t-bowzer/KCPico/docs/KeybChord_Pico_Spec.md

# KeybChord (Pico Edition) — Requirements & Specification

**Project:** KeybChord — Raspberry Pi Pico (RP2040) Edition
**Description:** Turn any USB keyboard into an Omnichord-style MIDI controller using a Raspberry Pi Pico (RP2040), written in C++ on the Arduino-Pico core.
**Document status:** v1 (Pico port) — build-ready. Derived from the Raspberry Pi Zero 2 W spec (`KeybChord_Spec.md` v3). This edition retargets the project to a bare-metal RP2040 microcontroller: the firmware is C++ (not Python), keyboard input is via a **CH559 USB-host coprocessor** (not Linux `evdev`), MIDI output is **DIN/TRS + USB MIDI**, persistence is **JSON on LittleFS** (not SD/JSON files), and there is **no OS/systemd** (the board runs on power-up). Two minor items remain open (LCD line-2 layout and final rhythm list, Section 14) and are flagged inline with **[DRAFT — REVIEW]**; both are deferred to post-hardware testing and do not block implementation.
**Target audience:** Coding agent implementing the firmware.

---

## 1. Overview & Goals

### 1.1 Summary
KeybChord is a standalone MIDI controller. A standard USB keyboard is plugged into a Raspberry Pi Pico (RP2040), which acts as a **USB host** to enumerate the keyboard, interprets key presses as Omnichord-style musical actions (chords, strum plate, rhythm accompaniment), and emits MIDI over a 5-pin DIN connector (UART). An LCD1602 provides status and parameter feedback. The keyboard's Scroll Lock LED is used as a BPM indicator.

### 1.2 Goals
- Faithfully recreate the Omnichord playing paradigm (chord buttons + strum plate + rhythm) on a commodity USB keyboard.
- Emit standards-compliant MIDI via DIN (UART @ 31250 baud).
- Provide expressive, real-time control with low latency (<10 ms key-to-MIDI).
- Persist configuration via 40 recallable presets (5 banks × 8) on the Pico's onboard flash (LittleFS).

### 1.3 Non-Goals (v1)
- No onboard audio synthesis. KeybChord is a **MIDI controller only**; sound is produced by an external synth/DAW.
- No graphical UI beyond the LCD1602.
- No network/Bluetooth MIDI.

### 1.4 Implementation Constraints
- **Language:** C++17.
- **Platform / core:** Arduino-Pico core (earlephilhower) targeting RP2040 (Raspberry Pi Pico / Pico W).
- **Build system:** PlatformIO, with two environments — an on-device `pico` environment and a desktop `native` environment for unit-testing the pure-logic core.
- **USB keyboard input:** a **CH559** (WCH) acts as a USB **host** coprocessor, enumerating the keyboard (boot and/or report protocol, incl. NKRO) and forwarding parsed key events to the RP2040 over a UART bridge. There is no OS input layer; the keyboard is owned exclusively by the firmware.
- **MIDI output:** DIN and TRS via hardware UART (`Serial2` = UART1) at 31250 baud, 8N1, plus a USB MIDI device on the native USB port (see 3.4). DIN is the always-available path.
- **Persistence:** JSON on **LittleFS** in the Pico's onboard flash, parsed/serialized with ArduinoJson. Human-readable and user-editable via the flash filesystem.
- **No FPU:** RP2040 (Cortex-M0+) has **no hardware floating-point**. All timing-sensitive and per-event math (chord/voicing/strum/rhythm/clock) MUST be integer or fixed-point. In particular, **swing is stored and computed as a fixed-point integer** (see Sections 7.3 and 9). Floats are permitted only in cold paths (e.g. one-time config parsing), never in the real-time loops.
- **Portable core / hardware adapters:** All pure logic (chord/voicing/strum/rhythm computation, config/preset handling, keymap resolution, state) MUST have zero hardware/Arduino includes and be unit-testable on a desktop (`native` env) via GoogleTest. All hardware I/O (USB-host input, LCD, DIN/UART, keyboard LED, LittleFS) sits behind adapter interfaces with safe null/no-op fallbacks so the logic compiles and runs on the dev host without Pico hardware present.
- **No OS / autostart:** There is no operating system or systemd. The firmware runs from flash on power-up; "boot-to-ready" is simply the setup path (Section 10, NFR-4).
- **Project layout & VCS:** Self-contained PlatformIO project under a dedicated `keybchord/` directory, version-controlled with git. Default JSON templates ship in the repo (`data/`, flashed to LittleFS); generated/runtime files live on LittleFS on the device and are not committed.

### 1.5 Recommended Libraries (pinned defaults)
These are the recommended, commonly-used libraries for this hardware/stack. The agent may substitute with justification, but should keep the stack internally consistent.
| Purpose | Library | Notes |
|---|---|---|
| RP2040 Arduino core | `arduino-pico` (earlephilhower) | Provides Arduino API, dual-core (`setup1/loop1`), TinyUSB, LittleFS, hardware UARTs (`Serial1`/`Serial2`) |
| USB host stack | CH559 (WCH) USB-host coprocessor (8051 C firmware) over a UART bridge | HID keyboard host incl. hubs + report/NKRO; key events forwarded to the RP2040 over UART |
| DIN MIDI (UART) | Arduino `Serial2` (UART1, raw bytes) | 31250 baud 8N1; optional `Arduino MIDI Library` for framing |
| LCD1602 over PCF8574 I2C | `hd44780` (by Bill Perry) or `LiquidCrystal_I2C` | PCF8574 I/O-expander mode over `Wire` |
| JSON parse/serialize | `ArduinoJson` (bblanchon) | Config/preset/pattern read/write on LittleFS |
| Filesystem | `LittleFS` (bundled with core) | Onboard-flash persistence |
| Unit testing (desktop) | `GoogleTest` | `native` PlatformIO env; pure-core tests (Section 11) |

### 1.6 Deliverables & Build Sequence
The agent will produce the entire firmware project. Work in the following ordered steps; after each step, stop and present the result for the user to test and give feedback before proceeding.

1. **Repo structure & scaffolding.** Create the PlatformIO project layout, `platformio.ini` with `pico` + `native` environments and pinned library deps (per 1.5), entry point (`src/main.cpp` with `setup/loop` and `setup1/loop1`), a config loader that generates default `config.json` and default preset banks on LittleFS on first boot (Section 12.x robustness), and hardware adapter interfaces with null fallbacks (input, LCD, MIDI out, keyboard LED, storage) so the pure core builds and runs on the `native` host. Verify: firmware builds for `pico`; native test target builds; app logic initializes and loads/creates config.
2. **Core framework.** Implement Input Manager (USB-host HID keyboard via the CH559 coprocessor + UART bridge), State Manager, MIDI Router (DIN via `Serial2`/UART1), Config/Preset store (LittleFS + ArduinoJson), and a **minimal USB-CDC debug log + MIDI monitor** (raw key events in, outgoing MIDI messages out) — the on-device feedback instrument for steps 2–5, since the LCD does not arrive until step 6. Verify: raw key events are captured on-device and observed via the USB-CDC debug log; a hardcoded note plays on the DIN output and appears in the MIDI monitor (and null-logs on the native host). No LCD required.
3. **Chord engine.** Root/quality resolution from the key grid, same-column + left-adjacent + leftmost combination matrix, voicing (root-position & smart), extensions, and the four play modes with correct note lifecycle. Verify: chords and combinations produce correct notes; play modes behave per spec.
4. **Strum plate.** Note-pool derivation, full + limited numpad layouts (independent of the keyboard's Num-Lock state), strum params, immediate edit pickup. Verify: strumming plays the active chord's notes correctly in both layouts.
5. **Rhythm engine.** Scheduler/clock (on the second core), JSON pattern playback on ch10, tempo/swing (fixed-point), mute, MIDI clock toggle, arpeggio/bass sync, and the keyboard-LED BPM indicator (FR-R8). Verify: patterns play; tempo/swing/mute/clock behave; Scroll Lock LED flashes on the beat when rhythm is enabled.
6. **Display manager.** LCD1602 idle screen (with dirty `*` indicator), parameter-edit feedback, and prompts. Verify: screen updates correctly for all events.
7. **Presets & banks.** JSON load/save on LittleFS, 80-slot navigation, save/clear with confirm (auto-cancel), per-function channels, defaults for uninitialized slots. Verify: presets save/recall/clear correctly.
8. **Polish.** Panic control, latency tuning, robustness/hot-plug, config validation/fallback, and **hardening/finalizing** the logging + MIDI monitor (over USB-CDC or UART debug) first introduced in step 2, and the full test suite. Verify: acceptance criteria (Section 13) pass.

---

## 2. Hardware Requirements

### 2.1 Bill of Materials
| Item | Purpose |
|---|---|
| Raspberry Pi Pico (RP2040) | Main compute unit (Pico W also fine; W's wireless is unused in v1) |
| USB keyboard | Primary input device |
| USB-A receptacle / breakout | Host port for the keyboard, wired to the **CH559** HP/HM pins. Receptacle pinout: pin 1 = VBUS (5V), pin 2 = D-, pin 3 = D+, pin 4 = GND. |
| CH559L (USB host coprocessor) | WCH 8051 MCU with a **hardware USB host controller**, hosting hubs + full-length descriptors + report/NKRO protocols and forwarding key events over UART (see 2.2). Replaces the PIO-USB software host. Powered from `3V3(OUT)`; runs off its internal oscillator (no crystal). |
| 2× 22Ω resistors (1/4 W) | **Required** series resistors on the CH559 HP/HM (D+/D-) lines. These are the only series elements on D+/D-; the keyboard supplies its own device-side pull-ups. |
| 2× 0.1 µF ceramic capacitors | Decoupling on the CH559 `VIN5` (pin 41) and `VDD33` (pin 42). |
| 1× tactile switch (BOOT) | CH559 bootloader entry — pulls `P4.6/XI/SCS` (pin 16) to `GND`; hold at power-up (see `docs/wiring.md` §Flashing the CH559). |
| 1× 4-pin 0.1" (2.54 mm) male header | CH559 **programming header** — `DP` (31), `DM` (32), `GND`, and `3V3` (intentionally **NC** on the v0.2 PCB). Mates with a USB-A plug breakout pigtail for flashing (see `docs/wiring.md` §Flashing the CH559). |
| LCD1602 display + PCF8574 I2C backpack | Status / parameter display. **Operated at 3.3V** so its I2C bus stays 3.3V-safe for the RP2040 (see 2.2). |
| 5-pin DIN socket (DIN-5, 180°) | Classic MIDI output. |
| 3.5 mm TRS (Type-A) MIDI out jack | Secondary MIDI output, wired **in parallel** with the DIN current loop (shares the same 10Ω/33Ω loop resistors — no additional parts). TRS Type-A: tip = DIN pin 5 (data), ring = DIN pin 4 (source), sleeve = DIN pin 2 (GND). See 2.2. |
| 1× 10Ω + 1× 33Ω resistor (1/4 W) | MIDI OUT current-loop resistors for a **3.3V** loop (10Ω in series with the `GP8` TX line, 33Ω from `3V3(OUT)` to DIN pin 4 — also fed to the TRS ring), per the MIDI 1.0 Electrical Specification update (2014), which standardizes 3.3V signaling. See 2.2. |
| 1× 100 µF electrolytic capacitor (bulk) | Bulk decoupling on the 5V rail near the keyboard receptacle; absorbs hot-plug inrush and prevents Pico brownout / USB-stack wedge (see 2.3, NFR-5). |
| 5V power source (≥ 1 A recommended), optionally **switched** | Powers the Pico + keyboard. **Canonical topology:** power the Pico via its native micro-USB connector; the keyboard draws 5V from `VBUS`. Size the supply for both (Pico ≤ ~150 mA + keyboard 100–500 mA; more for backlit/RGB keyboards). A regulated 5V into `VSYS` is an alternative, but do **not** source both simultaneously without an external `VSYS` series Schottky diode (see 2.3). A **master power switch** is **recommended but not required**; because the micro-USB→`VBUS` path is a direct board trace, the switch lives off-board — an inline USB power switch or a switched PSU (see 2.3). |

> **Resistor wattage:** all resistors in this design (2× 22Ω USB series, 10Ω + 33Ω MIDI loop) dissipate only milliwatts in normal operation, so standard **1/4 W (0.25 W)** parts are used throughout with large margin.

> **Note vs. the Pi Zero 2 W BOM:** the micro-USB-to-USB-OTG adapter is **removed** (no longer applicable). A USB MIDI interface/cable is **removed** (no USB MIDI device role — DIN only). USB hub is **not required** and is not part of the design.

### 2.2 Connections

This is the **canonical default pin map**. GPIO are given with their physical Pico header pin numbers. The only supported overrides are the CH559 UART pins and the DIN/I2C pins (via `pins.h`); the wiring below and the firmware defaults must always agree. The authoritative map lives in the roadmap (§5.2).

- **Keyboard (USB host, CH559L coprocessor on UART0):** USB keyboard → USB-A receptacle → **CH559L** → Pico `Serial1` (UART0). **`GP0` (header pin 1) = TX → CH559 `RXD1` (pin 27), `GP1` (header pin 2) = RX ← CH559 `TXD1` (pin 28)**. The CH559 **HP** (pin 29) / **HM** (pin 30) run to the receptacle through **22Ω series resistors** (the only series elements; the keyboard provides device-side pull-ups); `DP` (pin 31) / `DM` (pin 32) go to a 4-pin programming header (its `3V3` pin is intentionally **NC** on the v0.2 PCB). **Power:** `VIN5` (pin 41) and `VDD33` (pin 42) both to `3V3(OUT)` (0.1 µF decoupling; the internal LDO is bypassed below 3.6 V), `GND` (pin 18). `P4.6/XI/SCS` (pin 16) is the **BOOT** input (button to `GND`, hold at power-up); there is no board RESET button, so `RST` (pin 3) is left unconnected and a power-cycle resets the CH559. Signaling is full/low-speed USB at 3.3V logic levels. The keyboard is powered from `VBUS` (5V, header pin 40) + GND through the receptacle (receptacle pin 1 = VBUS, pin 2 = D-, pin 3 = D+, pin 4 = GND). The CH559 runs its own 8051-C host firmware and forwards parsed key events to the RP2040 over UART.
- **LCD1602 (I2C):** SDA→`GP4` (header pin 6), SCL→`GP5` (header pin 7) on I2C0. **VCC→3.3V (`3V3(OUT)`, header pin 36), GND→GND** — the backpack is run at 3.3V so the I2C bus stays within the RP2040's 3.3V range (do not power the backpack from 5V without a level shifter). Pull-ups: use the backpack's onboard pull-ups, or add 4.7 kΩ from SDA/SCL to 3.3V if absent. The firmware auto-probes the PCF8574 address at boot: try `0x27`, then `0x3F`; if neither ACKs, fall back to the null LCD adapter (no crash, per NFR-5). (`GP4`/`GP5` are the fixed default, chosen to avoid the UART and SPI pins.)
- **DIN MIDI out (UART, 3.3V current loop):** DIN uses **`Serial2` (UART1), TX on `GP8` (header pin 11)**, chosen to avoid the UART0 (`GP0`/`GP1`) and I2C (`GP4`/`GP5`) pins. In firmware, call `Serial2.setTX(8)` before `Serial2.begin(31250)` (UART1's default TX pin is not guaranteed to be `GP8`). MIDI OUT is driven **directly from the 3.3V `GP8` TX pin** — a standards-compliant 3.3V current loop per the MIDI 1.0 Electrical Specification update (2014). Wiring: `GP8` → 10Ω → DIN pin 5; `3V3(OUT)` (header pin 36) → 33Ω → DIN pin 4; GND → DIN pin 2. 31250 baud, 8N1. Notes: the RP2040 UART TX is push-pull, not open-drain — a benign deviation from the letter of the spec that works with standard opto-isolated MIDI inputs (see references, roadmap §5.5); optional ferrite beads on the DIN signal pins reduce RFI (2014 update, optional). No transistor/level-shifter is required at 3.3V.
- **TRS MIDI out (3.5 mm, Type-A, parallel with DIN):** A 3.5 mm TRS jack carries the same signal as the DIN loop, wired in parallel so both connectors work simultaneously (driving a second receiver on the same current loop is within the MIDI 1.0 spec). Type-A pinout: **tip = DIN pin 5** (data, the `GP8`→10Ω node), **ring = DIN pin 4** (source, the `3V3(OUT)`→33Ω node), **sleeve = DIN pin 2** (GND). No firmware change and no additional resistors are required.
- **Keyboard LEDs (BPM indicator):** The keyboard's Scroll Lock LED is driven by sending a **HID Output Report (SET_REPORT)** to the keyboard over the USB-host connection (FR-R8). No additional wiring required.

> **Pin-assignment rule:** CH559 UART0 (`GP0`/`GP1`), `Serial2`/UART1 TX (DIN, `GP8`), and I2C0 SDA/SCL (`GP4`/`GP5`) must not overlap. Pins are set in exactly one place — `pins.h` (CH559 UART, DIN TX, I2C) — which is the single source of truth mirrored by the wiring above. The canonical map is `GP0`/`GP1` (CH559 UART), `GP8` (DIN TX), `GP4`/`GP5` (I2C0); confirm on hardware during M12 bring-up and keep this section and roadmap §5.2 in sync.

> A rendered connection diagram of this pin map is in [`docs/wiring.md`](docs/wiring.md).

### 2.3 Hardware Notes & USB Topology
- The Pico has **one native USB port**. In this design that port is **not** used for the keyboard: instead, a **CH559L USB host coprocessor** on UART0 hosts the keyboard. The native USB port is left free for power and/or a USB-CDC debug/log console + USB MIDI device during development.
- **No host-vs-gadget conflict:** The keyboard is hosted on the CH559 (UART bridge) while USB MIDI + CDC live on the native USB port as a *device*, so there is **no** USB role conflict of the kind that affected the Pi Zero 2 W. This is a deliberate simplification of the original design risk.
- **Guaranteed MIDI path:** DIN (UART) is the always-available MIDI path. All functionality works over DIN; USB MIDI and TRS are additive.
- **Power (canonical):** Power the Pico via its native micro-USB connector; the keyboard draws 5V from `VBUS`. Use a supply rated **≥ 1 A** (Pico ≤ ~150 mA + keyboard 100–500 mA; size up for backlit/RGB keyboards). The 5V supply, USB cable, and connector must carry the **combined** Pico + keyboard current. (The keyboard load taps `VBUS`, which is *upstream* of the Pico's onboard `VBUS`→`VSYS` Schottky diode **D1**, so the keyboard current does not pass through D1.) Fit a **100 µF bulk capacitor** on the 5V rail near the keyboard receptacle to absorb hot-plug inrush and prevent Pico brownout / USB-stack wedge (supports NFR-5; a watchdog is the secondary safeguard).
  - **Master power switch (recommended, not required):** the Pico's micro-USB connector is soldered **directly** to `VBUS`, so there is no on-board break point for a master switch. A switch that cuts both the Pico *and* the keyboard therefore lives **off-board** — an **inline USB power switch** on the 5V cable or a **switched PSU** — rather than on the PCB. (A switch in `VBUS`→`VSYS` is *not* a master switch: it only cuts the Pico, leaving the keyboard's `VBUS` tap hot; `3V3_EN`/`RUN` also leave the board powered.)
  - **Back-feed safety rule:** The Pico already has an onboard Schottky (**D1**) between `VBUS` and `VSYS`. If you power an *alternative* way by injecting a regulated 5V into `VSYS`, do **not** also power via native USB unless that external `VSYS` feed goes through its **own series Schottky diode** (per the Raspberry Pi "Powering Pico" guidance) — otherwise the two sources fight through D1. Pick one power path. The `VSYS`-fed option is for hungry keyboards; the canonical native-USB→`VBUS` path needs no extra diode.
- **LCD 3.3V rail budget:** The LCD is powered from `3V3(OUT)` (header pin 36), which is the RP2040's onboard 3.3V regulator output (≈ 300 mA total, shared with the RP2040 itself). A plain LCD1602 + PCF8574 backpack draws only a few mA, but a **backlit** module can pull 20–40 mA; if using a high-draw/backlit LCD, keep it within the `3V3(OUT)` budget or power its backlight from a separate rail.
- **USB host maturity:** Full-speed/low-speed HID keyboard hosting (incl. hubs and long descriptors) is handled by the CH559 coprocessor. N-key rollover is limited by the *keyboard's* HID report protocol (boot protocol commonly caps at 6 simultaneous keys) — see NFR-6.

---

## 3. System Architecture

### 3.1 Module Overview
The system is a set of cooperating modules coordinated by a central state manager, split across the RP2040's **two cores**.

| Module | Responsibility |
|---|---|
| Input Manager | Receive parsed key events from the CH559 over the UART bridge; track pressed keys & modifiers; debounce; emit semantic input events. |
| Keymap Resolver | Translate raw HID usage codes + modifier state into logical actions (chord select, function toggle, strum, navigation). |
| Chord Engine | Maintain active chord state; compute voicings; handle play modes (held/press-to-play/arpeggio/silent). |
| Strum Engine | Map strum keys to notes of the current chord; apply strum params. |
| Bass Engine | Walking bass line driven by the rhythm beat; own octave/duration/velocity/channel. |
| Rhythm Engine | Sequencer/clock; emit GM drum notes on ch10; provide timing to chord arpeggio sync and the walking bass; tempo & swing (fixed-point). |
| MIDI Router | Emit MIDI messages to the DIN/UART output; per-function channel routing. |
| Display Manager | Render idle screen and transient parameter-edit screens on LCD1602. |
| LED Indicator | Drive the keyboard's Scroll Lock LED via HID Output Report; flash the BPM indicator in sync with the Rhythm Engine clock (FR-R8). |
| Preset/Config Store | Load/save global config and 40 presets as JSON on LittleFS. |
| State Manager | Owns global runtime state; mediates between modules; central source of truth (incl. `pending_params` vs `active_params`). |

### 3.2 Cores, Event Loop & Timing
- **Core 0 — real-time input and output path:** USB-host polling → Input Manager → Keymap Resolver → engines mutate state → MIDI Router dispatch over UART. Target key-to-MIDI latency <10 ms (NFR-1). Rhythm/clock MIDI from Core 1 is drained by a priority service at the top of the loop, between input events, and before LCD/UI work. UART writes are effectively non-blocking at MIDI baud for the small messages involved.
- **Core 1 — rhythm/clock scheduler:** a monotonic-time scheduler (`micros()` / `time_us_64()` / hardware timer) drives tempo/swing, rhythm steps, MIDI-clock ticks (24 PPQN), arpeggio sync, the walking bass, and the Scroll Lock LED beat callback. Target step jitter <2 ms (NFR-2). LED HID writes happen here, off the Core 0 critical path.
- **Shared state:** the State Manager mediates cross-core access; the scheduler reads a consistent snapshot of chord/arp params. Use lightweight synchronization appropriate to RP2040 dual-core (e.g. the SDK's spin-lock/`mutex`/inter-core FIFO or double-buffered snapshots). Keep shared mutable state minimal.
- **No FPU:** all real-time math (Section 1.4) is integer/fixed-point; swing in particular is fixed-point (Sections 7.3, 9).

### 3.3 Data Flow
`CH559 host (USB) → UART bridge` → Input Manager → Keymap Resolver → (Chord | Strum | Bass | Rhythm | Nav | Param) action → State Manager → engines produce MIDI events → MIDI Router → DIN/UART. Display Manager and LED Indicator observe State Manager / scheduler for updates.

### 3.4 MIDI Output Detail
- **DIN/UART:** Open `Serial2` (UART1) at 31250 baud, 8N1; write raw MIDI bytes.
- **USB MIDI device (native USB):** the RP2040's native USB port presents a TinyUSB **composite CDC (debug log) + MIDI** device; the MIDI router fans every outgoing message to the USB MIDI interface. USB MIDI is gated by `midi.usb_enabled` (default on); when off, the interface still enumerates but no bytes are sent.
- Per-function channel/route is applied per message (chord/strum/rhythm channels, Section 4.5).
- The output must degrade gracefully if nothing is connected on the far end (the firmware keeps transmitting; an unconnected DIN is not an error).
- The keyboard is hosted on the **CH559 coprocessor** (over UART0), so the native USB port is free for power + CDC debug + USB MIDI — there is no host/gadget role conflict.

---

## 4. Functional Requirements

### 4.1 Chord Function
- **FR-C1** Letter keys act as chord buttons per the Key Map (Section 5). Each letter selects a chord root/type.
- **FR-C2** Chord button combinations follow Omnichord logic (Section 6.3), e.g. major+7th = maj7, minor+7th = min7, major+minor = diminished.
- **FR-C3** Supported play modes (all v1). Note lifecycle is specified in FR-C10:
  - *Held:* chord sounds on trigger and sustains until the next chord is pressed or panic/cancel is used (see FR-C10).
  - *Press-to-play:* chord triggers once on press (note-on), releases on key-up.
  - *Arpeggio:* chord notes played sequentially in one of several patterns (see 6.7); when rhythm is enabled, arpeggiation follows rhythm timing.
  - *Pattern:* chord tones played through the selected chord pattern's 16th-note grid (6.10), in lockstep with the rhythm clock; momentary (releases on key-up).
  - *PatternHold:* like *Pattern*, but latches on key release until the next chord / cancel.
  - *Silent (strum-only):* no chord notes sounded directly; chord defines the note pool for the strum plate only.
- **FR-C4** Adjustable chord parameters: note duration, velocity, pan (CC10), chord roll, minimum note count, minimum interval, inversion, arpeggio mode, arpeggio rate, and chord pattern, via the Chord Edit menu (5.4). Values shown on LCD when edited.
- **FR-C5** Chord octave shift via `+` / `-` keys (Section 5), clamped to a sensible MIDI range.
- **FR-C6** Voicing mode is a live-toggleable parameter (`root_position` ⇄ `smart` voice-leading), saved per-preset (see Section 6.4).
- **FR-C7** Chord extensions (add9, add11, add13) are **held modifiers**, not toggleable parameters. Holding `Left` arrow adds add9, `Down` arrow adds add11, and `Right` arrow adds add13 to the currently-held chord (they latch per chord; see 5.4). They are **not** saved per-preset.
- **FR-C8** Left-adjacent chord combinations (newer Omnichord behavior): Major + left-adjacent 7th = **sus4**; Major + left-adjacent Minor = **add9**. Leftmost column uses the `` ` `` key as modifier source (see 6.3).
- **FR-C9** **Parameter latching in Held mode:** while chord mode is `held`, changing any chord parameter (note duration, velocity, pan, octave, voicing mode, chord roll, min notes, min interval, inversion, arp mode, arp rate, channel, chord type/combination) — **including loading a preset** — must NOT alter notes that are currently sounding. The change takes effect only on the **next** chord triggered. The currently-held chord retains the parameter values it was triggered with until it is released and re-triggered. (In other play modes, parameter changes may apply on the next note event per that mode's timing.)
- **FR-C10** **Note lifecycle per play mode:**
  - *Held:* chord sounds on trigger and sustains **indefinitely** until the next chord is pressed or the panic/cancel control is used. Pressing a new chord ends the previous one.
  - *Press-to-play:* note-on on key press; note-off on **key-up**.
  - *Arpeggio:* each arpeggiated note lasts `note_duration_ms` (chord param); the `arp_rate` subdivision sets the step timing from the free-running 24-PPQN master clock, so notes stay aligned with the beat LED whether or not the rhythm engine is running. If an arpeggiated chord starts within **30 ms before** the next arp step boundary, its first note is deferred to that boundary instead of sounding immediately (which would otherwise place the first two notes only milliseconds apart). Presses at/after the boundary or earlier than the window start immediately.
  - *Pattern / PatternHold:* each step's degree notes sound for `sustain_steps` (or `note_duration_ms` when percussive); the grid follows the rhythm clock when enabled, else the stored tempo.
  - *Silent:* no chord notes are sounded (strum pool only).
- **FR-C11** **Panic / all-notes-off:** `Super+Esc` immediately sends All-Sound-Off (CC120) and All-Notes-Off (CC123) on all channels to the DIN output, and clears internal active-note state. Used to recover from stuck notes.
- **FR-C12** **Chord press grouping:** chord-grid presses within a 15 ms window are treated as one chord event. This prevents a combination such as `T` + `B` (Cmaj7) from sounding the first key's chord and then the combination when the two keys arrive in consecutive USB reports. A quick tap that releases all keys before the window expires still triggers the grouped chord.

### 4.2 Strum Plate
- **FR-S1** Number keys simulate the strum plate, playing the notes of the currently selected chord spread across octaves. Per preset, the **top-row** keys `1`…`0` may instead be macro keys (FR-S9); the numpad is always the strum plate.
- **FR-S2** Two layouts:
  - *Full:* number row (top-of-keyboard number keys `1 2 3 4 5 6 7 8 9 0`) and/or full numpad. The numpad strum set is `Num Lock / * 0 . 1 2 3 4 5 6 7 8 9` (the top-row keys `Num Lock`, `/`, `*` are included). The numpad `Keypad +` / `Keypad -` keys are **NOT** part of the strum plate; they adjust the strum octave (see 5.5).
  - *Limited strum keys* (toggle): numpad center path `0 → . → 2 → 3 → 5 → 6 → 8 → 9 → / → *` for a more realistic feel.
- **FR-S3** Strum parameters (via the Strum Edit menu, 5.5): octave, note duration, note velocity, layout, strum mode, strum root, scale. Shown on LCD when edited.
- **FR-S7** Strum mode selects the note-pool source: **follow-chord** (default; the active chord's pitch classes, 6.6), **scale** (a selectable root pitch class + scale/mode — the standard major/minor/harmonic/melodic scales, the 7 modes, and pentatonic/blues), or **piano** (a selectable root; each strum key is one semitone higher than the last).
- **FR-S8** Note duration is a **minimum**: a held strum key sustains its note past `note_duration_ms` until the key is released; a quick tap still sounds for the full minimum duration.
- **FR-S4** Strum notes are derived from the active chord voicing (including in Silent mode).
- **FR-S5** Unlike Held-mode chords (FR-C9), the strum plate picks up parameter and chord edits **immediately** — the next strummed note reflects current parameters and the currently-selected chord, with no latching. During sequencer playback the currently sounding sequence chord becomes the selected chord, so FollowChord strumming tracks the sequence; a held/latched live chord still takes priority.
- **FR-S6** Numpad strum keys are identified via their raw HID **keypad usage codes** and behave identically **regardless of the keyboard's Num Lock state** (the firmware interprets keypad usages directly; Num Lock is ignored). The firmware never asserts Num Lock as a precondition.
- **FR-S9** **Per-preset top-row macros:** when `number_keys` is `"macro"`, the top-row keys `1`…`9`,`0` trigger ordered per-preset command bundles instead of strumming. Each command is a `set` / `toggle` / `cycle` / `inc` / `dec` parameter action, a per-piece `drum_mute`, or a raw `midi` byte sequence (including SysEx, with an optional cumulative `delay_ms`). Parameter actions apply atomically on key-down, with changes committed before mode/arp/pattern callbacks; MIDI commands are sent to DIN and USB immediately or at their scheduled delay. Each macro has a name (default `M1`…`M9`, `M0`, max 16 chars); the LCD shows `Macro <name> loaded`. Limits are 16 commands per key and 48 per preset (excess is truncated by the firmware; the configurator rejects it). `Super+1`…`Super+8` still loads presets. Macros are configured in the configurator; on-device Save preserves them and Clear resets them.

### 4.3 Rhythm Function
- **FR-R1** Selectable rhythm modes providing backing percussion, including original Omnichord rhythms plus additional patterns (Section 7).
- **FR-R2** Percussion output can be muted (rhythm timing continues for sync; drum notes suppressed).
- **FR-R3** Rhythm emits GM percussion notes on **MIDI channel 10**.
- **FR-R4** The Chord Engine's Arpeggio mode follows the free-running master clock (the same timebase as the beat LED and rhythm), including when the rhythm engine is stopped. Early arp starts are quantized: a chord starting within 30 ms before the next arp step boundary waits for that boundary, so the first two notes never bunch together. Chord-pattern starts are fully quantized to the rhythm: while the rhythm is running, step 0 always waits for the next rhythm step boundary. The walking bass (4.7) follows rhythm beat timing while the rhythm runs and free-runs at the preset tempo when it is stopped.
- **FR-R5** Tempo adjust via `Page Up` / `Page Down`; swing (and other rhythm parameters) adjust in the Rhythm Edit menu (`F10`, see 5.6).
- **FR-R6** Rhythm patterns are defined as step sequences in JSON on LittleFS (Section 7.2).
- **FR-R9** Per-drum-piece **note code** and **velocity** are editable (Drum Edit menu, opened by `Super+F11`; 5.6): every percussion instrument used by the shipped rhythms — kick, snare, hi-hat, open-hat, rimshot, clap, crash, ride, bongo, conga-lo, conga-hi, clave, and shaker — can be remapped to a different GM percussion note and given a fixed velocity (or "Auto" to follow the pattern's authored step velocity, or "Off" to mute the piece). Cycling a code auditions the selected sound once. Velocity parameters auto-repeat while the step key is held.
- **FR-R7** MIDI clock transmission (24 PPQN) can be toggled on/off in the Rhythm Edit menu (Clock Out, see 5.6); when on, clock is sent to the DIN output. Clock Out is **clock-only**: switching it **on** waits for the next 24-tick beat boundary (the same tick as the beat LED) and then streams `0xF8`; switching it **off** stops the stream immediately. No Start/Stop is sent automatically. **Double-tapping the Clock Out key (`F8` by default)** arms an explicit Clock Resync: MIDI Start (`0xFA`) is sent at the next 24-tick beat boundary, immediately before that tick's clock, so a slave that was stopped or restarted locally re-aligns with the beat LED. Resync also ensures Clock Out is on.
- **FR-R8** **Keyboard-LED BPM indicator:** the keyboard's **Scroll Lock** LED can flash in time with the Rhythm Engine clock as a visual tempo indicator. Default behavior: a short quarter-note flash on every beat, with a longer accented flash on beat 1 of the bar. The LED is driven by sending a **HID Output Report (SET_REPORT)** to the hosted keyboard. It blinks only while the Rhythm Engine is enabled (follows the active clock), and is disabled if `led.bpm_indicator` is off. Scroll Lock is used because it is not mapped to any chord/strum/function key; Caps Lock and Num Lock LEDs are left untouched to avoid confusion (Caps is a chord root; numpad state is irrelevant per FR-S6). This is best-effort visual feedback and must degrade gracefully if the LED is unavailable (missing keyboard, keyboard that rejects the output report, USB write failure) without affecting timing or MIDI output.

### 4.4 Presets
- **FR-P1** Presets store chord, strum, bass, and rhythm parameters plus MIDI channel assignments, the top-row `number_keys` mode, macro definitions, and own **10 chord-sequence slots** (sequences are stored per preset in `/sequences/`, 4.8/8.4).
- **FR-P2** 40 slots: 5 banks × 8 presets.
- **FR-P3** **Cursor navigation:** `Home` / `End` move a preset **cursor** (wraps across all 40 slots). The cursor auto-resets to the active slot after `display.cursor_timeout_ms` of idleness (default 5 s). `Enter` loads the slot under the cursor.
- **FR-P4** Move the cursor to the previous/next bank: `Super + Home/End` (wraps; the slot position is preserved).
- **FR-P5** Load preset in current bank: `Super + <number 1–8>` (loads directly), or move the cursor and press `Enter`.
- **FR-P6** Save preset: `Insert` (prompt: `Enter` to confirm, `Backspace` to cancel).
- **FR-P7** Clear preset: `Delete` (same confirm/cancel prompt; resets the live parameters and stores factory defaults).
- **FR-P8** All prompts and current bank/slot reflected on the LCD.
- **FR-P9** **Default initialization:** every preset slot that has never been saved (or has been cleared) loads factory-default parameters (see Parameter Reference, Section 9). There are no "empty" slots that fail to load.
- **FR-P10** **Prompt auto-cancel:** save/clear confirmation prompts auto-cancel after **5 seconds** of no key press. Additionally, pressing any chord or strum key immediately cancels the prompt (so the user can keep playing).
- **FR-P11** **Dirty-state indicator:** when the active runtime parameters differ from the stored values of the current preset, the LCD shows a dirty marker (`*`) next to the preset location. Saving clears the marker; loading a preset resets it.
- **FR-P12** **Default channels:** on default initialization, MIDI channels differ per function — chord = 1, strum = 2, bass = 3, rhythm = 10. The user may edit these; overlaps are permitted and are the user's responsibility.

### 4.5 MIDI Output
- **FR-M1** MIDI output via **DIN (UART)** and **USB MIDI (native USB device)**. Both outputs carry the same messages (the router fans out to both); USB MIDI can be disabled via `midi.usb_enabled` without affecting DIN.
- **FR-M2** Independent MIDI channels selectable per function (chord / strum / bass / rhythm), saved as part of the preset.
- **FR-M3** Rhythm defaults to channel 10 (GM percussion) but channel is configurable per FR-M2.
- **FR-M4** The system continues without error if the DIN cable is disconnected or nothing is listening (it keeps transmitting).

### 4.6 Info Display (LCD1602)
- **FR-D1** Idle screen shows the current chord name and preset location, with a dirty marker (`*`) when the active state differs from the stored preset, e.g.:
  ```
  Ebmaj7    *B1:P3
  q=120  Rk  >Held
  ```
  (Line 1: active chord + optional `*` dirty marker + bank/preset. Line 2: tempo, rhythm short-code, play mode — final layout **[DRAFT — REVIEW]**.)
- **FR-D2** Parameters are edited through six **parameter edit menus** (Chord, Rhythm, Strum, Bass, Drum, and Sequence; see 5.4–5.10), plus the three-kind **Pattern Edit** mode for bass, rhythm, and chord patterns (4.9, 5.11). Inside a menu the LCD shows the menu title on line 1 and the highlighted parameter on line 2. `Up`/`Down`/`Left`/`Right` and volume +/− scroll the parameter highlight; `Enter`/`Mute` select it. While selected, the same keys change the value live (shown as a transient full name/value screen) and the parameter remains selected indefinitely; `Enter`/`Mute` commits and deselects, while `Backspace`/`Esc` restores the value captured on selection and deselects. An unselected (browsing) menu auto-exits after `display.menu_timeout_ms`.
- **FR-D3** Save/clear/confirm prompts are shown on the LCD, including the auto-cancel behavior (FR-P10).

### 4.7 Bass Function (Walking Bass)
- **FR-B1** A **walking bass** line plays alongside the chord, following the Rhythm Engine's beat. It is a **separate engine** with its own parameters and edit menu (5.9); it is toggleable on/off (default off) and usable in Held, Press-to-play, and Arpeggio chord modes (silent in Silent mode).
- **FR-B2** The bass plays a fixed looping **interval cycle** on each beat of the bar (see 6.8): root → 3rd → 5th → 6th/7th → (repeat). The cycle length adapts to the pattern's meter (`beats_per_bar`; a 3/4 waltz cycles over root–3rd–5th only).
- **FR-B3** Bass voice parameters (5.9): enable, octave (whole-octave transpose from the base root, default −1), note duration, velocity, pattern, and MIDI channel (default 3; may equal any other function's channel). The bass follows the currently-selected chord's root and type (including in Held mode after key release).
- **FR-B4** The bass note is short/percussive (note-on with rapid note-off after `note_duration_ms`), mimicking the Omnichord's plucked double-bass "thump". It follows the rhythm clock's beat edges while the rhythm is running, and free-runs on the same 16th-note grid at the preset tempo when the rhythm is stopped, so the bass remains audible without drums (and resyncs to the shared step counter when the rhythm starts).
- **FR-B5** **Configurable bass patterns** (`bass.pattern`, 5.9): bass patterns are JSON files in `/bass/*.json` (the 9 built-ins plus user files, loaded like rhythm patterns). The built-ins are `Walking` (root-3rd-5th-6th/7th), `Whole`, `Half`, `Quarter`, `Half Alt`, `Quarter Alt`, `3/4 Alt`, `No 6th`, and `Hold` (root sustains while the chord is sounding — a held key in Press/Arp, indefinitely in Held). Patterns are a 16th-note grid of chord-degree codes (root/3rd/5th/6th-or-7th) so they follow the chord's root and type; whole/half notes sustain via an optional `sustain_steps` array. The beat-driven patterns fire on the rhythm 16th-note grid in lockstep with the drums.

### 4.8 Chord Sequencer (M14)
- **FR-Q1** Each preset owns **10 sequence slots** (selectable with `Ctrl+1`…`Ctrl+0`), stored in `/sequences/b<N>p<M>.json` as a compact JSON array of up to 10 slots. A slot is a loop of **1, 2, 4, or 8 bars** on the rhythm 16th-note grid, with a maximum of **64 chord-change events**. Selecting a different slot during playback queues it: the current sequence finishes its loop, then the new slot starts on its downbeat and continues looping. Selecting an empty slot stops playback at that boundary with `Seq empty`.
- **FR-Q2** **Recording:** arm record (`Ctrl+F9`). The normal rhythm pattern is muted immediately. The hi-hat guide stays **silent until the next bar boundary**, then plays **exactly one bar** of quarter-note closed hi-hats (downbeat accented), and recording begins at the bar boundary after that count-in bar. The hi-hat guide continues for the whole take. Only chord changes are recorded (no strum, no individual MIDI notes); onsets are quantized to the nearest 16th. Each event sustains until the next event or the loop end. When the take ends (auto or manual), the guide stops and the original pattern/mute state resumes. If the rhythm engine is disabled when record or play is pressed, it is enabled automatically and the drums are muted before the count-in/playback starts. Recording over a slot that already contains a sequence prompts `Overwrite Seq in slot N?` (Enter/Mute confirms, Backspace/Esc cancels) before anything is armed.
- **FR-Q3** **Settings snapshot:** at the start of a recording, the current chord parameters (octave, note duration, velocity, pan, voicing, chord roll, min notes, min interval, inversion, arp mode, chord pattern, play mode, arp rate) are captured once for the sequence. Playback honors the merged play mode, so recorded arpeggios and patterns reproduce; `PressToPlay` behaves as `Held` and `ArpHold`/`PatternHold` as their non-hold forms because sequence events have no key release. The MIDI channel is always live.
- **FR-Q4** **Playback:** arm play (`Ctrl+F10`), then playback loops from the next rhythm bar until stopped. Recorded settings are used per-setting unless that setting's **Live** bit is set in the configurator, or the on-device global switch is set to **Live** (then all settings, including play mode and arp rate, are live). Playback is synced to the rhythm clock.
- **FR-Q5** **Live override:** live chords remain available during playback. While a live chord is held or latched, sequence events are skipped; the sequence keeps advancing and resumes at the next event after the live chord ends.
- **FR-Q6** **Persistence and clearing:** sequences are per-preset, not copyable. Recording, bar changes, and clearing save the sequence file immediately. Clearing a preset (`Delete`) removes its sequence file. The firmware removes legacy preset banks 6–10 from v0.1 on boot to reclaim flash; users should back them up before upgrading.
- **FR-Q7** **On-device menu:** `Ctrl+F12` opens the **Seq Edit** menu (Slot / Bars / Settings). Default performance keys: `Ctrl+F9` record, `Ctrl+F10` play/stop, `Ctrl+F11` clear (confirm with `Enter`/`Backspace`), `Ctrl+1`…`Ctrl+0` select sequence slots 1–10. All actions are rebindable in `keymap.json` except `Ctrl+number`. The count-in/recording status uses a **persistent LCD screen** (`Rec arm`/`Wait bar`, then `Count-in`/`1 bar`, then `Recording N/M`) so it does not flash back to idle between bar updates.
- **FR-Q8** **Configurator editor:** a full per-preset sequence editor edits events on a bar/step grid with a chord picker (root, type, add9/add11/add13), bar length, the recorded settings snapshot, and per-setting Live checkboxes. The configurator rejects more than 64 events and invalid chord IDs; the firmware truncates excess events.

### 4.9 Bass, Rhythm & Chord Pattern Editors (M17)

- **FR-E1** On-device **Pattern Edit** screens create and edit user rhythm, bass, and chord patterns and can overwrite built-ins. Each pattern type has its own editor screen (Chord Pattern, Rhythm Pattern, Bass Pattern); there is no in-editor kind selector. A screen is opened by an **Edit Pattern** item at the end of its Chord/Rhythm/Bass parameter menu, or by direct keys: `Super+F9` (chord), `Super+F10` (rhythm), and `Super+F12` (bass) by default. These are rebindable `open_menu` actions using the menu names `chord_pattern`, `rhythm_pattern`, and `bass_pattern`. Each editor opens with the active preset's currently selected pattern for that type.
- **FR-E2** The editor works on an in-memory copy. Nothing is written until **Save** or **Save As**; leaving with unsaved changes prompts `Discard?`. **New** runs a guided flow: enter a name (prefilled with the unique default), choose Bars (1, 2, 4, or 8), then answer `Record now?` / `Ent/Bk`. Accepting starts the count-in immediately; declining keeps the new pattern in the command menu and shows `New Pat N` / `Created`. Esc during name or bars cancels creation and restores the previous pattern. New patterns inherit the live rhythm meter (`steps_per_bar`: 16 in 4/4, 12 in 3/4). Editing preserves the pattern's existing meter and length; the stored length is `bars * steps_per_bar`.
- **FR-E3** **Recording:** the user selects Bars and Quantize (`1/4`, `1/8`, or `1/16`, default `1/16`), then Record. If the rhythm engine is off it is enabled for the session (and restored on exit) and its normal pattern is suppressed. Recording follows the M14 count-in: one bar of quarter-note closed hi-hats (downbeat accented), then N bars are recorded while the hi-hat guide continues; recording stops automatically at the end of the take. A pad pressed before the first recorded step is ignored. Live chord-grid keys remain available; the top-row strum/macro path is disabled, and keypad keys are captured as pattern pads instead of the normal strum path.
- **FR-E4** **Recording pads:** Rhythm uses the 13 Num-Lock-independent numpad keys in canonical order (`1`–`9`, `0`, `.`, `/`, `*` = kick, snare, hi-hat, open-hat, rimshot, clap, crash, ride, bongo, conga-lo, conga-hi, clave, shaker). Bass uses numpad `1`–`5` = root/3rd/5th/6th-or-7th/root-one-octave-up and `0` = rest. Chord patterns use numpad `1`–`4` = root/3rd/5th/7th and `0` = clear; multiple degree pads at one step combine into the step's bitmask. A pad press auditions the sound and records at the nearest quantized step. Rhythm and chord-pattern recording are polyphonic; bass recording is monophonic (the last degree at a step wins). Rhythm hits record velocity `1` (default) or `127` (accent) as edited; bass and chord holds capture `sustain_steps` for the number of steps held.
- **FR-E5** **Overdub:** recording preserves steps and tracks that the take does not touch. Rhythm pads add/replace only their own track's step; chord degree pads add bits to the step; bass pads replace the degree at the step. A **Clear** command resets the working buffer to rests when a fresh take is wanted.
- **FR-E6** **Preview:** loops the working pattern from the next rhythm bar until stopped. The normal rhythm/bass playback is suppressed. Rhythm plays through the preset drum map; bass and chord patterns resolve their degrees through the current/last selected chord (C major if none). Live chords remain available; a live chord that takes over playback stops the preview, which can be restarted. Preview works before saving.
- **FR-E7** **Grid editor:** a two-line LCD editor. Rhythm selects one of the 13 standard pieces (Up/Down), shows one bar of 16/12 step cells, moves the cursor with Left/Right across steps and bars, and cycles `rest → hit → accent` with Enter. Bass shows degree cells and cycles `rest → root → 3rd → 5th → 6th/7th`; sustained steps display as `-`. Chord shows each step as a hex digit `0`–`F`; the line above decodes the cursor step's degrees, numpad `1`–`4`/`0` toggle bits, and sustained steps display as `-`. The cursor cell is shown as `>`; editing a sustained step breaks its sustain. Custom-note rhythm tracks are preserved but not editable on device.
- **FR-E8** **Save/New/Rename/Delete:** `New` prompts for the pattern name and Bars and then offers `Record now?`, creating a user pattern in `/rhythms/userN.json`, `/bass/userN.json`, or `/chordpatterns/userN.json`; declining recording shows the two-line confirmation (`New Pat N` / `Created`, where N is the user-file number); `Save` overwrites the current file (built-in overwrite requires confirmation); `Save As` creates a new user file; `Rename` edits a user pattern's name using the preset name-entry flow; `Delete` removes a user pattern after confirmation. Built-ins cannot be renamed or deleted. Pattern names must be unique. The 32-total cap per kind and the combined pattern-file budget (8.5) are enforced; a save that would exceed either is rejected with `Pattern limit`.
- **FR-E9** **Compatibility and exclusion:** files use the existing rhythm/bass/chord JSON schemas; no new fields are required, and `bars` is inferred from `steps.length / steps_per_bar`. On-device and configurator writes use compact JSON (like sequence files) so the pattern budget stays predictable. On save the runtime library reloads and the saved pattern becomes the preset's selected pattern; presets store pattern names, so file ordering does not break references. On-device-created patterns appear in the configurator editors. Opening the pattern editor stops sequence recording/playback; starting a sequence stops the editor. Write actions are disabled while the MSC drive is active. Panic/all-notes-off stops recording and preview.
- **FR-E10** **Live pads and pass-through:** while the bass editor is open, the plain numpad pad keys play the bass (`KP1`–`KP5` = root/3rd/5th/6th-or-7th/root+8va, `KP0` = rest) using the current chord and the preset bass parameters; while the rhythm editor is open, the 13 numpad pad keys play drums through the preset `DrumMap` and rhythm channel; while the chord editor is open, `KP1`–`KP4` play root/3rd/5th/7th through the current/last chord, combining when several pads are held without retriggering already-held degrees, and `KP0` releases the live chord/clears the step. Pads audition outside recording and also write the pattern while recording. Bass/rhythm live pads work in command, grid, record, preview, and value-selected states; chord live pads work in those states except the chord grid, where `KP1`–`KP4`/`KP0` keep their bit-toggle editing role. Live pads do not work during name entry or confirmation prompts. Chord-grid keys remain live in every state. Direct parameter-modifying keymap actions (`cycle`/`set`/`inc`/`dec`/`toggle`, drum mute, tap tempo) also remain active, including while a value item is selected. Two exceptions keep the pattern editors emitting: in the rhythm editor, actions targeting `RhythmMute` (default F6) are ignored and the rhythm is forced unmuted for the session; in the bass editor, actions targeting `BassEnable` (default F7) are ignored and the bass is forced enabled. The rhythm editor restores the preset's prior mute/enable state on exit; the bass editor leaves the bass enabled so the edited pattern plays through the normal bass engine. The editor reserves its navigation keys (arrows, Volume +/− in menus/grid/value editing, Enter/Mute, Esc/Backspace, plain numpad); menu-open/preset/sequence/strum/top-row actions remain editor-owned, and the top-row strum/macro path stays disabled. Modified numpad keys are not live pads and follow their keymap actions; the numpad `+`/`−`/`Enter` keys are not live pads and retain their normal parameter actions. `F2`/`F3`/`F4` are not editor shortcuts; they retain their normal parameter actions.

---

## 5. Key Map

The chord grid faithfully reproduces the Omnichord's 3×12 button layout (5.1). Because `Shift` is used as a chord root, function access uses dedicated keys and menus rather than modifier combos (5.3).

### 5.1 Chord Buttons — Authentic Omnichord 3×12 Grid
The Omnichord exposes 36 chord buttons: three quality rows (Major / Minor / 7th) × twelve roots ordered around the **circle of fifths**. KeybChord reproduces this exactly by treating each of the three main keyboard rows as a quality row and using the row-bounding modifier keys as the outermost columns.

**Raw-HID requirement:** The firmware parses HID keyboard reports directly and owns the keyboard exclusively (there is no OS). This lets us treat `Caps Lock`, `Tab`, and both `Shift` keys as ordinary held keys (present in the report = held; absent = released), independent of any lock-LED semantics. Modifier bytes and key-array usages are read from the report. Consequently, **Shift is a chord root and is NOT used as a function modifier** anywhere in the key map — function access uses the dedicated menu keys and `Super` (see 5.3+).

**Row = quality, Column = root (circle of fifths, left→right):**
| Col | 1 | 2 | 3 | 4 | 5 | 6 | 7 | 8 | 9 | 10 | 11 | 12 |
|-----|---|---|---|---|---|---|---|---|----|----|----|----|
| **Root** | Db | Ab | Eb | Bb | F | C | G | D | A | E | B | F# |
| **Major** (top row) | `Tab` | `Q` | `W` | `E` | `R` | `T` | `Y` | `U` | `I` | `O` | `P` | `[` |
| **Minor** (home row) | `Caps` | `A` | `S` | `D` | `F` | `G` | `H` | `J` | `K` | `L` | `;` | `'` |
| **7th** (bottom row) | `LShift` | `Z` | `X` | `C` | `V` | `B` | `N` | `M` | `,` | `.` | `/` | `RShift` |

> The circle-of-fifths root order (Db Ab Eb Bb F C G D A E B F#) mirrors the authentic Omnichord OM-series button layout. This order is stored in config (Section 8.3) so it can be adjusted. Column 1 uses `Tab`/`Caps`/`LShift`; column 12 uses `[`/`'`/`RShift`.

**Same-column combinations** (same root — see matrix 6.3): Major `W` + 7th `X` = Eb7; Major `W` + Minor `S` + 7th `X` = Eb augmented.

**Left-adjacent combinations** (newer Omnichord models): pressing a Major key together with the **7th key one column to its left** yields **sus4**; pressing a Major key together with the **Minor key one column to its left** yields **add9**. See 6.3 for the full rule and the leftmost-column special case.

### 5.2 Strum Plate (number keys / numpad)
The three main letter rows plus their bounding modifiers are fully consumed by the chord grid (5.1). The strum plate therefore uses the **number row** and/or the **numpad**. Numpad keys are identified by their raw keypad HID usages and are **Num-Lock-independent** (FR-S6). The top row is strum by default; a preset can set `number_keys` to `"macro"` to use `1`…`0` as macro keys (FR-S9), leaving the numpad as the strum plate.
| Keys | Function |
|---|---|
| Number row `1 2 3 4 5 6 7 8 9 0` | Strum across chord notes (Full layout), or trigger macros when the preset's `number_keys` is `"macro"` |
| Numpad digits + decimal `0 . 1 2 3 4 5 6 7 8 9` + `Num Lock` `/` `*` | Strum (Full layout). `Keypad +`/`Keypad -` are excluded — they adjust the strum octave (5.5). `Num Lock`, `/` and `*` (the numpad top row) extend the full strum plate. |
| Limited strum path `0 . 2 3 5 6 8 9 / *` | Strum (Limited layout, when enabled) |

### 5.3 Function Modifier Convention
Because `Shift` (both keys) is a chord root, **Shift is never used as a function modifier**. Parameter editing uses dedicated menu keys: `F9`/`F10`/`F11`/`F12` open the Chord/Rhythm/Strum/Bass menus, `Super+F11` opens Drum, and `Ctrl+F12` opens the sequencer menu (see 5.4–5.10). The matching pattern editors are `Super+F9`, `Super+F10`, and `Super+F12` (5.11). Arrows/volume scroll parameters and `Enter`/`Mute` select one for editing.

Consumer/media keys (`Mute`, `PlayPause`, `Stop`, transport keys, browser keys,
`Calculator`, `Mail`, etc.) are configurable in `keymap.json` when the keyboard
exposes a Consumer Control collection (separate interface or QMK-style shared
keyboard/consumer report). The keyboard's **Mute** key is hard-coded to behave
exactly like `Enter` (select/commit in menus, confirm prompts). The **Volume +/−**
keys are hard-coded: on the main screen they step tempo; inside an edit menu they
scroll parameters while browsing and change the selected value once selected
(with repeat).

- **`F9`** — opens the **Chord Edit** menu (toggle).
- **`F10`** — opens the **Rhythm Edit** menu (toggle).
- **`F11`** — opens the **Strum Edit** menu (toggle).
- **`F12`** — opens the **Bass Edit** menu (toggle).
- **`Super+F9`** — opens the **Chord Pattern Edit** mode.
- **`Super+F10`** — opens the **Rhythm Pattern Edit** mode.
- **`Super+F11`** — opens the **Drum Edit** menu (toggle).
- **`Super+F12`** — opens the **Bass Pattern Edit** mode.
- **`Ctrl+F12`** — opens the **Seq Edit** menu (sequence slot / bars / settings).
- **`Ctrl+F9`** — arm/stop sequence recording; **`Ctrl+F10`** — arm/stop sequence playback; **`Ctrl+F11`** — clear the selected sequence (confirm with `Enter`).
- **`Ctrl+1`…`Ctrl+0`** — select sequence slots 1–10 (global; overrides Ctrl+number strum).
- **`Super`** (`Windows` key) — global/system modifier, used for preset navigation/save/clear (5.7), panic (5.8), and the pattern-editor shortcuts above. The target keyboard has no `Fn` key, so the `Windows`/`Super` key is used. (Stored in config as `global_fn: "super"`.)
- **`Esc` / `Backspace`** — while a parameter is selected, cancel its edits, restore the original value, and return to scrolling; when browsing, exit the edit menu. `Esc` also cancels prompts.
- **`Esc`** (held at **power-on only**) — reboot into the USB bootloader (`RPI-RP2` drive) so the Pico can be reflashed over USB without opening the enclosure.
- **`Ctrl`** — held at **power-on only**, to also present the USB Mass Storage drive (M9); it has no runtime function. Ejecting the drive from the host reboots the firmware automatically so it reloads the edited files.

Inside an edit menu, **chord and strum keys remain live** so a parameter change can be heard immediately without leaving the menu.

### 5.4 Function Keys — Chord Controls & the Chord Edit Menu

Main-menu single-key shortcuts (no menu):

| Key | Action |
|-----|---|
| `F1` | Cycle play mode (Held → Press-to-play → Arpeggio → Arp-Hold → Silent → Pattern → Pattern-Hold) |
| `F2` | Toggle voicing mode (Root-position ⇄ Smart voice-leading) |
| `Left` arrow | Hold to add **add9** to the current chord (FR-C7) |
| `Down` arrow | Hold to add **add11** to the current chord (FR-C7) |
| `Right` arrow | Hold to add **add13** to the current chord (FR-C7) |
| `PrtSc` | First inversion |
| `ScLk` | Second inversion |
| `Pause` | Third inversion |
| `+` / `-` (number row `=` / `-`) | Chord octave up / down |

**Chord Edit menu** — opened by `F9`. Scroll with arrows/volume, select with `Enter`/`Mute`, then edit the selected value:

| Order | Parameter | Range / cycle |
|---|---|---|
| 1 | Octave | −3..+3 (step 1) |
| 2 | Mode | Held / Press / Arp / Arp-Hold / Silent / Pattern / Pattern-Hold |
| 3 | Voicing | Root / Smart |
| 4 | Duration | 50..4000 ms (step 50) |
| 5 | Velocity | 1..127 |
| 6 | Pan | 0..127 |
| 7 | Roll | −2000..+2000 ms (step 10; positive = up, negative = down) |
| 8 | Min Notes | 2..6 (default 3) |
| 9 | Min Interval | 0..12 semitones (0 = off) |
| 10 | Inversion | Root / 1st / 2nd / 3rd |
| 11 | Arp Mode | Up / Down / Up-Down / Alternating / Random |
| 12 | Arp Rate | Whole / Half / Quarter / Eighth / 16th / 32nd |
| 13 | Pattern | Built-in + user chord patterns (6.10) |
| 14 | Edit Pattern | Opens the Chord Pattern Edit mode (5.11) |

### 5.5 Function Keys — Strum Controls & the Strum Edit Menu

Main-menu single-key shortcut:

| Key | Action |
|-----|---|
| `Keypad +` / `Keypad -` | Strum octave up / down (the numpad math keys are free because they are excluded from the strum plate, FR-S2) |

**Strum Edit menu** — opened by `F11`. Scroll with arrows/volume, select with `Enter`/`Mute`, then edit the selected value:

| Order | Parameter | Range / cycle |
|---|---|---|
| 1 | Octave | −3..+3 (step 1) |
| 2 | Duration | 50..4000 ms (step 50) |
| 3 | Velocity | 1..127 |
| 4 | Layout | Full / Limited |
| 5 | Mode | Follow-Chord / Scale / Piano (FR-S7) |
| 6 | Root | C..B (cycle, pitch class; used by Scale/Piano) |
| 7 | Scale | Ionian/Dorian/Phrygian/Lydian/Mixolydian/Aeolian/Locrian/Harmonic-Minor/Melodic-Minor/Major-Pentatonic/Minor-Pentatonic/Blues (Scale mode only) |

### 5.6 Rhythm Controls & the Rhythm Edit Menu

Main-menu single-key shortcuts (no menu):

| Key | Action |
|-----|---|
| `F4` | Select rhythm pattern (cycle) |
| `F5` | Enable/disable rhythm |
| `F6` | Mute/unmute percussion |
| `F7` | Toggle the walking bass |
| `F8` | Toggle MIDI clock transmit (Clock Out, FR-R7). Double-tap = Clock Resync. |
| `Page Up` / `Page Down` | Tempo up / down |

**Rhythm Edit menu** — opened by `F10`. Scroll with arrows/volume, select with `Enter`/`Mute`, then edit the selected value:

| Order | Parameter | Range / cycle |
|---|---|---|
| 1 | Tempo | 40..260 BPM (step 1) |
| 2 | Swing | −75..+75 (step 5) |
| 3 | Pattern | cycle the 12 rhythms |
| 4 | Mute | On / Off |
| 5 | Enable | On / Off |
| 6 | Clock Out | On / Off (MIDI clock transmit, FR-R7) |
| 7 | Beat LED | On / Off (BPM indicator, FR-R8) |
| 8 | Edit Pattern | Opens the Rhythm Pattern Edit mode (5.11) |

**Drum Edit menu** — opened by `Super+F11` (the keymap's Drum menu action).
Scroll with arrows/volume, select with `Enter`/`Mute`, then edit the selected
piece's code/velocity live (cycling a code auditions it once; `Backspace`/`Esc`
cancels the edit):

| Order | Parameter | Range / cycle |
|---|---|---|
| 1 | Kick note | 0..127 (default 36) |
| 2 | Kick velocity | Auto / 1..127 (Auto = follow pattern) |
| 3 | Snare note | 0..127 (default 38) |
| 4 | Snare velocity | Auto / 1..127 |
| 5 | Hi-Hat note | 0..127 (default 42) |
| 6 | Hi-Hat velocity | Auto / 1..127 |
| 7 | Open-Hat note | 0..127 (default 46) |
| 8 | Open-Hat velocity | Auto / 1..127 |
| 9–10 | Rimshot note/vel | 0..127 (default 37) |
| 11–12 | Clap note/vel | 0..127 (default 39) |
| 13–14 | Crash note/vel | 0..127 (default 49) |
| 15–16 | Ride note/vel | 0..127 (default 51) |
| 17–18 | Bongo note/vel | 0..127 (default 61) |
| 19–20 | Conga-Lo note/vel | 0..127 (default 62) |
| 21–22 | Conga-Hi note/vel | 0..127 (default 63) |
| 23–24 | Clave note/vel | 0..127 (default 75) |
| 25–26 | Shaker note/vel | 0..127 (default 82) |

**Inside any edit menu:** while browsing, `Up`/`Down`/`Left`/`Right` and volume
+/− scroll the parameter highlight (wrapping); `Enter`/`Mute` selects it. While a
parameter is selected, those same keys change its value. Large-range parameters
(tempo, velocity, pan, durations, swing) auto-repeat while a value key is held
(≈500 ms delay, then ≈80 ms interval); small-range parameters (octave, enums,
toggles) step once per press. `Enter`/`Mute` commits the value and deselects;
`Backspace`/`Esc` restores the value captured on selection and deselects. A
selected parameter never times out; an unselected menu auto-exits after
`display.menu_timeout_ms` (default 10 s).

`F1`–`F12` are inert inside edit menus (they retain their main-menu shortcuts
outside menus; the menu-open keys `F9`–`F12`, `Super+F11`, and `Ctrl+F12` still
open/switch menus).

### 5.7 Preset & Navigation
| Key | Action |
|-----|---|
| `Home` / `End` | Move the preset **cursor** previous/next (wraps across all 40 slots) |
| `Super + Home/End` | Move the cursor to the previous/next bank (wraps; slot preserved) |
| `Super + 1..8` | Load preset N in current bank (direct load) |
| `Enter` | Load the slot under the cursor (while browsing) |
| `Esc` | Exit cursor navigation (reset the cursor to the active slot) |
| `Insert` | Save preset (confirm `Enter` / cancel `Backspace`) |
| `Delete` | Clear preset (confirm `Enter` / cancel `Backspace`) |

While browsing (cursor active), the LCD shows the cursor location with a `>`
marker instead of the dirty `*`. Any hotkey (e.g. `F1`, `F7`, arrows) cancels
cursor navigation and is handled normally; chord/strum keys stay live and keep
the cursor open. The cursor auto-resets after 5 s of idleness.

### 5.8 Global / MIDI
| Key | Action |
|-----|---|
| `Ctrl+F5` | Toggle the beat LED on/off (main-menu shortcut, FR-R8) |
| `Space` | **Tap tempo:** average the intervals of the most recent taps (up to 8) to set the rhythm tempo; a >2 s gap starts a fresh set |
| `Ctrl` (held at power-on) | Also present the USB Mass Storage drive (M9); no runtime function. Ejecting it reboots to reload the files. |
| `Esc` (held at power-on) | Reboot into the USB bootloader (`RPI-RP2`) to reflash the Pico without opening the enclosure |
| `Super + Esc` | **Panic:** All-Sound-Off + All-Notes-Off on all channels/DIN output (FR-C11) |
| `Ctrl + Esc` | Hard-coded debug screen: firmware version and current git commit; any key dismisses it |
| `Esc` | Exit the current edit menu / cancel the current prompt |

> **Note on modifiers:** all modifiers are read from the HID report modifier byte (`LCtrl/LShift/LAlt/LGui/RCtrl/RShift/RAlt/RGui`). `Shift` is a chord root. `Alt`/`Menu` have no runtime function. `Ctrl` is the power-on boot key and also carries the sequence controls (`Ctrl+1..0`, `Ctrl+F9..F12`). The parameter menus are on `F9`–`F12`; `Super+F11` opens Drum; `Ctrl+F12` opens Seq Edit. The pattern editors are `Super+F9`, `Super+F10`, and `Super+F12`. `Esc` is the power-on bootloader key. `Super` is the global modifier for presets/panic and the pattern-editor shortcuts.

### 5.9 Bass Controls & the Bass Edit Menu

Main-menu single-key shortcut:

| Key | Action |
|-----|---|
| `F3` | Toggle the walking bass on/off (FR-B1) |

**Bass Edit menu** — opened by `F12`. Scroll with arrows/volume, select with `Enter`/`Mute`, then edit the selected value:

| Order | Parameter | Range / cycle |
|---|---|---|
| 1 | Enable | On / Off |
| 2 | Octave | −3..+3 (step 1; default −1) |
| 3 | Duration | 50..4000 ms (step 50; default 150) |
| 4 | Velocity | 1..127 (default 90) |
| 5 | Channel | 1..16 (default 3) |
| 6 | Pattern | Walking / Whole / Half / Quarter / Half-Alt / Quarter-Alt / 3/4-Alt / Hold (default Walking, FR-B5) |
| 7 | Edit Pattern | Opens the Bass Pattern Edit mode (5.11) |

### 5.10 Sequencer Controls & the Seq Edit Menu

| Key | Action |
|-----|---|
| `Ctrl+1`…`Ctrl+9`, `Ctrl+0` | Select sequence slot 1–10 for the active preset |
| `Ctrl+F9` | Arm recording; recording starts at the next rhythm bar. Press again to stop and save. |
| `Ctrl+F10` | Arm playback; playback starts at the next rhythm bar. Press again to stop. |
| `Ctrl+F11` | Clear the selected sequence (Enter confirms, Backspace/Esc cancels) |
| `Ctrl+F12` | Open the **Seq Edit** menu |

**Seq Edit menu** — opened by `Ctrl+F12`. Scroll with arrows/volume, select with `Enter`/`Mute`, then edit the selected value:

| Order | Parameter | Range / cycle |
|---|---|---|
| 1 | Slot | 1–10 (also selectable with Ctrl+number) |
| 2 | Bars | 1 / 2 / 4 / 8 |
| 3 | Settings | Recorded / Live (global override; per-setting Live bits are edited in the configurator) |

If the rhythm engine is disabled, recording and playback enable it automatically and mute the drums. Recording mutes the normal pattern immediately and stays silent until the next bar boundary, then plays **exactly one bar** of quarter-note closed hi-hats; recording starts at the following bar boundary and the guide continues through the take. Recording over an existing sequence shows `Overwrite Seq in` / `slot N? Ent/Bk`; Enter/Mute confirms and Backspace/Esc cancels. The count-in/recording screen is persistent (`Rec arm`/`Wait bar`, then `Count-in`/`1 bar`, then `Recording N/N`) so it does not flash back to idle between bars. Other LCD messages: `Seq saved`, `Seq N play`, `Seq stop`, `Seq full`, `Seq empty`, `Seq cleared`.

### 5.11 Bass, Rhythm & Chord Pattern Editor Controls (M17)

| Key | Action |
|-----|---|
| `Super+F9` | Open the **Chord Pattern** editor |
| `Super+F10` | Open the **Rhythm Pattern** editor |
| `Super+F12` | Open the **Bass Pattern** editor |
| `F9` → **Edit Pattern** / `F10` → **Edit Pattern** / `F12` → **Edit Pattern** | Open the matching editor from the corresponding parameter menu |

All three direct shortcuts are rebindable `open_menu` actions (`chord_pattern`, `rhythm_pattern`, `bass_pattern`).

**Command screen** — each type has its own screen, titled `Chord Pattern`, `Rhythm Pattern`, or `Bass Pattern`; there is no Kind parameter. Up/Down/Left/Right or Volume +/− scroll the command list; Enter/Mute selects a value item. While selected, the same keys change the pending value; Enter/Mute applies it and returns to the command list; Esc/Backspace cancels it and returns to the command list. Action items execute on Enter/Mute; while browsing, Esc/Backspace exits the editor (with `Discard?` if dirty).

| Order | Item | Values / action |
|---|---|---|
| 1 | Pattern | Cycle the current type's built-in + user patterns |
| 2 | New | Create a new user pattern |
| 3 | Bars | 1 / 2 / 4 / 8 |
| 4 | Quantize | 1/4, 1/8, 1/16 (recording snap; default 1/16) |
| 5 | Grid | Open the step grid |
| 6 | Record | Start/stop a count-in take |
| 7 | Preview | Start/stop a loop of the working pattern |
| 8 | Rename | Rename the current user pattern |
| 9 | Save | Overwrite the current file (confirm for built-ins) |
| 10 | Save As | Save a copy as a new user pattern |
| 11 | Delete | Delete the current user pattern (confirm) |
| 12 | Clear | Reset the working buffer to rests (confirm) |

While the editor is open, plain numpad pad keys are live as described in FR-E10; the top-row strum/macro path remains disabled. Direct parameter-modifying keymap actions and chord-grid keys stay active even while a value is selected, except the matching mute/disable action in the rhythm and bass editors (the editor forces its own emit state for the session). In the chord editor, `KP1`–`KP4` combine as live chord tones and `KP0` releases them; in the chord grid those keys retain bit-toggle editing. Recording and preview stop with `Enter`/`Mute` or `Esc`/`Backspace` and return to the command screen.

**Grid screen** — Left/Right moves the cursor across steps and bars; Up/Down selects a rhythm piece (or changes the bar for bass/chord); Enter/Mute edits the cell for rhythm/bass and advances the cursor for chord patterns; `Esc`/Backspace returns to the command screen. The cell under the cursor is shown as `>`.

| Kind | Cell display | Editing |
|---|---|---|
| Rhythm | `.` rest, `x` hit, `X` accent | Enter cycles rest → hit → accent |
| Bass | `.` rest, `R`/`3`/`5`/`7` degree, `-` sustained | Enter cycles rest → root → 3rd → 5th → 6th/7th |
| Chord | hex `0`–`F` bitmask, `-` sustained | Numpad `1`–`4` toggle root/3rd/5th/7th; `0` clears |

**Numpad pads (Num-Lock-independent; recording and live audition):**

| Kind | Pads |
|---|---|
| Rhythm | `1`–`9`, `0`, `.`, `/`, `*` = the 13 standard drum pieces |
| Bass | `1`–`5` = root/3rd/5th/6th-or-7th/root+8va; `0` = rest |
| Chord | `1`–`4` = root/3rd/5th/7th (combine); `0` = clear |

Recording and preview require the live rhythm meter to match the working pattern's `steps_per_bar`; otherwise the editor shows `Meter mismatch`. New patterns inherit the live meter. Recording is overdub; the **Clear** command starts fresh. Plain numpad pads also play live outside recording (FR-E10). See 4.9 and 6.13 for behavior and 8.5 for storage/budget.

---

## 6. Chord Theory & Voicing Rules

Voicings are **rule-based**: the engine computes MIDI notes from a root + chord type. No hardcoded per-chord note tables required. **All computation is integer** (MIDI note numbers and semitone offsets) — no floating point is used anywhere in the chord/voicing/strum path (RP2040 has no FPU, Section 1.4).

### 6.1 Roots
Roots are MIDI note numbers. Base octave is configurable (default C4 = MIDI 60 as chord root reference). Root pitch class is determined by the selected chord button (Section 5.1); the octave is set by the chord octave parameter (FR-C5).

### 6.2 Chord Type Interval Formulas
Intervals are semitone offsets from the root (0).
| Type | Intervals (semitones) |
|---|---|
| Major (maj) | 0, 4, 7 |
| Minor (min) | 0, 3, 7 |
| Dominant 7 (7) | 0, 4, 7, 10 |
| Major 7 (maj7) | 0, 4, 7, 11 |
| Minor 7 (min7) | 0, 3, 7, 10 |
| Diminished (dim) | 0, 3, 6 |
| Diminished 7 (dim7)| 0, 3, 6, 9 |
| Augmented (aug) | 0, 4, 8 |
| Suspended 4 (sus4) | 0, 5, 7 |
| Suspended 2 (sus2) | 0, 2, 7 |
| Minor 7 flat 5 (m7b5) | 0, 3, 6, 10 |

Chord **extensions** (FR-C7) are **held modifiers** — upper tensions applied while the corresponding arrow key is held (see 5.4): add9 (+14), add11 (+17), add13 (+21). They latch for the currently-sounding chord and are **not persisted** as parameters. Note: the left-adjacent `add9` combination (6.3) sets the add9 flag for that chord.

### 6.3 Omnichord Combination Matrix
Two categories of combination exist: **same-column** (same root, combine qualities) and **left-adjacent** (a Major key plus a key in the column immediately to its left).

**Same-column (same root):**
| Held combination | Resulting chord |
|---|---|
| Major only | Major triad |
| Minor only | Minor triad |
| 7th only | Dominant 7 |
| Major + 7th | Major 7 (maj7) |
| Minor + 7th | Minor 7 (min7) |
| Major + Minor | Diminished |
| Major + Minor + 7th | Augmented |

**Left-adjacent (newer Omnichord models):** the root/quality is taken from the **Major key pressed**; the left-adjacent key selects the modifier.
| Held combination | Resulting chord |
|---|---|
| Major(col N) + 7th(col N−1) | **sus4** (on Major's root) |
| Major(col N) + Minor(col N−1) | **add9** (on Major's root) |

**Leftmost-column special case (col 1, no column to the left):** use the backtick key `` ` `` as the modifier source:
| Held combination | Resulting chord |
|---|---|
| Major(col 1 = `Tab`) + `` ` `` | **sus4** (on col-1 root, Db) |
| Minor(col 1 = `Caps`) + `` ` `` | **add9** (on col-1 root, Db) |

> All combination rules — same-column, left-adjacent, and the leftmost-column `` ` `` mapping — are data-driven (lookup tables in config, Section 8.3) so they can be tuned without code changes. Left-adjacency is computed from `chord_root_order` column indices.

### 6.4 Voicing & Inversion Rules
Voicing behavior is controlled by a **chord voicing-mode parameter** (`root_position` | `smart`), toggled live via `F5` (5.4) and saved per-preset.
- **VR-1 Root position mode:** notes placed in root position within a target octave window; keep all notes within a configurable range (default C3–C6 for chord notes).
- **VR-2 Smart voice-leading mode:** when moving between chords, choose the inversion nearest the previous voicing to minimize note movement (integer distance comparison). Both modes are first-class and user-selectable (no single default is "correct").
- **VR-3** Octave shift (FR-C5) transposes the whole voicing by ±12 semitones per step, clamped to MIDI 0–127.
- **VR-4** Pan is applied as CC10 on the chord channel; velocity from the chord velocity param.
- **VR-6 Minimum note count (`min_notes`):** if the chord has fewer distinct notes than `min_notes`, extra octave notes are appended (root +12, then 5th +12, …) in ascending order until the count is met. Default 3 (e.g. C major with `min_notes`=4 → `C E G C`; Cmaj7 with `min_notes`=5 → `C E G B C`).
- **VR-7 Minimum interval spread (`min_interval`):** no two adjacent notes in the voicing are closer than `min_interval` semitones. Notes are chosen greedily in the tightest ascending configuration — start at the bass selected by the active voicing mode; each next note is the smallest chord pitch-class ≥ previous + `min_interval`. Root position starts at the root (or the pinned inversion tone); smart/up/down choose the spread inversion and octave that best follow the previous voicing, so the modes remain effective when `min_interval` is enabled. `0` disables it. (e.g. C major, `min_interval`=5 → `C3 G3 E4`; `min_interval`=4 → `C3 G3 E4`.)
- **VR-8 Manual inversions:** `PrtSc`/`ScLk`/`Pause` select 1st/2nd/3rd inversion, respectively — determining whether the 1st, 3rd, or 5th of the chord is the bass (3rd inversion uses the 7th when the chord has one). The inversion bass is selected by its position in the chord's **interval formula** (root/3rd/5th/7th), never by the sorted pitch-class list, so it is correct for every root. The ascending note set is rotated so the chosen tone is lowest, then placed within range. When the requested inversion index exceeds the chord's own tones (e.g. the 3rd inversion of a triad with no 7th), the selection wraps into the next octave so it stays distinct from the lower inversions. Composes with smart voice-leading (the bass is pinned; the remaining notes minimize movement).
- **VR-9 Chord roll (`chord_roll_ms`):** in Held/Press-to-play modes the chord notes are staggered by `|chord_roll_ms|` ms apart (positive = ascending, negative = descending) instead of sounding simultaneously. Note-offs release together.
- **VR-5 Parameter snapshot on trigger (Held mode):** When a chord is triggered, the engine takes a snapshot of all sounding-relevant chord parameters (voicing mode, octave, note duration, velocity, pan, chord roll, min notes, min interval, inversion, arp mode, arp rate, channel, and the resolved chord type). The active voice uses this snapshot for its entire lifetime. Subsequent parameter edits (including loading a preset) update only the "pending" parameter state and are applied to the next chord trigger, never mutating an already-sounding held chord (see FR-C9). Implementation: maintain separate `pending_params` (edited live) and `active_params` (snapshot per active chord) structures on the State Manager.

### 6.5 Chord Naming (for LCD)
Display uses `<Root><quality>` shorthand and **Omnichord-style flat spelling** matching the chord-button root table (5.1): roots are spelled `Db Ab Eb Bb F C G D A E B F#`. Examples: `Eb`, `Ebm`, `Eb7`, `Ebmaj7`, `Ebm7`, `Ebdim`, `Ebaug`, `Ebsus4`, `Ebadd9`. (Flats-by-default; this matches the button layout and is the required display convention.)

### 6.6 Strum Note Pool Derivation
- The strum plate plays the active chord's notes spread over multiple octaves.
- Given chord pitch classes, build an ascending note pool spanning the strum octave range (strum octave param), then map strum keys in order to successive notes of that pool.
- In **Silent** chord mode, the chord is not sounded but still defines this pool.

### 6.7 Arpeggio Modes
The `arp_mode` parameter (5.4) selects how the Arpeggio play mode walks the voicing's notes:
- **Up:** lowest → highest, then wraps to lowest (default).
- **Down:** highest → lowest, then wraps to highest.
- **Up-Down:** lowest → highest → lowest, repeating.
- **Alternating:** 1 → 3 → 2 → 4 … (indexes 0, 2, 1, 3 for a 4-note chord).
- **Random:** a random note each step (seeded PRNG; deterministic in tests).

The `arp_rate` parameter (5.4) selects the note subdivision used by Arpeggio and
Arp-Hold: Whole (1/1), Half (1/2), Quarter (1/4), Eighth (1/8), 16th (1/16, the
default), or 32nd (1/32). All rates are quantized to the free-running 24-PPQN
master clock, so the arpeggiator stays phase-locked to the beat LED even when
the rhythm engine is stopped. An arpeggiated chord that starts within 30 ms
before the next subdivision boundary delays its first note to that boundary;
this is applied to every arp chord start, including chord changes while the arp
is already running. Starts outside the window play the first note immediately.

### 6.8 Walking Bass Interval Blueprint
The walking bass (4.7) plays a fixed looping interval cycle per beat, relative to the chord root. For a 4-beat bar the cycle is `[beat 1, beat 2, beat 3, beat 4]` semitone offsets; beat 4 uses the chord's 7th when present, else the 6th:

| Type | Beat 1 | Beat 2 | Beat 3 | Beat 4 |
|---|---|---|---|---|
| Major | 0 | 4 | 7 | 9 (6th) |
| Minor | 0 | 3 | 7 | 9 (6th) |
| Dom7 | 0 | 4 | 7 | 10 (b7) |
| Maj7 | 0 | 4 | 7 | 11 (7) |
| Min7 | 0 | 3 | 7 | 10 (b7) |
| Dim | 0 | 3 | 6 | 9 (6th) |
| Dim7 | 0 | 3 | 6 | 9 (bb7) |
| Aug | 0 | 4 | 8 | 9 (6th) |
| Sus4 | 0 | 5 | 7 | 9 (6th) |
| Sus2 | 0 | 2 | 7 | 9 (6th) |
| Min7b5 | 0 | 3 | 6 | 10 (b7) |

The cycle length equals the pattern's `beats_per_bar` (`steps_per_bar / 4`); a 3/4 waltz plays only the first three offsets (root–3rd–5th). Bass note = `rootMidi(root_pc, base_root_midi, bass_octave) + offset[beat]`.

### 6.9 Configurable Bass Patterns (FR-B5)
Bass patterns are JSON files in `/bass/*.json` (the 9 built-ins below plus user
files), loaded at boot in the same way as rhythm patterns (7.x). The pattern
parameter (`bass.pattern`, 5.9) selects an index into that list by name. Each
pattern is a 16th-note grid (`steps_per_bar`) whose `steps` are **chord-degree
codes**: `-1` = rest, `0` = root, `1` = 3rd, `2` = 5th, `3` = 6th/7th — resolved
through the per-chord-type blueprint (6.8), so the note follows the chord's root
*and* type (minor 3rd vs major 3rd, etc.). An optional parallel `sustain_steps`
array gives each note's length in 16th steps (`0` = percussive, using
`note_duration_ms`).

The 9 built-in patterns:

| Index | Name | Steps (beats) | Sustain |
|---|---|---|---|
| 0 | Walking | root-3rd-5th-6th/7th (blueprint 6.8) | percussive |
| 1 | Whole | root | whole bar |
| 2 | Half | root | half note |
| 3 | Quarter | root | percussive |
| 4 | Half Alt | root / 5th | half note |
| 5 | Quarter Alt | root / 5th | percussive |
| 6 | 3/4 Alt | root on beat 1, 5th on the last beat | percussive |
| 7 | Hold | root (sustains) | until chord released |
| 8 | No 6th | root (half) → 3rd (quarter) → 5th (quarter) | 2 beats on beat 0 |

The bass follows the rhythm's meter when it is shorter: a 4/4 bass pattern under
a 3/4 (waltz) rhythm plays only its first 12 steps then wraps. `hold` is not
beat-driven: it sustains the root while the chord is sounding (a held key in
Press/Arp mode, indefinitely in Held mode) and is released when the chord stops
sounding or the bass is disabled. Whole/half sustained notes re-articulate
immediately when the chord changes mid-note (so the bass follows the new root),
and they release slightly before the next note's attack for a clean
articulation. All beat-driven patterns fire on the rhythm 16th-note step grid in
lockstep with the drums while the rhythm is running; when it is stopped they
free-run on the same grid at the preset tempo so the bass stays audible without
drums.

### 6.10 Configurable Chord Patterns (M13; on-device editor M17)

Chord patterns are polyphonic, user-authored step sequences for the chord
engine, selected via the `pattern` chord parameter (5.4) and stored in
`/chordpatterns/*.json` (the 9 built-ins below plus user files), loaded at boot
like rhythm/bass patterns. The `Pattern` and `PatternHold` play modes (6.11)
step through the selected pattern in lockstep with the rhythm 16th-note grid
(restarting at step 0 on each chord trigger); `PatternHold` latches on key
release like `ArpHold`.

Each step is a **degree bitmask** (0 = rest): bit 0 = root, bit 1 = 3rd,
bit 2 = 5th, bit 3 = 7th. Multiple bits in one step sound together. Degrees
resolve through the active chord's type to a semitone offset above the chord
root (root position at the chord octave); voicing/inversion/min-interval do not
apply in Pattern mode. Degree 3 (the 7th) uses the chord's 7th when present,
otherwise **wraps to the root an octave up** on triads. An optional parallel
`sustain_steps` array gives each step's length in 16th steps (`0` = percussive,
using `note_duration_ms`); a rest step does not cut a sustaining note early.

The 9 built-in patterns:

| Index | Name | Steps | Sustain |
|---|---|---|---|
| 0 | Block | full chord (all 4 degrees) on beat 1 | whole bar |
| 1 | Alberti | root-5th-3rd-5th on quarter notes | percussive |
| 2 | Broken Up | root-3rd-5th-7th on quarter notes | percussive |
| 3 | Broken Down | 7th-5th-3rd-root on quarter notes | percussive |
| 4 | Pulse | full triad on every 8th note | percussive |
| 5 | Oom-Pah | root, then 3rd+5th, alternating beats | percussive |
| 6 | Roll | root-3rd-5th-3rd on 8th notes | percussive |
| 7 | Split | root on beat 1, 3rd+5th+7th on beats 2–4 | percussive |
| 8 | Arpeggio | root-3rd-5th-7th-5th-3rd 16th-note cycle | percussive |

The pattern follows the rhythm's meter when it is shorter (like the bass), and
advances at the stored tempo even when the rhythm is stopped.

M17 adds an on-device editor for these patterns (4.9, 5.11): it records degree
pads into the per-step bitmask, captures held sustains, and edits the grid as
hex digits `0`–`F`. Recording and preview resolve the bitmask through the
current/last selected chord, exactly like playback (6.13).

### 6.11 Pattern and Pattern-Hold Play Modes

`Pattern` steps the selected chord pattern's 16th-note grid and releases on key-up; `PatternHold` latches like `ArpHold` and releases on the next chord, Esc, or panic. Pattern steps resolve through the active chord type (see 6.10). When the rhythm is running, pattern stepping follows the rhythm clock; otherwise it free-runs at the stored tempo.

### 6.12 Chord Sequencer Playback (M14)

The sequencer is a separate per-preset chord recorder/player. It records chord **changes** (root, type, and extensions) on the same 16th-note grid and plays them through the chord engine using the merged play mode, so recorded Held/Arp/Pattern playback is reproduced. It is not a MIDI sequencer: strummed notes, arpeggios, and pattern notes are never recorded as events; they are generated live from the sequence chord and the recorded/live settings. Playback follows the rhythm clock (rhythm enabled, mute allowed) and loops for 1/2/4/8 bars. The sounding sequence chord becomes the selected chord, so FollowChord strumming tracks playback. Selecting a new slot while playing takes effect at the end of the current loop. Live chords override sequence events while held/latched (FR-Q5). Recorded settings are mixed with live settings per FR-Q3/FR-Q4. See 8.4 for the file schema.

### 6.13 Pattern Recording, Quantization & Overdub (M17)

The bass, rhythm, and chord pattern editors record into the same 16th-note grid
used by playback. Recording is quantized at capture time: each pad press selects
the nearest step (using the same half-step comparison as the sequencer) and then
snaps to the selected Quantize division (`1/4` = 4 steps, `1/8` = 2 steps,
`1/16` = 1 step). Quantize is a recording setting only; it is not stored in the
pattern JSON and the grid always edits 16th steps.

- **Count-in and guide:** recording uses the M14 count-in: the normal pattern is
  suppressed, the hi-hat guide plays one bar of quarter-note closed hi-hats
  (downbeat accented), and the take records the next N bars while the guide
  continues. The rhythm engine is enabled for the session if needed and its
  previous enable/mute state is restored when the editor exits. Recording and
  preview require the live rhythm meter to match the working pattern's
  `steps_per_bar`; a mismatch shows `Meter mismatch`.
- **Rhythm:** each pad press targets its own track, so simultaneous pads record
  polyphonically. Hits store velocity `1` (default) or `127` (accent); a
  repeated hit on the same track/step replaces the previous velocity. Drums are
  one-shot, so pad holds do not sustain.
- **Bass:** monophonic. A pad press sets the degree at the quantized step and
  clears any previous degree there. Held pads write `sustain_steps` for the
  number of steps held, capped to the loop length; releasing before the next
  step leaves a percussive note.
- **Chord:** each pad press adds its degree bit to the step's bitmask; `0`
  clears the step. Multiple pads at one step combine, and held pads write the
  longest held duration as `sustain_steps`. A new attack on a step breaks any
  sustain that previously covered it.
- **Overdub:** recording preserves every step/track the take does not touch.
  The editor's **Clear** command resets the working buffer to rests (keeping
  bars/meter) for a fresh take.
- **Preview:** loops the working buffer from the next bar. It uses the drum map
  for rhythm and resolves bass/chord degrees through the current/last selected
  chord. Live chords override preview; starting Preview again resumes. Nothing
  is written until Save/Save As.
- **Live pads:** outside recording the same rhythm/bass pads audition using the
  preset DrumMap/bass parameters. Chord-grid keys and direct
  parameter-modifying actions stay active; live pads work in command, grid,
  record, preview, and value-selected states, but not during name entry or
  prompts (FR-E10).

---

## 7. Rhythm Pattern Specification

### 7.1 Rhythm List
Original Omnichord-style rhythms to include (reconstructed), plus room for custom additions:
Rock 1, Rock 2, Waltz, Swing, Slow Rock, Bossa Nova, Rhumba, Tango, March, Samba, Disco, Foxtrot, plus user-defined patterns.
> Final list **[DRAFT — REVIEW]**.

### 7.2 Pattern Data Format (JSON on LittleFS)
Each rhythm is a step sequence stored as a JSON file on LittleFS (one file per pattern, under `/rhythms/`). Steps map to GM percussion notes on channel 10.
```json
{
  "name": "Rock 1",
  "short_name": "Rk",
  "steps_per_bar": 16,
  "swing": 0,
  "tracks": [
    { "note": 36, "name": "kick",  "pattern": [1,0,0,0, 0,0,0,0, 1,0,0,0, 0,0,0,0] },
    { "note": 38, "name": "snare", "pattern": [0,0,0,0, 1,0,0,0, 0,0,0,0, 1,0,0,0] },
    { "note": 42, "name": "hihat", "pattern": [1,0,1,0, 1,0,1,0, 1,0,1,0, 1,0,1,0] }
  ]
}
```
- `short_name` (optional) is the 2-character code shown on the idle LCD line; it is truncated to its first two characters if longer. When absent, built-ins use their hard-coded code and user patterns use the first two letters of `name`.
- `pattern` values may be `0` (rest) or `1..127` (velocity; `1` = default velocity).
- GM percussion note numbers: kick 36, snare 38, closed hat 42, open hat 46, etc.
- **`swing` is an integer** here (see 7.3): per-pattern swing is stored as a signed integer percentage −75..+75, not a float. (A pattern authored with `"swing": 0` means none; `"swing": 50` means a 50% off-beat delay.) This differs from the original Pi spec, which used a 0.0–0.75 float.
- **On-device authoring (M17):** rhythm, bass, and chord patterns can be created or edited on the device (4.9, 5.11). The editor writes the same schema to `userN.json` in the pattern's directory, compactly (the configurator also writes pattern files compactly). `bars` is inferred from `steps.length / steps_per_bar`; no `bars` field is stored. Built-in files may be overwritten, and user files are appended alphabetically at load time. See 8.5 for naming, caps, and the pattern-file budget.

### 7.3 Timing, Tempo & Swing (integer / fixed-point)
All timing math runs on Core 1 using integer microseconds; the RP2040 has no FPU (Section 1.4), so **no floats are used in the scheduler**.
- **Tempo:** BPM, adjustable via Page Up/Down (FR-R5). Range e.g. 40–260 BPM. Step interval is computed with integer division, e.g. `step_us = 60000000 / (bpm * steps_per_beat)`. A live tempo change re-slaves the pattern to the next 24-tick master-clock beat boundary (the monotonic step counter continues for arp/sequencer sync), so the drums, hi-hat guide, and LED do not drift apart when the tempo changes.
- **Swing:** stored as a **signed integer percentage −75..+75** (0 = straight; positive = laid-back, negative = rushed), adjustable in the Rhythm Edit menu (Swing parameter) in steps of 5. The off-beat delay is applied as fixed-point integer math, e.g. `delay_us = (base_step_us * swing) / 100`, applied to the off-beat 8th-note step only. (Semantically equivalent to the original 0.0–0.75 float, expressed as a signed −0.75..+0.75.)
- **Sync:** The Rhythm Engine clock drives the Chord Engine Arpeggio mode (FR-R4) and the walking bass's beat (FR-B4).
- **MIDI clock:** A single **master clock** (24 PPQN) runs continuously in the background from boot — its tick counter and phase never reset, regardless of whether the rhythm or Clock Out is enabled. Clock Out (`F8`, or Clock Out in the Rhythm Edit menu) gates whether the `0xF8` byte is emitted. Enabling waits for the next 24-tick beat boundary, then streams clocks; disabling stops the stream immediately. No Start/Stop is sent automatically, so the slave's transport remains under its own control. **Double-tap `F8`** to send MIDI Start (`0xFA`) at the next beat boundary and re-align the slave when needed. The beat LED and the rhythm scheduler both **slave to this master clock**: the LED flashes on every 24th tick, and the rhythm downbeat aligns to a 24-tick beat boundary with each 16th-note step = exactly 6 ticks. This keeps LED, drums, and clock mutually phase-locked (nothing preempts or resets the clock).
- **Mute (FR-R2):** suppresses drum note-ons while the clock/sync continues.
- **Playback priority:** rhythm/clock output from Core 1 is serviced before UI/LCD work on Core 0. Sequence/chord/bass engines are updated before key-menu handling. If a blocking operation delays service by more than a few milliseconds, stale rhythm output is dropped and the Core 1 step deadline is rebased to the current clock phase rather than firing a burst of late notes.
- **LED BPM indicator (FR-R8):** the beat LED flashes with a **consistent short pulse** (`led.flash_ms`, default 40 ms) on every beat of the master clock, independent of rhythm/clock-out state. The target LED is configurable (`led.led` = `num_lock` default, `caps_lock`, `scroll_lock`, or `all`); Core 0 owns the LED on/off state and retries the HID report until it is queued, so a dropped report cannot leave the LED stuck on.

---

## 8. Data Models (JSON on LittleFS)

All config/preset/pattern files live on the Pico's **LittleFS** filesystem in onboard flash, parsed/serialized with **ArduinoJson**. Default templates ship in the repo `data/` directory and are flashed to LittleFS on the image; runtime files are generated/overwritten on the device.

### 8.1 Global Config (`/config.json`)
```json
{
  "midi": { "din_enabled": true, "usb_enabled": true, "clock_enabled": false },
  "chord": { "base_root_midi": 60, "note_range": [48, 84] },
  "display": {
    "revert_timeout_ms": 1500,
    "prompt_timeout_ms": 5000,
    "cursor_timeout_ms": 5000,
    "menu_timeout_ms": 10000
  },
  "led": {
    "bpm_indicator": true,
    "led": "num_lock",
    "flash_ms": 40
  },
  "startup_preset": "B1:P1",
  "logging": { "debug_log": true, "midi_monitor": true }
}
```
> Notes vs. the Pi spec: there is **no `keyboard_device`** field (the firmware owns the single hosted keyboard, no device path); **no `i2c_address`/`modifiers`/`chord_root_order`** (removed). `midi.usb_enabled` was added in v0.2 (USB MIDI device output). Any value absent from `config.json` or a preset is filled from the defaults in the Parameter Reference (Section 9). See NFR-9 for validation and first-boot generation.

### 8.2 Preset (`/presets/bank<N>.json` → array of 8)
```json
{
  "name": "Ballad Pad",
  "number_keys": "strum",
  "macros": {},
  "chord": {
    "play_mode": "held",
    "octave": 0,
    "note_duration_ms": 500,
    "velocity": 100,
    "pan": 64,
    "chord_roll_ms": 0,
    "min_notes": 3,
    "min_interval": 0,
    "inversion": "root",
    "arp_mode": "up",
    "arp_rate": "sixteenth",
    "pattern": "Block",
    "voicing_mode": "root_position",
    "channel": 1
  },
  "strum": {
    "octave": 1,
    "note_duration_ms": 300,
    "velocity": 90,
    "limited_keys": false,
    "mode": "follow_chord",
    "root_pc": 0,
    "scale_type": "ionian",
    "channel": 2
  },
  "bass": {
    "enabled": false,
    "octave": -1,
    "note_duration_ms": 150,
    "velocity": 90,
    "channel": 3,
    "pattern": "Walking"
  },
  "rhythm": {
    "enabled": false,
    "pattern": "Rock 1",
    "tempo": 120,
    "swing": 0,
    "muted": false,
    "channel": 10,
    "drums": {
      "kick": 36, "kick_vel": 0,
      "snare": 38, "snare_vel": 0,
      "hihat": 42, "hihat_vel": 0,
      "open_hat": 46, "open_hat_vel": 0,
      "rimshot": 37, "rimshot_vel": 0,
      "clap": 39, "clap_vel": 0,
      "crash": 49, "crash_vel": 0,
      "ride": 51, "ride_vel": 0,
      "bongo": 61, "bongo_vel": 0,
      "conga_lo": 62, "conga_lo_vel": 0,
      "conga_hi": 63, "conga_hi_vel": 0,
      "clave": 75, "clave_vel": 0,
      "shaker": 82, "shaker_vel": 0
    }
  }
}
```
> `rhythm.swing` is a **signed integer −75..+75** (Section 7.3), not a float. The `chord.extensions` object has been removed: add9/add11/add13 are now held modifiers (FR-C7) and are not persisted. `play_mode` is one of `held` / `press_to_play` / `arpeggio` / `arp_hold` / `silent` / `pattern` / `pattern_hold` (Rhythm mode was replaced by the walking bass, FR-B1). `bass.pattern` is a bass pattern **name** per FR-B5. `chord.pattern` is a chord pattern **name** (`Block` / `Alberti` / `Broken Up` / `Broken Down` / `Pulse` / `Oom-Pah` / `Roll` / `Split` / `Arpeggio`, or a user file's `name`) per 6.10.
>
> `number_keys` is `"strum"` (default) or `"macro"`. `macros` maps top-row labels `"1"`…`"9"`,`"0"` to macro objects with an optional `name` and ordered `commands` array; legacy bare command arrays are still accepted. See the Custom Configuration Guide §3.7 for the command schema, default names, and the 16/key + 48/preset limits. Missing fields load as strum with no macros.
>
> Each preset also owns **10 chord-sequence slots**, stored separately in `/sequences/b<N>p<M>.json` (8.4). The per-preset association is fixed by the preset's bank/slot; sequences are not copied by preset Save. Sequence recording/playback is immediate-save, so it does not add the preset dirty `*` marker.

### 8.3 Combination, Chord-Type & Root-Order Tables
The Omnichord combination matrix (6.3), chord interval formulas (6.2), the circle-of-fifths root order (5.1, `chord_root_order`), the keymap, and per-parameter defaults are stored as editable JSON on LittleFS (shipped from repo `data/`) so behavior/layout can be tuned without recompiling. To minimize flash writes and RAM, large static tables may alternatively be compiled into flash as C++ constants with JSON overrides — see the roadmap for the chosen persistence strategy (default: JSON on LittleFS via ArduinoJson).

### 8.4 Chord Sequencer (`/sequences/b<N>p<M>.json`)

One file per preset (bank 1–5, slot 1–8). The file holds all 10 sequence slots; an unused slot is `null`. Files are written compactly (no pretty whitespace) to stay within the flash budget.

```json
{
  "version": 1,
  "sequences": [
    null,
    {
      "bars": 4,
      "steps_per_bar": 16,
      "recorded": [0, 500, 100, 64, 0, 0, 3, 0, 0, 0, 0, 0, 4],
      "live": 0,
      "events": [[0, 0], [16, 640]]
    }
  ]
}
```

- `bars` is 1, 2, 4, or 8; `steps_per_bar` is the recorded meter (usually 16, or 12 for 3/4).
- `recorded` is the fixed 13-value settings array, in this order: `octave`, `note_duration_ms`, `velocity`, `pan`, `voicing_mode`, `chord_roll_ms`, `min_notes`, `min_interval`, `inversion`, `arp_mode`, `pattern index`, `play_mode`, `arp_rate`. Legacy 11-value arrays load with play mode `Held` and arp rate `Sixteenth`.
- `live` is a bitmask; bit *i* set means "use the live value for recorded[i]" during playback. The MIDI channel stays live.
- `events` is `[step, chord_id]`. `chord_id = root_pc * 128 + type * 8 + extension_mask`; extension bits are add9=1, add11=2, add13=4. Type order matches `ChordType` (`major`, `minor`, `dom7`, `maj7`, `min7`, `dim`, `dim7`, `aug`, `sus4`, `sus2`, `min7b5`). Maximum 64 events per sequence; steps must be less than `bars * steps_per_bar`.

### 8.5 On-device Pattern Files (M17)

The pattern editors (4.9, 5.11) write the existing rhythm/bass/chord schemas; no new JSON fields are introduced.

| Kind | Directory | Built-ins | New user file |
|---|---|---|---|
| Rhythm | `/rhythms/` | 12 | `/rhythms/userN.json` |
| Bass | `/bass/` | 9 | `/bass/userN.json` |
| Chord | `/chordpatterns/` | 9 | `/chordpatterns/userN.json` |

- **Naming:** `userN.json` uses the smallest positive N not already present. The authored `name` must be unique among that kind's patterns; the editor uniquifies `New Rhythm` / `New Bass` / `New Chord` (and `Save As` copies) automatically. Presets store pattern **names**, so adding or reordering user files does not break preset references.
- **Length:** `steps_per_bar` is 16 (4/4) or 12 (3/4); `bars` is 1/2/4/8 and is inferred from `steps.length / steps_per_bar`. The editor keeps all rhythm tracks the same length and writes `sustain_steps` only when a bass/chord step sustains.
- **Writing:** on-device and configurator writes use compact JSON (like sequence files) to keep the budget predictable. Built-ins may be overwritten with confirmation; user patterns may be renamed/deleted. A built-in file that is deleted/corrupt is re-provisioned from its embedded template on boot; an overwritten built-in is left as edited until reflashed/factory-reset.
- **Caps and budget:** at most **32 total patterns per kind** (built-in + user). A combined **72 KB** budget covers all rhythm, bass, and chord pattern files (built-ins + user patterns); user-created patterns have a **48 KB** share of that budget. Per-file caps are **8 KB** rhythm, **4 KB** bass, and **4 KB** chord. The editor rejects a save that would exceed the count, per-file, or combined budget (`Pattern limit`/`Pattern too large`). The configurator enforces the same limits with validation errors/warnings.
- **MSC:** pattern write actions are disabled while the USB Mass Storage drive is active; the host owns the filesystem at that point.

---

## 9. Parameter Reference (defaults, ranges, steps)

All adjustable parameters, with min/max/default/step. On default initialization (FR-P9) and when a config/preset value is missing, use the **Default** column. Editing clamps to [Min, Max] in increments of **Step**. This table is the single source of truth for parameter bounds. **All values are integers** (RP2040 has no FPU).

| Parameter | Scope | Type | Min | Max | Default | Step | Notes |
|---|---|---|-----|-----|---|---|---|
| play_mode | chord | enum | — | — | `held` | cycle | held / press_to_play / arpeggio / arp_hold / silent / pattern / pattern_hold |
| note_duration_ms | chord | int | 50 | 4000 | 500 | 50 | note length for press-to-play/arp lifecycles |
| velocity | chord | int | 1 | 127 | 100 | 1 | MIDI note-on velocity |
| pan | chord | int | 0 | 127 | 64 | 1 | CC10; 64 = center |
| octave | chord | int | −3 | +3 | 0 | 1 | transpose in octaves |
| voicing_mode | chord | enum | — | — | `root_position` | toggle | root_position / smart |
| chord_roll_ms | chord | int | −2000 | +2000 | 0 | 10 | stagger chord note-ons (positive up / negative down); Held & Press modes |
| min_notes | chord | int | 2 | 6 | 3 | 1 | pad chord with octave notes to at least this count |
| min_interval | chord | int | 0 | 12 | 0 | 1 | min semitones between adjacent voicing notes (0 = off) |
| inversion | chord | enum | — | — | `root` | cycle | root / first / second / third (also PrtSc/ScLk/Pause) |
| arp_mode | chord | enum | — | — | `up` | cycle | up / down / up_down / alternating / random |
| arp_rate | chord | enum | — | — | `sixteenth` | cycle | whole / half / quarter / eighth / sixteenth / thirty_second |
| pattern (chord) | chord | enum | — | — | `Block` | cycle | chord pattern name (6.10): Block / Alberti / Broken Up / Broken Down / Pulse / Oom-Pah / Roll / Split / Arpeggio + user files |
| channel (chord) | chord | int | 1 | 16 | 1 | 1 | MIDI channel |
| octave (strum) | strum | int | −3 | +3 | 1 | 1 | strum-pool octave placement |
| note_duration_ms (strum) | strum | int | 50 | 4000 | 300 | 50 | strummed note length |
| velocity (strum) | strum | int | 1 | 127 | 90 | 1 | |
| limited_keys | strum | bool | off | on | off | toggle | limited numpad path |
| strum_mode | strum | enum | — | — | `follow_chord` | cycle | follow_chord / scale / piano (FR-S7) |
| strum_root | strum | enum | — | — | `C` | cycle | pitch class C..B (scale/piano root) |
| strum_scale | strum | enum | — | — | `ionian` | cycle | scale/mode for Scale mode (FR-S7) |
| channel (strum) | strum | int | 1 | 16 | 2 | 1 | MIDI channel |
| enabled (bass) | bass | bool | off | on | off | toggle | walking bass on/off |
| octave (bass) | bass | int | −3 | +3 | −1 | 1 | bass octave transpose |
| note_duration_ms (bass) | bass | int | 50 | 4000 | 150 | 50 | bass note length |
| velocity (bass) | bass | int | 1 | 127 | 90 | 1 | |
| channel (bass) | bass | int | 1 | 16 | 3 | 1 | MIDI channel (may equal any function) |
| pattern (bass) | bass | enum | — | — | `Walking` | cycle | pattern name: Walking / Whole / Half / Quarter / Half Alt / Quarter Alt / 3/4 Alt / No 6th / Hold + user files (FR-B5) |
| tempo | rhythm | int | 40 | 260 | 120 | 1 | BPM |
| swing | rhythm | int | −75 | +75 | 0 | 5 | signed off-beat delay percentage (integer/fixed-point; see 7.3) |
| enabled | rhythm | bool | off | on | off | toggle | rhythm on/off |
| muted | rhythm | bool | off | on | off | toggle | suppress drum note-ons |
| pattern | rhythm | enum | — | — | `Rock 1` | cycle | from rhythm list (7.1) |
| channel (rhythm) | rhythm | int | 1 | 16 | 10 | 1 | GM percussion |
| drum_kick_note | rhythm | int | 0 | 127 | 36 | 1 | kick GM note (FR-R9) |
| drum_snare_note | rhythm | int | 0 | 127 | 38 | 1 | snare GM note (FR-R9) |
| drum_hihat_note | rhythm | int | 0 | 127 | 42 | 1 | hi-hat GM note (FR-R9) |
| drum_open_hat_note | rhythm | int | 0 | 127 | 46 | 1 | open-hat GM note (FR-R9) |
| drum_rimshot_note | rhythm | int | 0 | 127 | 37 | 1 | rimshot GM note (FR-R9) |
| drum_clap_note | rhythm | int | 0 | 127 | 39 | 1 | clap GM note (FR-R9) |
| drum_crash_note | rhythm | int | 0 | 127 | 49 | 1 | crash GM note (FR-R9) |
| drum_ride_note | rhythm | int | 0 | 127 | 51 | 1 | ride GM note (FR-R9) |
| drum_bongo_note | rhythm | int | 0 | 127 | 61 | 1 | bongo GM note (FR-R9) |
| drum_conga_lo_note | rhythm | int | 0 | 127 | 62 | 1 | mute hi-conga GM note (FR-R9) |
| drum_conga_hi_note | rhythm | int | 0 | 127 | 63 | 1 | open hi-conga GM note (FR-R9) |
| drum_clave_note | rhythm | int | 0 | 127 | 75 | 1 | clave GM note (FR-R9) |
| drum_shaker_note | rhythm | int | 0 | 127 | 82 | 1 | shaker GM note (FR-R9) |
| drum_*_vel | rhythm | int | 0 | 127 | 0 | 1 | per-piece velocity; 0 = Auto (follow pattern) (FR-R9) |
| usb_enabled | global | bool | off | on | on | toggle | USB MIDI device output on/off (M11; interface always enumerates) |
| clock_enabled | global | bool | off | on | off | toggle | MIDI clock transmit (FR-R7); double-tap the toggle key for Clock Resync |
| bpm_indicator | global | bool | off | on | on | toggle | keyboard-LED BPM indicator (FR-R8) |
| led (indicator) | global | enum | — | — | `num_lock` | — | which keyboard LED(s) to flash: num_lock / caps_lock / scroll_lock / all |
| flash_ms | global | int | 5 | 500 | 40 | 5 | beat flash duration (consistent on every beat) |
| revert_timeout_ms | global | int | 250 | 5000 | 1500 | 250 | LCD param-edit revert |
| prompt_timeout_ms | global | int | — | — | 5000 | — | save/clear auto-cancel (FR-P10) |
| cursor_timeout_ms | global | int | 500 | 30000 | 5000 | — | cursor-navigation auto-reset (FR-P3) |
| menu_timeout_ms | global | int | 500 | 30000 | 10000 | — | edit-menu idle auto-exit |

> **Sequencer menu parameters** (`seq_slot`, `seq_bars`, `seq_settings`) are runtime performance controls, not persisted preset fields. `seq_bars` edits the selected sequence file; `seq_settings` is a global Recorded/Live override; the per-setting Live bits are stored per sequence (8.4).
>
> **Pattern editor runtime controls** (`kind`, `pattern`, `bars`, `quantize`, `grid`, `record`, `preview`, `new`, `rename`, `save`, `save as`, `delete`, `clear`) are runtime-only. `bars`, `kind`, and `quantize` are not persisted; pattern length is stored as `steps`/`steps_per_bar`, and quantize is a recording-time snap only (6.13). The saved pattern file is separate from the preset; selecting the saved pattern updates the preset's pattern name and dirty marker.
>
> **Changed from the Pi spec:** `swing` is now a **signed integer −75..+75 with step 5** (was float 0.0–0.75 step 0.05). Semantics are identical (percentage off-beat delay; positive laid-back, negative rushed); the representation is integer for the no-FPU RP2040.

---

## 10. Non-Functional Requirements

- **NFR-1 Latency:** Key-report to MIDI-output latency < 10 ms (target). Bounded largely by USB-host poll interval (typically 1 ms) plus minimal per-event work on Core 0. Measure and document typical/worst-case.
- **NFR-2 Timing accuracy:** Rhythm/arp step timing jitter < 2 ms. Achieved via the dedicated Core 1 monotonic scheduler with non-blocking MIDI writes; LED HID writes kept off the critical path. Core 0 services Core 1 MIDI before UI work, diagnostic logging is drop-on-full/non-blocking, preset dirty checks use an in-memory cache instead of a filesystem read per edit, and LCD I2C updates are rate-limited/deferred around due playback steps. Explicit flash writes pause playback briefly; the scheduler rebases after the stall instead of emitting a late catch-up burst.
- **NFR-3 Resource use:** Run within RP2040 constraints (264 KB SRAM, 2 MB flash). The keyboard host runs on the external CH559 (which owns the USB-host RAM/PIO), so the RP2040 cost is only the small UART-bridge buffer; keep the rest lean. No dynamic allocation in real-time paths; prefer static buffers.
- **NFR-4 Boot-to-ready:** No OS/systemd; firmware runs from flash on power-up. Reach playable state quickly (target < 3 s), dominated by USB enumeration of the keyboard and LittleFS mount.
- **NFR-5 Robustness:** Handle keyboard hot-plug/unplug (re-enumerate), missing/failed LCD, keyboards that reject LED output reports, and an unconnected DIN, without crashing or hanging. A watchdog may be used to recover from a wedged USB stack.
- **NFR-6 N-key rollover:** Support simultaneous chord + strum key presses. Rollover is bounded by the *keyboard's* HID report protocol (boot-protocol keyboards commonly report at most 6 concurrent keys plus modifiers). Prefer report-protocol (full NKRO) when the keyboard offers it; document per-keyboard limitations.
- **NFR-7 Configurability:** All tunable behavior (keymap, chord tables, rhythms, parameter defaults) lives in editable JSON on LittleFS.
- **NFR-8 Logging:** Provide a debug log mode over USB-CDC (native USB port) or a spare UART for troubleshooting input/MIDI, compiled out of release builds if needed.
- **NFR-9 Config validation & first-boot generation:** On startup, mount LittleFS (format if unmounted/first boot) and validate `config.json` and preset banks against the schema/Parameter Reference (Section 9). On missing files/directories, generate defaults (default config + 5 banks × 8 default presets, from shipped `data/` templates). On corrupt or out-of-range values, fall back to defaults for the affected fields and log a warning; never crash on bad config.

---

## 11. Testing Strategy

> **Verification instruments & feedback dependency:** Testing keyboard input does **not** require the LCD. Feedback instruments, in priority order: (1) **native GoogleTest** for all pure logic (keymap, chords, voicing, strum, rhythm, config, latching) with no hardware; (2) the **USB-CDC debug log + MIDI monitor**, available from M2 (Section 12), as the on-device instrument for input capture and MIDI output through M2–M5; (3) the **LCD**, which is a feature under test at M6 and is *not* a prerequisite for verifying earlier milestones. On-device milestones M2–M5 depend on the debug log/MIDI monitor for feedback, never on the screen — which is why the display is built at M6 rather than before the input/chord engines.

### 11.1 Off-device unit tests (GoogleTest, `native` PlatformIO env)
The pure-logic core must be testable on a desktop without the Pico hardware. Structure the code so these have no Arduino/hardware includes:
- **Chord computation:** root + type → correct MIDI note sets (per 6.2).
- **Combination matrix:** same-column, left-adjacent (sus4/add9), and leftmost-column `` ` `` cases (6.3) resolve to the correct chord.
- **Voicing:** root-position vs smart voice-leading produce expected voicings; octave clamping (VR-3).
- **Extensions:** add9/add11/add13 applied as held modifiers (`Left`/`Down`/`Right`) add the correct tensions (6.2).
- **Strum pool:** note-pool derivation and key→note mapping for full and limited layouts (6.6).
- **Rhythm stepping:** pattern → scheduled events; integer tempo/swing math (7.2/7.3), including the fixed-point swing formula.
- **Held-mode latching:** parameter snapshot vs pending state (FR-C9/VR-5).
- **Config:** validation, default generation, and out-of-range fallback (NFR-9), using an in-memory/std::filesystem stub for the storage adapter.
- **Keymap:** HID usage page + usage + modifier byte → action mapping; Shift/Caps/Tab resolve as chord roots; keypad usages Num-Lock-independent; `+`/`-` context-sensitivity; Consumer/media keys bindable with fixed Volume +/− controls; `Ctrl+1..0` sequence selection.
- **Sequencer:** sequence JSON round-trip and chord-ID encoding; nearest-16th quantization; recording arm/bar/cap state machine; loop playback; live-chord suppression/resume; recorded-vs-live settings merge; per-preset file load/save/clear; flash-budget guard.
- **Pattern editors:** rhythm/bass/chord serializer round-trips; bars/meter inference; quantize math; count-in/record/overdub state machine; polyphonic rhythm and chord bitmask capture; bass/chord sustain capture; grid edit operations; new/rename/save-as/delete rules; per-kind caps, per-file caps, and combined pattern budget; runtime library reload and pattern-name selection.
- **Keymap:** the M17 remap (`F10`/`F11` menu swap, `Ctrl+F12` Seq Edit, `Super+F9/F10/F12` pattern editors) resolves as documented, including configurator defaults/validation.

### 11.2 On-device verification
- **MIDI monitor/log mode:** a build/runtime flag that logs every outgoing MIDI message (channel, note/CC, velocity, timestamp) over USB-CDC/UART for verifying output without external gear.
- **Latency measurement:** instrumented timing from HID report receipt to MIDI dispatch to validate NFR-1.
- **Timing/jitter measurement:** log Core 1 scheduler step timestamps to validate NFR-2.

### 11.3 Manual hardware test checklist
A checklist mapped 1:1 to the Acceptance Criteria (Section 13), executed on assembled hardware with an external synth/DAW and (optionally) a DIN MIDI monitor.

---

## 12. Development Phases / Milestones
These milestones align with the Build Sequence (Section 1.6); stop for user feedback after each. Every milestone keeps the GoogleTest `native` suite green before its stop.

1. **M1 — Scaffolding:** PlatformIO project (`pico` + `native` envs), pinned lib deps, `src/main.cpp` entry (`setup/loop` + `setup1/loop1`), LittleFS layout + config loader with first-boot defaults, adapter interfaces with null implementations, GoogleTest skeleton.
2. **M2 — Core framework:** USB-host HID keyboard input (CH559 coprocessor + UART bridge); State Manager (pending vs active params scaffolding); MIDI Router (DIN via `Serial2`/UART1); Config/Preset store (LittleFS + ArduinoJson); hardcoded note on DIN; minimal USB-CDC debug log + MIDI monitor (on-device feedback instrument for M2–M5).
3. **M3 — Chord Engine:** keymap resolver, chord/interval computation, full combination matrix, voicing modes, extensions, all four play modes with correct note lifecycle, Held-mode latching.
4. **M4 — Strum Plate:** note-pool derivation, full + limited (Num-Lock-independent) layouts, strum params, immediate edit pickup.
5. **M5 — Rhythm Engine:** Core 1 scheduler/clock, pattern playback on ch10, integer tempo/fixed-point swing, mute, MIDI clock toggle, chord sync, keyboard-LED BPM indicator (FR-R8).
6. **M6 — Display:** LCD idle screen (+ dirty `*`), parameter-edit feedback, prompts.
7. **M7 — Presets/Config:** JSON load/save on LittleFS, 80-slot navigation, save/clear with auto-cancel, per-function channels, defaults for uninitialized slots.
8. **M8 — Polish:** panic control, latency/jitter tuning, robustness/hot-plug, config validation/fallback, full test suite, and hardening/finalizing the logging + MIDI monitor introduced in M2.
9. **M9 — USB Mass Storage & dev serial:** FatFS backend (LittleFS replaced so a PC can mount the drive), self-provisioning defaults in code, MSC bridge, and a boot-key composite mode. (See roadmap §6.)
10. **M10 — Chord Engine upgrades & Walking Bass:** chord roll, minimum note count, minimum-interval spread, manual inversions (`PrtSc`/`ScLk`/`Pause`), arpeggio modes (Up/Down/Up-Down/Alternating/Random), held extensions (`Left`/`Down`/`Right` as add9/11/13), and a dedicated **walking bass** engine (own params, edit menu `F12`, and preset `bass` block; meter-adaptive interval cycle, 6.8). The menus consolidate to `F9`–`F12`; the `Rhythm` play mode is removed.

> The v0.2 milestone set (M11–M17) is tracked in [`v0.2.0-roadmap.md`](v0.2.0-roadmap.md). M17 adds the on-device bass/rhythm/chord pattern editors (4.9, 5.11, 6.13, 8.5).

---

## 13. Acceptance Criteria

- **AC-1** Pressing a mapped chord key produces the correct chord notes (verified per 6.2) on the DIN output.
- **AC-2** Chord quality combinations produce chords per the matrix in 6.3 (incl. Major+Minor+7th = Augmented).
- **AC-3** All four play modes behave as specified, including note lifecycle (FR-C3/FR-C10): held sustains until next chord/panic, press-to-play releases on key-up, arpeggio uses note_duration_ms.
- **AC-4** Strum keys play chord notes in order; both full and limited layouts work; strum params take effect; strum picks up edits immediately (FR-S5).
- **AC-5** Rhythm patterns play correct GM drum notes on ch10; tempo and swing adjust live; mute suppresses drums but keeps sync.
- **AC-6** In arpeggio mode with rhythm enabled, chord timing follows the rhythm clock; early arp starts within 30 ms of the next arp boundary defer their first note to that boundary; the walking bass follows the rhythm beat.
- **AC-7** All 40 preset slots save/recall chord, strum, bass, rhythm params, macros, and their sequence files on LittleFS/FatFS; navigation keys behave per 4.4; save/clear confirm/cancel works.
- **AC-8** LCD shows the correct idle screen and updates on parameter edits and prompts.
- **AC-9** MIDI is emitted correctly on the DIN output; an unconnected/disconnected DIN does not disrupt operation; the firmware keeps running and transmitting.
- **AC-10** Measured key-to-MIDI latency meets NFR-1.
- **AC-11** Modifier keys (`Tab`/`Caps`/`Shift`×2/`[`/`'`) function as chord roots via raw HID report parsing, independent of any lock-LED state.
- **AC-12** Toggling voicing mode changes output between root-position and smart voice-leading; setting persists in preset.
- **AC-13** add9/add11/add13 extensions apply as held modifiers via `Left`/`Down`/`Right` arrows (latching per chord); they are not persisted.
- **AC-14** Left-adjacent combos produce sus4 (Major+left-7th) and add9 (Major+left-minor); leftmost column produces these via the `` ` `` key.
- **AC-15** In Held mode, editing any chord parameter (or loading a preset) while a chord is sounding does not change the currently-held notes; the change applies only when the next chord is triggered (FR-C9 / VR-5).
- **AC-16** MIDI clock transmit toggle (`F8`, or Clock Out in the Rhythm Edit menu) emits/stops the 24 PPQN clock stream (`0xF8` only; no automatic Start/Stop) on the DIN output. Switching on starts at the next 24-tick beat boundary so the external beat aligns with the LED; off is immediate. Double-tapping the Clock Out key sends MIDI Start at the next beat boundary (Clock Resync). The master clock timebase keeps running in the background regardless of the toggle (FR-R7, §7.3).
- **AC-17** Panic (`Super+Esc`) silences all notes on all channels/DIN and clears active-note state (FR-C11).
- **AC-18** Numpad strum keys behave identically regardless of the keyboard's Num Lock state (FR-S6).
- **AC-19** Save/clear prompt auto-cancels after 5 s idle, and any chord/strum key cancels it (FR-P10).
- **AC-20** Dirty marker (`*`) appears when active state differs from the stored preset and clears on save/load (FR-P11).
- **AC-21** Uninitialized/cleared preset slots load factory defaults with per-function channels 1/2/3/10 (FR-P9/FR-P12).
- **AC-22** Corrupt or missing config/presets on LittleFS are regenerated or fall back to defaults without crashing (NFR-9).
- **AC-23** When `bpm_indicator` is on, the configured LED (default Num Lock) flashes once per beat of the master clock, independent of rhythm/clock-out state; `Ctrl+F5` (or Beat LED in the Rhythm Edit menu) enables/disables it; LED unavailability does not affect timing or MIDI (FR-R8).
- **AC-24** Chord roll staggers note-ons by `chord_roll_ms` (positive ascending, negative descending) in Held/Press modes; note-offs release together.
- **AC-25** `min_notes` pads a chord with octave notes to at least the configured count (e.g. C major min 4 → `C E G C`).
- **AC-26** `min_interval` enforces the minimum semitone spacing between adjacent voicing notes in the tightest ascending configuration, composing with root/smart/up/down voicing modes and manual inversions.
- **AC-27** `PrtSc`/`ScLk`/`Pause` select 1st/2nd/3rd inversion; the selected inversion is reflected in the output (correct for every root, with the bass taken from the interval formula) and persists in the preset.
- **AC-28** The five arpeggio modes (Up/Down/Up-Down/Alternating/Random) step the voicing in the specified order.
- **AC-29** The walking bass plays the correct interval cycle on each beat (root–3rd–5th–6th/7th), adapts the cycle to the pattern's meter, follows the selected chord's root/type, respects its own octave/duration/velocity/channel, and stays in lockstep with the rhythm beat (never early). The configurable bass patterns (FR-B5) select among the walking cycle and the root/5th patterns.
- **AC-30** Sequence recording arms, mutes the normal pattern, stays silent until the next bar boundary, plays exactly one bar of quarter-note closed hi-hats, starts recording at the following bar boundary, keeps the hi-hat guide through the take, captures chord changes quantized to the 16th grid, and saves the selected slot per preset. The count-in/recording LCD status persists smoothly between bars. If the rhythm is disabled it is enabled automatically and the drums are muted. Recording over an existing sequence requires confirmation (`Overwrite Seq in` / `slot N? Ent/Bk`; Enter/Mute confirms, Backspace/Esc cancels).
- **AC-31** Sequence playback loops in sync with the rhythm clock, reproduces the merged recorded/live play mode (including arpeggio and chord-pattern modes), mixes recorded/live settings per the Live bits/global switch, and stops cleanly. Selecting another slot during playback queues it to start on the next loop boundary.
- **AC-32** Live chords override sequence events while held/latched and playback resumes at the next event afterward. FollowChord strumming follows the sounding sequence chord during playback, but strum never records or plays back.
- **AC-33** 40 presets (5 banks × 8) load/save; each preset owns 10 editable sequences (max 64 events each); clearing a preset removes its sequence file; legacy banks are removed on boot after a backup warning.
- **AC-34** The Pattern Edit mode opens for chord/rhythm/bass from the corresponding menu's **Edit Pattern** item and from `Super+F9`/`Super+F10`/`Super+F12`; it opens with the right kind/pattern. Escaping with unsaved edits prompts `Discard?`; the default keymap exposes `F9`/`F10`/`F11`/`F12` as Chord/Rhythm/Strum/Bass menus, `Super+F11` as Drum, and `Ctrl+F12` as Seq Edit.
- **AC-35** Pattern recording matches the M14 count-in: normal pattern suppressed, one bar of quarter-note closed hi-hats, N-bar take with the guide continuing, automatic stop, and rhythm enable/mute restored on exit. Live chord-grid keys remain available.
- **AC-36** Rhythm recording is polyphonic (multiple pads/tracks at one step) and bass recording is monophonic; same-track/step hits replace, and overdub preserves untouched steps. Quantize 1/4, 1/8, and 1/16 snap correctly at different tempos.
- **AC-37** Preview loops the working pattern from the next bar, uses the drum map for rhythm, resolves bass/chord degrees through the current/last chord, works before saving, and stops cleanly. Live chords override preview.
- **AC-38** The grid editor works for all kinds, bars, and 12/16-step meters: rhythm rest/hit/accent, bass degrees, chord hex bitmasks, sustain `-` display, `>` cursor, and correct cell editing.
- **AC-39** New/Save/Save As/Rename/Delete follow FR-E8: user files are `userN.json`, names are unique, built-ins overwrite only after confirmation, built-ins cannot be renamed/deleted, and deleting a user pattern leaves referencing presets on their previous/default pattern.
- **AC-40** Pattern caps/budgets are enforced (32 per kind, 8/4/4 KB per file, 48 KB user / 72 KB all-pattern); the configurator warns/errors at the same thresholds; saved patterns survive power cycles and appear in the configurator.
- **AC-41** New patterns inherit the live rhythm meter (12 for 3/4, 16 for 4/4); edits preserve the existing meter; record/preview show `Meter mismatch` when the live meter differs; 12-step patterns edit and play correctly.
- **AC-42** Opening the pattern editor stops sequence recording/playback and vice versa; pattern write actions are disabled while MSC is active; panic/all-notes-off stops recording and preview.
- **AC-43** Chord-pattern recording/editing captures root/3rd/5th/7th as a per-step bitmask: multiple degree pads at one step combine, `0` clears, held pads capture sustain, the grid displays hex `0`–`F`, and preview resolves the bitmask through the current chord.
- **AC-44** While the bass editor is open, the plain numpad pad keys play the bass (root/3rd/5th/6th-7th/root+8va, `0` = rest) using the current chord and preset bass parameters, and never strum. While the rhythm editor is open, the 13 numpad pad keys play drums through the preset DrumMap note/velocity and rhythm channel. While the chord editor is open, `KP1`–`KP4` play root/3rd/5th/7th through the current/last chord, held pads combine without retriggering unchanged degrees, and `KP0` releases the audition; in the chord grid the same keys keep their bit-toggle editing role. Modified numpad keys and the `+`/`−`/`Enter` keys keep their keymap actions.
- **AC-45** While a pattern editor is open, chord-grid keys and direct parameter-modifying keymap actions (including F1–F8, Ctrl/Alt combos, drum mute, tap tempo, and while a value item is selected) remain active, except `RhythmMute` in the rhythm editor and `BassEnable` in the bass editor; those are ignored and the matching editor forces rhythm-unmuted / bass-enabled output for the session. The rhythm editor restores the preset's prior mute/enable state on exit; the bass editor leaves the bass enabled. F2/F3/F4 are not editor shortcuts. Recording and preview stop with Enter/Mute or Esc/Backspace. The editor restores its screen after a passed parameter's transient value display.

> **Removed vs. the Pi spec:** the USB-MIDI-gadget acceptance clauses are gone (no USB MIDI in v1). AC-9 is reworded from "both USB and DIN" to DIN-only with graceful behavior when unconnected.

> **Acceptance-criteria numbering:** the criteria above are final for this Pico edition and numbered **AC-1 … AC-45** with no gaps; the roadmap's coverage matrix (Roadmap §6.1) maps every one of these to a milestone.

---

## 14. Open Items for Review
Resolved in this Pico port (see referenced sections): board/compute choice (RP2040 sufficient; see roadmap), language (C++17 / Arduino-Pico), USB keyboard hosting (CH559 coprocessor + UART bridge), MIDI path (DIN-only, USB host/gadget conflict eliminated), persistence (JSON on LittleFS via ArduinoJson), no-FPU integer/fixed-point swing, dual-core threading model, no-OS boot, testing via GoogleTest on a `native` env.

Still open (deferred to post-hardware testing):
1. **Final GPIO pin map** (CH559 UART0 `GP0`/`GP1`, `Serial2`/UART1 TX `GP8`, I2C SDA/SCL `GP4`/`GP5`): defaults proposed in 2.2; finalize during M12 bring-up and record in the roadmap hardware section.
2. **LCD line-2 layout (4.6 FR-D1):** to revisit after hardware testing. (Implementation approach in Roadmap §8.2 item 2 — shipped as the draft layout, data-sourced for tuning.)
3. **Rhythm list (7.1):** confirm/expand the pattern set. (The 12 named patterns to ship as-is are listed in Roadmap §8.2 item 3.)
4. **Persistence detail:** confirm JSON-on-FatFS for all tables vs. compiling large static tables into flash with JSON overrides (8.3).
5. **Pattern-file limits (8.5):** the initial 48 KB user / 72 KB all-pattern budget, 8/4/4 KB per-file caps, and 32-per-kind cap are provisional; tune them after measuring real on-device patterns.
6. **Pattern editor pad layout (5.11):** confirm the 13-piece numpad order and chord-degree pad layout on hardware; the mapping is fixed in the spec but can be revisited before release.
