t-bowzer/KCPico/docs/v0.2.0-roadmap.md

# KeybChord Pico — v0.2.0 Roadmap

> **Archived:** v0.2.0 is released and this plan is superseded by
> [`v0.3.0-roadmap.md`](v0.3.0-roadmap.md).

Development plan for v0.2.0. This supersedes the v0.1.0 plan
([`v0.1.0-roadmap.md`](v0.1.0-roadmap.md), archived). v0.1.0 is released; the
work below adds hardware updates (a CH559 USB-host coprocessor to replace the
unreliable PIO-USB keyboard host, a power switch, TRS MIDI out, USB MIDI out),
chord patterns, a chord sequencer, macros, and on-device bass/rhythm/chord
pattern editors. The configurator UI-refresh pass is deferred to post-v0.2.0.

Open design questions are recorded inline as **[DECIDE]** and must be resolved
at each milestone's kickoff.

## Status

| Milestone | Status | Notes |
|---|---|---|
| M11 USB MIDI out | Done | Hardware test plan available. |
| M12 CH559 host + power switch + TRS | Done | PCB assembled and hardware-verified; single BOOT button on CH559 `P4.6`, J5 `3V3` NC. |
| M13 Chord patterns | Done | 9 built-ins, configurator editor, tests. |
| M14 Chord sequencer | Done | 40 presets × 10 slots × 64 events; native tests and hardware checklist pass. |
| M15 Macros | Done | Named macros, MIDI libraries, editor, tests. |
| M16 Configurator v0.2 | Done | Chord-pattern, macro, and sequencer editors delivered; UI refresh deferred to post-v0.2.0. |
| M17 Pattern editors | Done | Three-kind editor engine, recording/grid/preview/save, runtime reloads, configurator budget validation, and hardware checklist pass. |

v0.2.0 is functionally complete and hardware-verified. Remaining release work is
documentation sync, the configurator version bump, and tagging `v0.2.0`.

---

## Flash budget (v0.2.0)

The filesystem is a 512 KB FatFS partition (~486 KB usable after FTL/FAT
overhead). Sequence and pattern files use compact JSON; other files are
pretty-printed.

| Item | Worst-case footprint |
|---|---:|
| 5 preset banks × 8 slots | ~64 KB |
| Built-in rhythm/bass/chord patterns | ~24 KB |
| User-created rhythm/bass/chord patterns (runtime budget) | ~48 KB |
| `config.json` + `keymap.json` | ~9 KB |
| Sequences (40 presets × 10 slots × 64 events) | ~280 KB |
| FAT/directories | ~6 KB |
| **Total** | **~431 KB** |
| **Free** | **~55 KB** |

Sequence files are per preset (`/sequences/b<N>p<M>.json`, all ten slots in one
file) so the filesystem does not pay a per-slot file/cluster cost. A fully
populated 10-slot file with 64 events per slot is under 7 KB (native test
`Sequence.WorstCaseFileFitsBudget` guards this).

---

## 0. Pre-0.2 (completed)

- Workspace cleaned; v0.1.0 tagged and published (firmware + configurator).
- Initial roadmap reconstructed and archived (`v0.1.0-roadmap.md`).
- Documentation verified up to date.

## 1. M11 — USB MIDI out (software)

Add a USB MIDI *device* endpoint so the instrument can drive a DAW without a
DIN/TRS cable.

- The keyboard is hosted by the **CH559** coprocessor (UART bridge on
  `GP0`/`GP1`). USB MIDI lives on the **native USB** port as a TinyUSB
  **composite CDC (debug log) + MIDI** device — so USB MIDI and serial debugging
  coexist (spec's "USB MIDI + serial debugging at the same time?" = **yes**).
- USB MIDI + DIN/TRS simultaneously = **yes**: `MidiRouter` gains a second
  output target (fan-out to DIN UART and the USB MIDI interface). Cost is a
  message copy per event; no CPU concern on the RP2040.
- **Selection is a runtime toggle** (config `midi.usb_enabled` + a keymap
  binding), consistent with the existing DIN/clock/rhythm toggles — not a
  boot-key mode.
- Revise spec §1.3 (remove the "no USB MIDI" non-goal), §3.4, §4.5, and the
  custom-configuration guide.
- **Verify:** MIDI arrives over USB on a host while DIN still transmits;
  CDC debug log keeps working; USB-MIDI-off behaves as today.

## 2. M12 — Hardware: CH559 USB host + power switch + TRS MIDI out

### 2a. Replace the PIO-USB keyboard host with a CH559 coprocessor (reliability)

The PIO-USB host (a software USB host bit-banged over PIO state machines) is
unreliable: it fails to enumerate hubs and keyboards whose descriptors exceed the
stack's small enumeration buffer, so only a subset of modern keyboards work. The
RP2040 itself is fine — only the host *port* is at fault. Replace it with a
dedicated **CH559** (WCH) — a cheap 8051 MCU with a *hardware* USB host
controller — acting as a **keyboard host coprocessor**. It enumerates the
keyboard (hubs + report/NKRO protocols), parses HID reports, and forwards key
events to the RP2040 over a UART bridge; the RP2040 stays a pure C++17 app and
keeps the dual-core split, bootloader, MIDI/LCD, and FatFS+MSC storage unchanged.

- **Form factor (decided):** bare **CH559L** (LQFP-48, hand-solderable) on the
  custom PCB, ~$1.5. It runs off its internal oscillator (no crystal needed).
  **Pre-commit gate:** validate keyboard compatibility first on a cheap breakout
  (e.g. MatzElectronics CH559 USB Host Breakout, Tindie $9.50, or the
  Electrodragon CH559 mini board $5.30) flashed with the HIDman/`atc1441` host
  firmware, plugged into the keyboards that currently fail on PIO-USB.
- **Host firmware (decided):** the CH559 side is **8051 C** (SDCC, via the
  `atc1441/CH559sdccUSBHost` fork used by HIDman — GPL-3.0, acceptable because
  it's a *separate chip* and does not contaminate the MIT RP2040 firmware). The
  fork is vendored in-tree at **`firmware/ch559/`** (git-subtree import, built
  with `make`). The RP2040 side is a new UART-bridge `InputAdapter` (C++).
- Extract the keyboard report→`KeyEvent` semantics (multi-interface selection,
  report-ID / boot-vs-NKRO parsing, modifier→usage, LED SET_REPORT) into the
  CH559 bridge adapter. PIO-USB and its legacy build are deprecated.
- Add the CH559 UART pins to `pins.h` (`GP0`/`GP1` on `Serial1`); update
  `docs/wiring.md` + `wiring.png`.
- **Verify (hardware):** enumerate a hub-connected keyboard and a long-descriptor
  keyboard that currently fail on PIO-USB; confirm key events, LEDs, and hot-plug.
  **[DECIDE]** exact UART protocol framing at kickoff.

### 2b. Power switch + 3.5 mm TRS MIDI out

BOM/wiring/spec changes only; no firmware change expected.

- Add a **power switch** in the 5 V path (between supply and `VBUS`/`VSYS`).
- Add a **3.5 mm TRS (Type-A) MIDI out** jack wired in parallel with the DIN
  current loop (same `GP8`/3V3 signal; TRS type-A: tip = pin 5, ring = pin 4,
  sleeve = pin 2 GND).
- Update `docs/wiring.md` + regenerate `wiring.png`; update spec §2 (BOM,
  connections, notes).
- **Verify:** hardware-level; confirm both DIN and TRS drive a downstream synth.

## 3. M13 — Chord patterns

User-authored patterns for playing chords — arpeggios or multiple simultaneous
notes — analogous to the existing bass patterns.

- New `ChordPattern` engine + JSON format under `/chordpatterns/*.json`
  (9+ built-ins, user files appended), 16th-note grid driven by the rhythm
  clock in lockstep with drums/bass (like bass patterns and arp sync).
- Each step = a note-degree/duration: degree indices resolve through the active
  chord's pitch classes. **[DECIDE]** exact scheme for 3-note vs 4-note chords
  (proposal: indices 0–3; index 3 = the 7th when present, else rest/wrap on a
  triad). Multi-note steps allowed (multiple degrees at once).
- Per-preset association, with a **copy-from-preset** action (configurator +
  device key). Patterns are copied, not shared.
- Flash: measure a sample pattern's JSON size; set a per-preset pattern cap and
  record the total footprint against the 512 KB budget.
- Spec §6/§8 updates; configurator pattern editor; native unit tests for degree
  resolution (3- vs 4-note) and step scheduling.

## 4. M14 — Chord sequencer — **Implemented**

Record chord presses + timing and play them back, synced to the rhythm clock —
not a full MIDI sequencer.

- **Capacity:** 40 presets (5 banks × 8), **10 sequences per preset**, 1/2/4/8
  bars, **max 64 events per sequence**.
- **Storage (decided):** separate per-preset files at
  `/sequences/b<N>p<M>.json`, all ten slots in one compact JSON file. A missing
  or corrupt file loads as empty. Recording/clear/bar changes save immediately;
  sequences are not copied by preset Save. Preset Clear removes the file.
- **Recording:** `Ctrl+F9` arms and immediately mutes the normal pattern. The
  hi-hat guide stays silent until the next bar boundary, then plays exactly one
  bar of quarter-note closed hi-hats. Recording starts at the following bar
  boundary and the hi-hat guide continues through the take; the pattern/mute
  state resumes afterward. Chord changes only (no
  strum/individual MIDI), quantized to the nearest 16th; a chord already
  held/latched at the downbeat becomes step 0. If rhythm is off, record/play
  enable it automatically and mute the drums. The count-in/recording LCD status
  is persistent (no idle flash). Recording over an existing slot prompts for
  confirmation.
- **Playback:** `Ctrl+F10` arms; loops from the next rhythm bar until stopped.
  Live chords remain available: while a live chord is held/latched, sequence
  events are skipped and playback resumes at the next event afterwards.
- **Settings:** one snapshot per sequence (all chord params including play
  mode and arp rate; channel stays live). Playback honors the merged play mode,
  so recorded arpeggios/patterns reproduce. Per-setting Live bits are edited in
  the configurator; the device Seq menu has a global Recorded/Live switch.
- **Controls:** `Ctrl+1`…`Ctrl+0` select slots (hard-coded; overrides
  Ctrl+number strum); `Ctrl+F9/F10/F11` record/play/clear; `Ctrl+F12` opens
  Seq Edit (Slot/Bars/Settings). Record/play/clear/menu are rebindable.
- **Configurator:** full Sequences tab inside the preset editor (bar/step grid,
  chord picker, settings snapshot, per-setting Live checkboxes).
- **Tests:** native sequence model/engine/keymap/preset tests, configurator
  pytest model/storage/validator tests, and
  [`hardware-test-plan-sequencer.md`](../hardware-test-plan-sequencer.md).
- **Hardware-test fixes:** main loop tightened to 1 ms and LED serviced before
  slow display work; live tempo changes re-slave the pattern to the next clock
  beat (no LED/drum drift); MIDI clock-out starts on the next 24-tick beat
  boundary so it re-syncs with the LED when toggled; persistent recording status;
  hi-hat count-in with the pattern muted.
- **Spec:** §4.8, §5.10, §6.11/6.12, §8.4, §9, AC-30…AC-33 updated.
- **Flash:** documented in the table above; ~103 KB free in the worst case.

## 5. M15 — Macros

One-key recall of a bundle of settings/values/actions, per-preset, configured in
the configurator.

- **Top-row `1–0` is selectable per preset** between strum and macro keys;
  the numpad remains the strum plate. `Super+1`…`Super+8` still loads presets.
- A macro = an ordered list of `set` / `toggle` / `cycle` / `inc` / `dec`
  parameter actions plus per-piece `drum_mute`, reusing the existing parameter
  model. Example: mute rhythm, mute kick, set BPM to 88.
- Per-preset; **16 commands/key and 48 commands/preset** (the firmware truncates
  excess; the configurator rejects it) to stay within the 512 KB flash budget.
- Spec §4.2/§5.2/§8.2 updates; configurator macro editor; native unit tests
  applying macros against the parameter model.

## 6. M16 — Configurator v0.2

- **Done:** chord-pattern, macro, and chord-sequence editors (models,
  validation, UI).
- **Deferred post-v0.2.0:** the "more intuitive / cleaner UI" pass.

## 7. M17 — Bass, rhythm & chord pattern editors (v0.2.0 scope)

Create and edit the three pattern libraries on the device, without a PC. This is
Three editor screens — **Chord Pattern**, **Rhythm Pattern**, and **Bass
Pattern** — each opened from its own menu item/direct key and sharing the same
command set. There is no in-editor Kind selector.

**Progress:** the spec/docs, serializers, keymap/menu plumbing, the three-kind
`PatternEditorEngine` (record/grid/preview/save), runtime library reloads, and
configurator budget validation are implemented and tested. Hardware verification
against the checklist passed on the assembled v0.2.0 PCB.

- **Entry:** an **Edit Pattern** item at the end of the Chord, Rhythm, and Bass
  edit menus, plus rebindable `open_menu` actions:
  - `Super+F9` — chord patterns
  - `Super+F10` — rhythm patterns
  - `Super+F12` — bass patterns

  To make every pattern editor `Super + its menu key`, the default keymap swaps
  the Strum and Rhythm menu keys (`F11` = Strum, `F10` = Rhythm), keeps
  `Super+F11` = Drum, and moves **Seq Edit** from `Super+F12` to `Ctrl+F12`.
  `Ctrl+F9`/`Ctrl+F10`/`Ctrl+F11` remain sequence record/play/clear. Custom
  keymaps remain valid; only the shipped defaults/docs/configurator change.
- **Working copy:** edits are in memory until Save/Save As; exiting with unsaved
  changes prompts `Discard?`. New patterns default to one bar and inherit the
  live rhythm meter (16 in 4/4, 12 in 3/4); edits preserve the meter. Bars are
  1/2/4/8.
- **Recording:** M14-style one-bar hi-hat count-in, then N bars with the guide
  continuing; auto-stop. Enter/Mute or Esc/Backspace stops a take or preview.
  Normal rhythm/bass playback is suppressed and the rhythm enable/mute state is
  restored on exit. Quantize is a capture-time snap: `1/4`, `1/8`, or `1/16`
  (default `1/16`); it is not stored in JSON.
- **Pads:** Num-Lock-independent numpad.
  - Rhythm: `1`–`9`, `0`, `.`, `/`, `*` = 13 pieces; polyphonic, multiple
    tracks per step.
  - Bass: `1`–`4` = root/3rd/5th/6th-or-7th, `0` = rest; monophonic.
  - Chord: `1`–`4` = root/3rd/5th/7th (combine into a bitmask), `0` = clear;
    polyphonic.
  Recording is **overdub**: untouched steps/tracks are preserved. Clear resets
  the working buffer for a fresh take. Held bass/chord pads capture
  `sustain_steps`; rhythm hits store default/accent velocity. Plain numpad pad
  keys are also live outside recording: bass degrees use the preset bass
  parameters; rhythm pieces use the preset DrumMap. `+`/`−`/`Enter` keep their
  parameter actions. Chord-grid keys and direct parameter-modifying keymap
  actions stay active; top-row strum/macro stays disabled. F2/F3/F4 are not
  editor shortcuts.
- **Preview:** loops the working pattern from the next bar, works before saving,
  and uses the drum map for rhythm / the current-last chord for bass and chord.
- **Grid:** two-line LCD, one track/bar at a time. Rhythm rest/hit/accent; bass
  rest/root/3rd/5th/6th-7th; chord hex `0`–`F` bitmask with the cursor step
  decoded on line 1. Sustains show as `-`; the cursor cell shows `>`. Esc/
  Backspace returns to the command screen.
- **Files:** existing schemas, no new fields. `/rhythms/userN.json`,
  `/bass/userN.json`, `/chordpatterns/userN.json`; compact JSON on device and
  in the configurator; `bars` inferred from
  `steps.length / steps_per_bar`. Built-ins may be overwritten with
  confirmation; built-ins cannot be renamed/deleted. Presets store pattern
  names, so file ordering is irrelevant.
- **Limits:** 32 total patterns per kind; combined 72 KB all-pattern budget
  (built-ins + user), of which user-created patterns may use 48 KB; per-file
  caps 8 KB rhythm, 4 KB bass, 4 KB chord. Enforced on save and mirrored by
  configurator validation. Reject with `Pattern limit` / `Pattern too large`.
- **Compatibility:** on-device patterns appear in the configurator editors. No
  configurator schema changes; the keymap model/validator gains the three
  `open_menu` names and the new default bindings.
- **Exclusion:** opening the pattern editor stops sequence recording/playback and
  vice versa; write actions are disabled while MSC is active; panic stops
  recording/preview.
- **Tests:** native serializer/quantize/overdub/sustain/grid/budget tests;
  configurator keymap and budget tests; hardware checklist in
  [`hardware-test-plan-pattern-editor.md`](../hardware-test-plan-pattern-editor.md).
- **Flash:** the user-pattern row in the budget table above; ~55 KB free in the
  worst case.

## Cross-cutting

- **Flash budget (512 KB FatFS)** is measured and documented in the table near
  the top of this file. Sequence storage is the dominant v0.2 cost.
- **Spec stays the source of truth** (`KeybChord_Pico_Spec.md`); README, wiring,
  and custom-config guide updated at each milestone.
- **Tests:** every milestone keeps the native GoogleTest suite green and adds
  coverage; the configurator adds `pytest` coverage. M17 adds serializer,
  quantize, overdub, sustain, grid, budget, and keymap tests plus the pattern
  editor hardware checklist.
- **Hardware changes (M12)** are electrically independent and can proceed in
  parallel with the software milestones.
- **Storage is unchanged by M12:** the RP2040 stays, so config/presets/patterns
  remain on the onboard FatFS + MSC drag-drop drive (no MTP migration needed).
  The keyboard-host swap (2a) touches only the USB *input* path.

### Milestone ordering

M11 (USB MIDI, software) → M12 (hardware, parallel-able) → M13 (patterns) →
M14 (sequencer) → M15 (macros) → M16 (configurator) → M17 (pattern editors).
M13–M15 are ordered by dependency: patterns (M13) precede the sequencer (M14),
which records chord behavior including patterns; macros (M15) depend only on the
parameter model and can begin after M13. M17 depends on the M13/M14 pattern and
count-in work and was the final v0.2.0 software milestone. M12/M14/M17 hardware
verification is complete, so v0.2.0 is ready to tag after the configurator
version bump and documentation sync; the M16 UI refresh follows in a later
release.
