t-bowzer/KCPico/docs/v0.3.0-bom.md

# KeybChord Pico — v0.3.0 BOM and Prototype Ordering (M18)

> **Status:** draft — prototype order list. This is **not** the rev A
> production BOM. Quantities here cover bench prototypes and spares only.
> Rev A quantities are set after the M18 exit gate.

Part numbers are intentionally omitted until sourcing is confirmed; use the
descriptions and constraints below to request quotes. Record the chosen part
and second source in the M18 decision log.

## Prototype order list

### Compute and mounting

| Qty | Item | Constraint | Purpose | Class |
|----:|---|---|---|---|
| 2 | Raspberry Pi Pico H (pre-soldered headers) | RP2040, 2 MB flash, micro-USB | D1 socket cycling + test-bed emulator | Prototype |
| 4 | 2×20 2.54 mm female header socket, 8.5 mm class | Must accept Pico H headers; low insertion force | Main-PCB socket candidate + spares | Rev A candidate |
| 1 | Standard Pico (no headers) | Same RP2040 board | Compare stack/height option | Prototype |

### Display

| Qty | Item | Constraint | Purpose | Class |
|----:|---|---|---|---|
| 2 | 2.42" 128×64 SSD1309 I2C OLED module | 3.3 V, address 0x3C/0x3D, I2C-capable pinout, charge pump | D5 refresh/readability bench + spare | Rev A candidate |
| 1 | Alternative 2.42" module (different vendor/controller marking) | Same size; verify actual controller | Second-source check | Prototype |

### CH559 and USB port sharing

| Qty | Item | Constraint | Purpose | Class |
|----:|---|---|---|---|
| 2 | CH559 USB host breakout | Breaks out HP/HM, DP/DM, UART1, 5 V, GND | D2 bench prototype | Prototype |
| 2 | USB-A host receptacle breakout | D+/D-/VBUS/GND pads | Host/device switch wiring | Prototype |
| 2 | DPDT slide switch | Through-hole or solderable; ≥ 1 A contacts | D+/D- mode routing | Rev A candidate |
| 2 | USB mux IC alternative | Full/low-speed DPDT-equivalent | Compare against slide switch | Prototype |
| 2 | Power mux / ideal-diode module | 5 V, ≥ 1 A, low forward drop | VBUS back-feed protection | Rev A candidate |
| 4 | Schottky diode, 1 A class | Low Vf | Back-feed fallback topology | Rev A candidate |
| 2 | P-channel MOSFET + gate network | 5 V load-switch class | VBUS source selection | Rev A candidate |
| 2 | Reset tactile switch | 6×6 mm class | Deterministic CH559 reset | Rev A candidate |
| 1 | RC reset network assortment | Resistor/capacitor kit | Reset timing experiment | Prototype |
| 1 | USB-A-to-A plug breakout pigtail | Explicitly labeled; used only on the bench | Shared-A flashing test | Prototype |

### Bench and harness

| Qty | Item | Constraint | Purpose | Class |
|----:|---|---|---|---|
| 1 | USB 2.0 hub, externally powered | Real hub, not a passive splitter | D8 enum/edge cases | Prototype |
| 1 | Solderable perfboard / breakout kit | 2.54 mm | Switch + reset prototype | Prototype |
| 1 | Dupont/jumper wire set | — | Bench wiring | Prototype |
| 1 | USB power meter / inline current meter | 5 V, ≥ 2 A | Back-feed and current checks | Prototype |
| 1 | Bench supply or adjustable 5 V source | ≥ 1 A, current limit | Controlled power tests | Prototype |

## Display options (D5)

Prices checked **2026-11-13** and exclude shipping/tax. Confirm the controller
marking on arrival; 2.42" modules are sometimes SH1106/SH1107 despite the
listing.

| Option | Price | Size / module | Interface / power | Notes |
|---|---:|---|---|---|
| [HiLetgo 2.42" SSD1309](https://www.amazon.com/dp/B0CFF3XNX4) | $16.99 | 2.42", 128×64 | 4-pin I2C (IIC version) or 7-pin SPI; voltage not listed, verify 3.3 V | White/blue/green/yellow; best quick I2C bench option |
| [Waveshare 2.42" OLED](https://www.waveshare.com/2.42inch-oled-module.htm) ([Amazon](https://www.amazon.com/dp/B0CL6WMHJN)) | $12.99 direct; $19.99 Amazon | 2.42", 128×64; active 55.01×27.49 mm; module 61.50×39.50 mm | 3.3/5 V; 4-wire SPI default, I2C via two 0R resistor moves; 7-pin 1.25 mm | I2C address 0x3C/0x3D via DC pin; onboard translator; cheapest 2.42" direct |
| [Adafruit 2719](https://www.adafruit.com/product/2719) | $39.95 ($35.96 @10, $31.96 @100) | 2.42", 128×64; module 29×56×6.8 mm | 3.3 V, ~50 mA; 8-bit/SPI/I2C; ships SPI, I2C via solder | Includes level shifter, 220 µF cap, loose header; known-good reference but expensive |
| [DisplayModule DM-OLED242-693](https://www.displaymodule.com/products/2-42-inch-oled-graphic-display-128x64-all-view-with-spi-i2c) | $34.90 module; panel options vary | 2.42", 128×64; active 55.01×27.49 mm; module 60.5×37×2 mm | VDD 1.65–3.3 V, 42.3 mA; SPI/I2C/parallel | 180° view, 30k h; 15/tray; 100+ volume pricing — best production/OEM source |
| [BuyDisplay 2.4" SSD1309](https://www.buydisplay.com/blue-2-4-inch-graphic-oled-display-128x64-serial-spi-i2c-ssd1309) | $10.90 (as low as $9.75) | 2.4", 128×64 (slightly smaller than 2.42") | SPI/I2C; blue/white/yellow; touch optional | Cheapest; good volume second source |
| [DIYables 2.42" I2C](https://www.amazon.com/dp/B0GZHW1KD4) | $18.99 | 2.42", 128×64 | 4-pin I2C; presoldered; blue/white | Alternate quick I2C module if HiLetgo is out of stock |

**Wiring caveat:** the v0.2 I2C header (`J2`) is `1=GND, 2=3V3, 3=SDA, 4=SCL`.
Many 4-pin OLED modules are labeled `GND, VCC, SCL, SDA`, so check the
silkscreen and swap SDA/SCL in the harness if needed. Modules usually include
I2C pull-ups; do not leave the PCF8574 backpack connected at the same time.

**Firmware caveat:** the current LCD adapter probes PCF8574 at `0x27`/`0x3F`;
the SSD1309 is at `0x3C`/`0x3D`. Until M20 adds the OLED adapter, bench-test
the panel with a standalone Pico/Arduino sketch rather than the release
firmware.

**Recommendation:** buy 2× HiLetgo 4-pin I2C for immediate M18 bench work (no
rework, direct fit), 1× Waveshare as the 2.42" second source/mechanical
reference, and request volume quotes from DisplayModule and BuyDisplay for rev
A. Use Adafruit only if a known-good reference unit justifies the premium.

### Bulk sourcing (2.42"/2.4" 128×64 I2C)

The 2.4" and 2.42" listings are the same 128×64 panel class (active area
55.01×27.49 mm). Public tiers checked **2026-11-13**; all exclude shipping, tax,
and import duty. Alibaba promo prices are time-limited and must be confirmed by
quote.

| Supplier / form | Public price tiers | MOQ | Link |
|---|---|-----|---|
| Shenzhen Haoran — finished **4-pin I2C PCBA** (`HE242P04W`) | **$12.00** 1–99; **$11.20** 100–999; **$10.80** 1,000–99,999; $8.65 ≥100,000 | 1 | [Alibaba](https://www.alibaba.com/product-detail/OLED-2-4-2-42-Inch_1601813910525.html) |
| Shenzhen Haoran — finished 4-pin I2C module (promo listing) | **$5.62–7.80** promo (list $8.65–12; 35% off) | 1 | [Alibaba](https://www.alibaba.com/product-detail/HAORAN-2-42-inch-TFT-OLED_1601760464535.html) |
| Shenzhen Haoran — **bare 2.42" PMOLED FPC**, 24-pin, SSD1309 | **$5.98–7.20** promo (list $6.65–8; 10% off) | 1 | [Alibaba](https://www.alibaba.com/product-detail/2-42-Inch-PMOLED-128x64-White_1601196392650.html) |
| BuyDisplay / EastRising — bare 2.4" panel (`ER-OLED024-2B`), FPC | **$10.90** @1; **$10.61** @10; **$10.33** @30; **$10.04** @50; **$9.75** @100; 500+ quote | 1 | [BuyDisplay](https://www.buydisplay.com/blue-2-4-inch-graphic-oled-display-128x64-serial-spi-i2c-ssd1309) |
| BuyDisplay — finished SPI/I2C breakout module | **$18.69** | 1 | [BuyDisplay](https://www.buydisplay.com/spi-i2c-blue-2-4-inch-arduino-raspberry-pi-oled-display-module-128x64) |
| AliExpress — finished 4-pin I2C module (reference, not bulk) | **$8.12–8.69** each at qty ≥2 | 1–2 | [AliExpress search](https://www.aliexpress.com/w/wholesale-2.4-inch-oled-ssd1309-i2c.html) |

**Order placed 2026-11-13:** one finished 4-pin I2C module from the AliExpress
listing above. Record the exact listing/variant on arrival and verify the
controller marking, 3.3 V operation, pin order, and I2C address before
connecting it to the v0.2 `J2` header.

**Lowest verified paths**

- **Bare panel (lowest BOM):** Haoran 2.42" PMOLED FPC at **$5.98–7.20** (promo)
  or **$6.65–8** list, MOQ 1. At 500–2,000 units this should quote below the
  public 1-piece price; expect roughly **$5–6.50** but confirm. Requires a
  24-pin 0.5 mm FPC/ZIF connector, charge-pump passives, and FPC handling on the
  main PCB.
- **Finished 4-pin module (lowest integration risk):** Haoran 4-pin I2C PCBA at
  **$10.80 @1,000–99,999** list, or the current promo listing at **$5.62–7.80**
  (MOQ 1). Request a 500/1,000/2,000 quote; a negotiated price around **$7–9**
  is the realistic target if the promo does not hold.
- **BuyDisplay** is the cheapest *published* 100-piece tier at **$9.75** for the
  bare panel, but Haoran's public bare-panel listing is lower and its 4-pin
  PCBA is the cheaper finished option.

**RFQ ask:** 2.42" 128×64 PMOLED, SSD1309, 3.3 V, I2C (4-pin PCBA and bare
24-pin FPC versions), white, 500/1,000/2,000 units, with unit price, tooling,
lead time, and sample cost. Quote Haoran, BuyDisplay/EastRising, and one
additional panel maker for comparison.

## Sourcing and risk notes

- Verify the OLED module's **actual controller** before layout; 2.42" modules
  are sometimes SH1106 or SH1107 despite SSD1309 listings.
- Confirm the female socket accepts the Pico H header length without the Pico
  bottoming out on the PCB.
- The USB mux/ideal-diode parts are lifecycle-sensitive; identify a second
  source before committing to rev A.
- The A-to-A pigtail is a bench-only item. Do not ship it or recommend it to
  users unless D2 explicitly commits to the shared-A design with a safe,
  labeled adapter.
- Record LCSC/JLCPCB basic-vs-extended status when the rev A BOM is fixed.

## RFQ draft

> **Subject:** Quote request — KeybChord Pico rev A PCBA (prototype 5–10,
> pilot 500–2,000)
>
> Hello,
>
> We are preparing a small-batch open-source MIDI instrument and would like a
> quote for PCBA. The board is RP2040-based with a socketed Raspberry Pi Pico
> module, a WCH CH559L USB controller, a 2.42" 128×64 I2C OLED header, USB-A
> keyboard receptacle, DIN/TRS MIDI connectors, and a small USB mode switch.
>
> Please quote:
>
> 1. **Prototype:** 5 and 10 assembled boards, turnkey or consigned.
> 2. **Pilot:** 500 and 2,000 assembled boards.
>
> Please include:
>
> - Unit price at each quantity, with and without the Pico module.
> - NRE, stencil, tooling, and test-fixture costs.
> - Assembly/test time assumptions and yield.
> - Ability to place: 2×20 THT female socket, THT USB-A/DIN/TRS connectors,
>   CH559L (SSOP or package as noted), and SMT passives.
> - Component sourcing responsibility and lifecycle/second-source notes.
> - Lead time for prototypes and pilot.
> - Whether you can program/test the board before the Pico is inserted, and
>   whether you can insert and test the Pico at final assembly.
>
> We can supply a BOM/CPL and Gerbers after the design review. Please flag any
> parts that would need to change for your process.
>
> Thank you.

## Loaded-cost model (stub)

Fill after quotes arrive. Compare the socketed-Pico design against the deferred
direct-RP2040 / 4 MB / USB-C design.

| Cost item | Pico socket @ 500 | Pico socket @ 2,000 | Direct RP2040 @ 500 | Direct RP2040 @ 2,000 |
|---|---:|---:|---:|---:|
| PCB | TBD | TBD | TBD | TBD |
| Components | TBD | TBD | TBD | TBD |
| Pico module | TBD | TBD | — | — |
| Assembly | TBD | TBD | TBD | TBD |
| Test | TBD | TBD | TBD | TBD |
| NRE / tooling | TBD | TBD | TBD | TBD |
| Consignment / handling | TBD | TBD | TBD | TBD |
| Yield allowance | TBD | TBD | TBD | TBD |
| **Loaded unit cost** | **TBD** | **TBD** | **TBD** | **TBD** |

Include the cost of sourcing, programming, and inserting the Pico separately in
the socketed columns, and the additional NRE/assembly/test work in the direct
columns.
