t-bowzer/KCPico/KCPico.kicad_sch

## KiCad design KCPico.kicad_sch (2026-11-13)

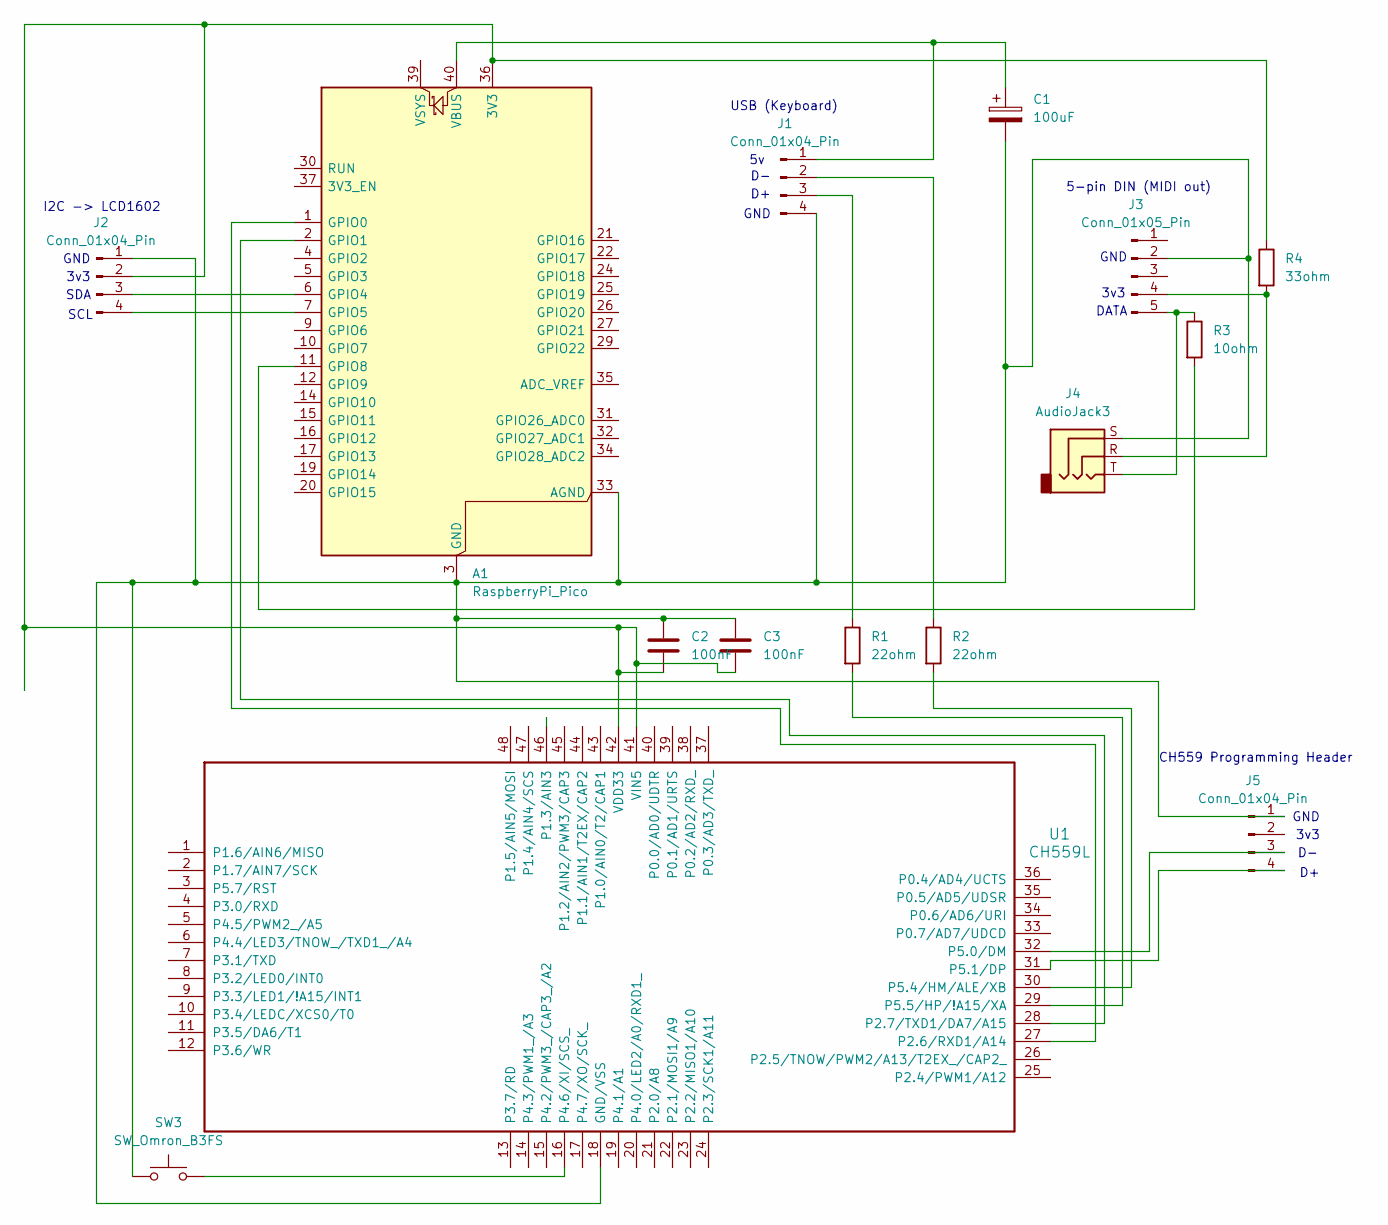
[picture p2: schematic KCPico.kicad_sch]

Parts:
A1: RaspberryPi_Pico; RaspberryPi_Pico_Common_Unspecified
C1: 100uF; CP_Radial_D5.0mm_P2.50mm
C2, C3: 100nF; C_Disc_D10.0mm_W2.5mm_P5.00mm
J1: Conn_01x04_Pin; USB_A_Molex_67643_Horizontal
J2, J5: Conn_01x04_Pin; PinHeader_1x04_P2.54mm_Vertical
J3: Conn_01x05_Pin; 1134_Corrected
J4: AudioJack3; Jack_3.5mm_CUI_SJ-3523-SMT_Horizontal
R1, R2: 22ohm; R_Axial_DIN0207_L6.3mm_D2.5mm_P10.16mm_Horizontal
R3: 10ohm; R_Axial_DIN0207_L6.3mm_D2.5mm_P10.16mm_Horizontal
R4: 33ohm; R_Axial_DIN0207_L6.3mm_D2.5mm_P10.16mm_Horizontal
SW3: SW_Omron_B3FS; SW_TH_Tactile_Omron_B3F-100x
U1: CH559L; LQFP-48_7x7mm_P0.5mm

Connections:
unnamed: A1.1 (GPIO0), U1.27 (P2.6/RXD1/A14)
unnamed: A1.2 (GPIO1), U1.28 (P2.7/TXD1/DA7/A15)
unnamed: A1.6 (GPIO4), J2.3 (Pin_SDA)
unnamed: A1.7 (GPIO5), J2.4 (Pin_SCL)
unnamed: A1.11 (GPIO8), R3.2
unnamed: A1.3 (GND), A1.8 (GND), A1.13 (GND), A1.18 (GND), A1.23 (GND), A1.28 (GND), A1.33 (AGND), A1.38 (GND), C1.2, C2.1, C3.1, J1.4, J2.1 (Pin_GND), J3.2, J4.S, J5.1 (Pin_GND), SW3.1, U1.18 (GND/VSS)
unnamed: A1.36 (3V3), C2.2, C3.2, J2.2 (Pin_3v3), R4.1, U1.41 (VIN5), U1.42 (VDD33)
unnamed: A1.40 (VBUS), C1.1, J1.1
unnamed: J1.2, R2.1
unnamed: J1.3, R1.1
unnamed: J3.4, J4.R, R4.2
unnamed: J3.5, J4.T, R3.1
unnamed: J5.3 (Pin_D-), U1.32 (P5.0/DM)
unnamed: J5.4 (Pin_D+), U1.31 (P5.1/DP)
unnamed: R1.2, U1.29 (P5.5/HP/!A15/XA)
unnamed: R2.2, U1.30 (P5.4/HM/ALE/XB)
unnamed: SW3.2, U1.16 (P4.6/XI/SCS_)

Notes on the sheet:
GND
DATA
SDA
SCL
3v3
CH559 Programming Header
5-pin DIN (MIDI out)
I2C -> LCD1602
USB (Keyboard)
