t-bowzer/KCPico/keybchord/src/main.cpp

#include <Arduino.h>
#include "pins.h"
#include "factory.h"
#include "config.h"
#include "defaults.h"
#include "keymap.h"
#include "state.h"
#include "midi_router.h"
#include "midi_event_queue.h"
#include "midimsg.h"
#include "chord_engine.h"
#include "strum_engine.h"
#include "bass_engine.h"
#include "bass.h"
#include "rhythm_engine.h"
#include "edit_engine.h"
#include "display_manager.h"
#include "pattern_editor_engine.h"
#include "preset_engine.h"
#include "sequencer_engine.h"
#include "perf.h"
#include "debug_log.h"
#include "msc_fatfs.h"
#include "version.h"

#ifdef KEYBCHORD_TEST_HOOK
#include "test_hook.h"
#endif

#if defined(ARDUINO_ARCH_RP2040)
#include "device/usbd.h"
#endif

#if defined(ARDUINO_ARCH_RP2040)
#include "pico/time.h"      // time_us_64() (64-bit monotonic; micros() wraps at ~71 min)
#include "pico/bootrom.h"   // reset_usb_boot()
#include "pico/multicore.h" // multicore_reset_core1()
#endif

static Adapters        g_adapters;
static StateManager    g_state;
static KeymapResolver  g_keymap(&g_state.keymap);
static MidiRouter*     g_router = nullptr;
static ChordEngine*    g_chordEngine = nullptr;
static StrumEngine*    g_strumEngine = nullptr;
static BassEngine*     g_bassEngine = nullptr;
static MidiEventQueue  g_rhythmQueue;
static RhythmEngine*   g_rhythmEngine = nullptr;
static DisplayManager* g_display = nullptr;
static EditEngine*     g_editEngine = nullptr;
static PresetEngine*   g_presetEngine = nullptr;
static SequencerEngine* g_sequencer = nullptr;
static PatternEditorEngine* g_patternEditor = nullptr;
static MscFatFs*       g_msc = nullptr;
static bool            g_keymapError = false;  // set when keymap.json fails validation

#ifdef KEYBCHORD_TEST_HOOK
static TestHook*       g_testHook = nullptr;
#endif

static inline uint64_t nowUs() {
#if defined(ARDUINO_ARCH_RP2040)
    return time_us_64();
#else
    return micros();
#endif
}

static uint8_t ledUsageFor(const AppConfig& cfg) {    switch (cfg.led_indicator) {
        case LedTarget::CapsLock: return midi::LED_CAPS_LOCK;
        case LedTarget::NumLock:  return midi::LED_NUM_LOCK;
        case LedTarget::ScrollLock:
        case LedTarget::All:
        default:                  return midi::LED_SCROLL_LOCK;
    }
}

// Beat-LED state owned entirely by Core 0 (the Core 1 scheduler only posts a
// "flash" request). Keeping the on/off deadline local avoids any cross-core
// torn read that could leave the keyboard LED stuck on.
static bool     g_ledOn       = false;
static uint64_t g_ledOffAtUs  = 0;
static bool     g_ledDirty    = false;

// Drum audition (Upgrade-Plan): a one-shot note-on/note-off so the user hears
// the selected drum code while editing it in the Drum menu.
static uint8_t  g_auditionNote = 0xFF;
static uint8_t  g_auditionChannel = 0;
static uint64_t g_auditionOffAtUs = 0;

static bool     g_wasConnected = false;  // keyboard hot-plug edge tracking
static bool     g_hotplugArmed = false;  // skip the first loop's false edge

// NFR-1 / NFR-2 instrumentation: Core 0 loop-processing time (an upper bound on
// key-to-MIDI latency), per-event key-to-MIDI latency, and the Core 1 clock
// tick jitter (read back via the rhythm engine). Summarized over USB-CDC every
// kPerfLogIntervalUs.
static PerfStats g_latencyStats;      // Core 0 loop-processing time
static PerfStats g_keyLatencyStats;   // HID report receipt -> MIDI dispatch
static PerfStats g_rhythmDispatchStats;  // Core 1 enqueue -> MIDI dispatch
static PerfStats g_realtimeGapStats;     // gap between priority MIDI services
static uint32_t  g_rhythmQueueOverflow = 0;
static size_t    g_rhythmQueueMaxDepth = 0;
static uint64_t  g_lastRealtimeServiceUs = 0;
static uint64_t  g_lastDisplayUpdateUs = 0;
static uint64_t  g_lastPerfLogUs = 0;
static constexpr uint64_t kPerfLogIntervalUs = 5000000ULL;  // 5 s
static constexpr uint64_t kRealtimeStallUs = 8000ULL;       // 8 ms
static constexpr uint64_t kDisplayMinIntervalUs = 30000ULL; // ~33 Hz
static constexpr uint64_t kDisplayGuardUs = 12000ULL;       // before next step

// Grace period after the host ejects the MSC drive. This lets the SCSI command
// complete and the host finish its removal UI before the firmware reboots.
static uint64_t g_ejectRebootAtUs = 0;
static constexpr uint64_t kEjectRebootDelayUs = 1000000ULL;  // 1 s

// Sets every target LED on/off; returns true if all SET_REPORTs were queued.
static bool applyLedState(bool on) {
    bool allOk = true;
    if (g_state.config.led_indicator == LedTarget::All) {
        static const uint8_t kAllLeds[] = {
            midi::LED_NUM_LOCK, midi::LED_CAPS_LOCK, midi::LED_SCROLL_LOCK,
        };
        for (uint8_t led : kAllLeds) {
            bool ok = g_adapters.input->setLed(led, on);
            logLed(led, on, ok);
            if (!ok) allOk = false;
        }
    } else {
        uint8_t led = ledUsageFor(g_state.config);
        bool ok = g_adapters.input->setLed(led, on);
        logLed(led, on, ok);
        allOk = ok;
    }
    return allOk;
}

// Highest-priority Core 0 service: drain Core 1 rhythm/clock output and send it
// before any UI work. A large gap means Core 0 was blocked (LCD, flash, USB
// logging): drop the stale backlog and rebase the scheduler so it resumes on
// the current grid instead of emitting a late burst.
static void serviceRealtimeMidi() {
    uint64_t now = nowUs();
    if (g_lastRealtimeServiceUs != 0) {
        uint64_t gap = now - g_lastRealtimeServiceUs;
        g_realtimeGapStats.record(static_cast<uint32_t>(
            gap > 0xFFFFFFFFULL ? 0xFFFFFFFFULL : gap));
        if (gap > kRealtimeStallUs) {
            g_rhythmQueue.clear();
            if (g_rhythmEngine) g_rhythmEngine->requestRebase();
        }
    }
    g_lastRealtimeServiceUs = now;

    size_t depth = g_rhythmQueue.size();
    if (depth > g_rhythmQueueMaxDepth) g_rhythmQueueMaxDepth = depth;

    bool sent = false;
    QueuedMidi queued;
    while (g_rhythmQueue.pop(queued)) {
        if (queued.queued_us != 0) {
            uint64_t latency = now - queued.queued_us;
            g_rhythmDispatchStats.record(static_cast<uint32_t>(
                latency > 0xFFFFFFFFULL ? 0xFFFFFFFFULL : latency));
        }
        if (g_router) g_router->sendRaw(queued.msg);
        sent = true;
    }
    if (sent && g_router) g_router->flush();
    g_rhythmQueueOverflow += g_rhythmQueue.takeOverflowCount();
}

// Keep LCD I2C work away from due rhythm/playback output.
static bool displayUpdateAllowed(uint64_t now) {
    if (now - g_lastDisplayUpdateUs < kDisplayMinIntervalUs) return false;
    if (!g_rhythmQueue.empty()) return false;
    uint64_t nextStep = g_state.rhythmClock.nextStepUs.load();
    if (nextStep > now && nextStep - now < kDisplayGuardUs) return false;
    return true;
}

// Esc (main menu) and keyboard hot-plug disconnect: release chord + strum +
// bass notes only — the rhythm and beat LED are left untouched.
static void cancelChordStrum() {
    if (g_chordEngine) g_chordEngine->allNotesOff();
    if (g_strumEngine) g_strumEngine->allNotesOff();
    if (g_bassEngine)  g_bassEngine->allNotesOff();
    // A cancelled chord must not leave the free-running bass playing the old
    // root (the rhythm may still be stopped). The next chord press re-selects.
    g_state.selectedChordValid = false;
    g_state.allNotesOff();
}

// Panic (FR-C11): cancel chord/strum, disable the rhythm (it stays off until
// F7), flood All-Sound-Off + All-Notes-Off on all 16 channels, cancel any
// transient UI, and force the beat LED off for the current pulse (it resumes on
// the next beat — the master clock keeps running).
static void handlePanic() {
    if (g_sequencer) g_sequencer->stopAll(true);
    if (g_patternEditor) g_patternEditor->stopAll(nowUs());
    cancelChordStrum();
    g_state.pendingRhythm.enabled = false;   // drums stop and stay stopped
    if (g_router) g_router->panic();         // CC120 + CC123 on all 16 channels

    if (g_display) g_display->cancel();
    g_state.cursorActive = false;
    g_state.editMenu = EditMenu::None;
    g_state.editParam = 0;

    g_ledOn = false;
    g_ledDirty = true;
    logInfo("Panic: all-sound-off + all-notes-off (16ch)");
}

// Boot-time key gesture (polled for a short window before the main loop):
//   - Esc held  -> enter the USB bootloader (BOOTSEL) so the Pico can be
//                  reflashed over USB without opening the enclosure.
//   - Ctrl held -> present the FatFS Mass Storage drive on the native USB port
//                  so config.json/presets/rhythms can be drag-drop edited (M9/M10).
// Bootloader wins if both are held (flashing supersedes file editing).
enum class BootMode { None, Bootloader, MassStorage };

static BootMode detectBootMode() {
    constexpr uint8_t CTRL_MASK    = 0x11;  // LCtrl | RCtrl
    constexpr uint8_t HID_USAGE_ESC = 0x29;  // keyboard Escape
    constexpr uint64_t kSettleUs   = 300000ULL;  // grace after first report
    constexpr uint64_t kControllerWaitUs = 3000000ULL;
    constexpr uint64_t kReportWaitUs = 4000000ULL;
    uint64_t controllerDeadline = nowUs() + kControllerWaitUs;
    uint64_t reportDeadline = 0;
    uint64_t settleDeadline = 0;
    bool controllerReady = false;
    bool reportSeen = false;

    while (true) {
        uint64_t t = nowUs();
        if (!controllerReady && g_adapters.input->controllerReady()) {
            controllerReady = true;
            reportDeadline = t + kReportWaitUs;
        }
        if (!controllerReady && t >= controllerDeadline) break;

        auto events = g_adapters.input->poll();
        for (const auto& ev : events) {
            if (!ev.pressed) continue;
            if (ev.hid_usage == HID_USAGE_ESC) {
                return BootMode::Bootloader;
            }
            if (ev.modifiers & CTRL_MASK) {
                return BootMode::MassStorage;
            }
        }
        // A keyboard may report its modifiers before the key array, so a held
        // Esc can arrive in a report right after the first one. Wait for the
        // first report, then keep scanning for a short settle grace before
        // concluding no boot key was held.
        if (!controllerReady && g_adapters.input->controllerReady()) {
            controllerReady = true;
            reportDeadline = nowUs() + kReportWaitUs;
        }
        if (g_adapters.input->reportReceived() && !reportSeen) {
            reportSeen = true;
            settleDeadline = nowUs() + kSettleUs;
        }
        if (reportSeen && nowUs() >= settleDeadline) break;
        if (controllerReady && !reportSeen && nowUs() >= reportDeadline) break;
        delay(10);
    }
    return BootMode::None;
}

// Reboot into the ROM USB bootloader (BOOTSEL). Core 1 is stopped first: its
// loop1() services TinyUSB and feeds the watchdog, and either can race with the
// bootrom's reset of the USB controller / watchdog (leaving the chip hung with
// the drive never appearing). The native USB is then dropped so the host sees a
// clean detach before the bootrom re-enumerates as RPI-RP2. The on-board LED
// (GPIO 25) is used as the bootloader activity light so entering BOOTSEL is
// visible even before the drive mounts.
static void enterBootloader() {
#if defined(ARDUINO_ARCH_RP2040)
    multicore_reset_core1();
    tud_disconnect();
    busy_wait_ms(50);
    reset_usb_boot(1u << LED_BUILTIN, 0);
    while (true) {}  // reset_usb_boot() is noreturn
#endif
}

// Warm-reboot after an MSC eject so setup() reloads config/presets from the
// files the host just wrote. Core 1 must be stopped first: loop1() feeds the
// watchdog, which would otherwise keep the chip from resetting.
static void rebootForReload() {
#if defined(ARDUINO_ARCH_RP2040)
    logInfo("MSC: rebooting to reload configuration");
    multicore_reset_core1();
    tud_disconnect();
    busy_wait_ms(20);
    rp2040.reboot();
    while (true) {}  // rp2040.reboot() does not return
#endif
}

void setup() {
    logInit();

    g_adapters = createAdapters();

    auto& storage = *g_adapters.storage;
    g_state.config = AppConfig::load(storage);

    // v0.2.0 reduces the preset count from 10 banks to 5. Reclaim the legacy
    // bank/sequence files before loading anything (users should back them up
    // first; see the release notes).
    int legacyRemoved = migrateLegacyPresetBanks(storage);
    if (legacyRemoved > 0) {
        logWarn("Removed legacy preset/sequence files (5-bank v0.2 layout)");
    }
    storage.mkdir("/sequences");

    // Load rhythm + bass patterns first so their names are available to keymap
    // validation (set/toggle actions may reference a pattern by name).
    RhythmLibrary rlib = loadRhythmPatterns(storage);
    installRhythmNames(rlib.names);
    installRhythmShortNames(rlib.short_names);
    BassLibrary blib = loadBassPatterns(storage);
    installBassNames(blib.names);
    ChordPatternLibrary cplib = loadChordPatterns(storage);
    installChordPatternNames(cplib.names);

    // Load the configurable keymap; on validation failure, write an error log,
    // show a persistent LCD message, and refuse to process input (halt).
    {
        KeymapLoadResult kmr = KeymapConfig::load(storage);
        g_state.keymap = kmr.config;
        if (!kmr.ok) {
            g_keymapError = true;
            std::string log;
            for (const auto& e : kmr.errors) {
                log += e;
                log += "\n";
            }
            storage.writeFile("/keymap_error.log", log);
            logError("Invalid keymap.json (see /keymap_error.log)");
        }
    }

    // Apply the run-time logging toggles (NFR-8) from config before anything logs.
    g_debugLogEnabled = g_state.config.debug_log_enabled;
    g_midiMonitorEnabled = g_state.config.midi_monitor_enabled;

    g_router = new MidiRouter(*g_adapters.midiOut, g_state);
    g_router->setUsbOut(g_adapters.usbMidiOut.get());
    g_chordEngine = new ChordEngine(g_state, *g_router);
    g_chordEngine->setPatterns(std::move(cplib.patterns));
    g_strumEngine = new StrumEngine(g_state, *g_router);
    g_bassEngine  = new BassEngine(g_state, *g_router);
    g_bassEngine->setChordEngine(g_chordEngine);
    g_bassEngine->setPatterns(std::move(blib.patterns));
    g_rhythmEngine = new RhythmEngine(g_state, g_rhythmQueue);
    g_rhythmEngine->setPatterns(std::move(rlib.patterns));

    g_display = new DisplayManager(g_state, *g_adapters.lcd);
    g_display->update(nowUs());

    g_editEngine = new EditEngine(g_state, *g_display);
    g_strumEngine->setMacroTrigger([](uint8_t index, uint64_t now_us) {
        if (g_editEngine) g_editEngine->triggerMacro(index, now_us);
    });
    g_editEngine->setModeChangedCallback([]() { g_chordEngine->onModeChanged(); });
    g_editEngine->setArpModeChangedCallback([]() { g_chordEngine->onArpModeChanged(); });
    g_editEngine->setPatternChangedCallback([]() { g_rhythmEngine->onPatternChanged(); });
    g_editEngine->setVoicingChangedCallback([]() { g_chordEngine->onVoicingChanged(); });
    g_editEngine->setPatternProvider(
        [](int idx) -> const RhythmPattern* { return g_rhythmEngine->patternAt(idx); });
    g_editEngine->setMidiSendCallback([](const std::vector<uint8_t>& bytes) {
        if (g_router) g_router->sendBytes(bytes.data(), bytes.size());
    });
    g_editEngine->setClockResyncCallback([]() {
        if (g_rhythmEngine) g_rhythmEngine->resyncClock();
    });
    g_editEngine->setDrumAuditionCallback([](uint8_t note) {
        uint8_t ch = g_state.pendingRhythm.channel;
        g_router->noteOn(ch, note, 100);
        g_auditionNote = note;
        g_auditionChannel = ch;
        g_auditionOffAtUs = nowUs() + 120000ULL;  // 120 ms audition
    });

    g_presetEngine = new PresetEngine(g_state, *g_adapters.storage, *g_display);
    g_presetEngine->setModeChangedCallback([]() { g_chordEngine->onModeChanged(); });
    g_editEngine->setAnyEditCallback([]() { g_presetEngine->recomputeDirty(); });

    g_patternEditor = new PatternEditorEngine(
        g_state, *g_adapters.storage, *g_display, *g_router,
        *g_rhythmEngine, *g_bassEngine, *g_chordEngine);
    g_patternEditor->setModifiedCallback([]() {
        if (g_presetEngine) g_presetEngine->recomputeDirty();
    });
    g_patternEditor->setWriteAllowedCallback([]() {
        return !(g_msc && g_msc->driveEnabled());
    });
    g_editEngine->setPatternEditCallback([](EditMenu menu) {
        if (g_msc && g_msc->driveEnabled()) {
            if (g_display) {
                g_display->showValue("USB drive active", "Pattern edit off",
                                     false, nowUs());
            }
            return;
        }
        if (g_sequencer) g_sequencer->stopAll(true);
        if (g_patternEditor) g_patternEditor->open(menu, nowUs());
    });

    g_sequencer = new SequencerEngine(g_state, *g_adapters.storage,
                                      *g_chordEngine, *g_display);
    g_chordEngine->setChordTriggeredCallback(
        [](const ResolvedChord& chord, uint64_t now_us) {
            if (g_sequencer) g_sequencer->onLiveChordTriggered(chord, now_us);
        });
    g_presetEngine->setPresetChangedCallback([](int bank, int slot) {
        if (g_sequencer) g_sequencer->loadForPreset(bank, slot);
    });
    g_presetEngine->setPresetClearedCallback([](int bank, int slot) {
        if (g_sequencer) g_sequencer->onPresetCleared(bank, slot);
    });

    g_presetEngine->loadStartupPreset();
    g_sequencer->loadForPreset(g_state.currentBank, g_state.currentSlot);
    g_display->update(nowUs());

#ifdef KEYBCHORD_TEST_HOOK
    g_testHook = new TestHook(g_state, *g_router, g_chordEngine, g_strumEngine);
#endif

    if (g_keymapError) {
        g_display->showError("Keymap error", "Remount to fix");
        g_display->update(nowUs());
    }

    logInfo("KeybChord Pico ready");

    // Boot-key gesture: Esc enters the USB bootloader (reflash without opening
    // the enclosure); Ctrl also presents the FatFS Mass Storage drive on the
    // native USB port (the serial debug log stays available).
    switch (detectBootMode()) {
    case BootMode::Bootloader:
        logInfo("Esc boot key: entering USB bootloader");
        if (g_display) {
            g_display->showError("Entering", "bootloader...");
            g_display->update(nowUs());
        }
        delay(50);
        enterBootloader();
        break;

    case BootMode::MassStorage:
        g_msc = new MscFatFs();
        if (g_msc->begin()) {
            g_msc->setDriveEnabled(true);
#if defined(ARDUINO_ARCH_RP2040)
            // The MSC interface was added after the host enumerated the CDC-only
            // device: re-enumerate so the composite descriptor is picked up.
            tud_disconnect();
            delay(20);
            tud_connect();
#endif
        } else {
            delete g_msc;
            g_msc = nullptr;
        }
        break;

    case BootMode::None:
    default:
        break;
    }

    // NFR-5: enable the hardware watchdog to recover from a wedged USB stack.
    // Fed on both cores; a 1 s timeout is generous enough for boot/littlefs.
#if defined(ARDUINO_ARCH_RP2040)
    rp2040.wdt_begin(1000);
#endif
}

void loop() {
    if (!g_adapters.input) return;

    uint64_t loop_start_us = nowUs();
    serviceRealtimeMidi();
    uint64_t now_us = nowUs();

    // MSC eject: the host has finished writing/removing the drive. Reboot after
    // a short grace period so setup() reloads the edited files. Keep this before
    // the keymap-error return so ejecting can recover a bad keymap too.
    if (g_msc) {
        if (g_msc->takeEjectRequest()) {
            g_ejectRebootAtUs = now_us + kEjectRebootDelayUs;
            logInfo("MSC: eject detected; reloading configuration");
            if (g_display) {
                g_display->showValue("USB ejected", "Rebooting...", false, now_us);
                g_display->update(now_us);
            }
        }
        if (g_ejectRebootAtUs != 0 && now_us >= g_ejectRebootAtUs) {
            rebootForReload();
        }
    }

#ifdef KEYBCHORD_TEST_HOOK
    if (g_testHook) g_testHook->poll(now_us);
#endif

    // Halt when the keymap failed validation: keep the error screen up and do
    // not process any input until the file is fixed and the device rebooted.
    if (g_keymapError) {
        if (g_display) g_display->update(now_us);
        serviceRealtimeMidi();
        delay(1);
#if defined(ARDUINO_ARCH_RP2040)
        rp2040.wdt_reset();
#endif
        return;
    }

    // NFR-5 hot-plug: detect a keyboard disconnect and release any stuck notes.
    // Prevents the beat-LED SET_REPORT retry from spinning while unmounted.
    bool inputConnected = g_adapters.input->connected();
    if (g_hotplugArmed) {
        if (!inputConnected && g_wasConnected) {
            logWarn("Keyboard disconnected: releasing notes");
            if (g_sequencer) g_sequencer->stopAll(true);
            if (g_patternEditor) g_patternEditor->stopAll(now_us);
            cancelChordStrum();
            g_ledDirty = false;
        } else if (inputConnected && !g_wasConnected) {
            logInfo("Keyboard reconnected");
        }
    }
    g_hotplugArmed = true;
    g_wasConnected = inputConnected;

    // Playback runs before key/UI dispatch so a menu operation cannot delay
    // sequence/bass/pattern output that is already due.
    g_sequencer->update(nowUs());
    g_chordEngine->update(nowUs());
    g_strumEngine->update(nowUs());
    g_bassEngine->update(nowUs());
    if (g_patternEditor) g_patternEditor->update(nowUs());
    serviceRealtimeMidi();

    auto events = g_adapters.input->poll();
    for (const auto& ev : events) {
        serviceRealtimeMidi();
        logKeyEvent(ev.hid_usage, ev.pressed, ev.modifiers, ev.usage_page);

        if (ev.pressed) {
            // Any new key dismisses the persistent firmware-info screen. The
            // key itself is still processed normally below.
            if (g_display && g_display->infoVisible()) {
                g_display->cancel();
            }
            KeyCmd t = g_keymap.resolve(ev.hid_usage, ev.modifiers, ev.usage_page).cmd;
            // Ctrl+Esc: hard-coded debug screen (firmware version + git hash).
            if (t == KeyCmd::FirmwareInfo) {
                if (g_display) {
                    std::string hash = keybchord::kGitHash;
                    if (hash.size() > 8) hash.resize(8);
                    g_display->showInfo(
                        std::string("KC FW ver. ") + keybchord::kFirmwareVersion,
                        hash);
                    g_display->update(now_us);
                }
                logInfo("Firmware info shown");
                continue;
            }
            // Super+Esc: full panic, works from any state (prompt, cursor, menu).
            if (t == KeyCmd::Panic) {
                handlePanic();
                continue;
            }
            // Esc (no super) in the plain main menu cancels chord+strum sounds;
            // in an edit menu / cursor / prompt it keeps its existing meaning
            // (exit menu, exit cursor, cancel prompt) via the engines below.
            if (t == KeyCmd::ClearEdit &&
                g_state.editMenu == EditMenu::None &&
                !g_state.cursorActive &&
                !(g_patternEditor && g_patternEditor->active()) &&
                !g_presetEngine->promptActive() &&
                !g_presetEngine->nameEditing()) {
                cancelChordStrum();
                logInfo("Esc: chord/strum cancelled");
                continue;
            }
            // Backspace from the main screen resets the voice-leading memory so
            // the next chord returns to its root-position voicing at the
            // configured octave. A held/sounding chord is left untouched.
            if (ev.hid_usage == 0x2A /* Backspace */ &&
                g_state.editMenu == EditMenu::None &&
                !g_state.cursorActive &&
                !(g_patternEditor && g_patternEditor->active()) &&
                !g_presetEngine->promptActive() &&
                !g_presetEngine->nameEditing()) {
                g_chordEngine->resetVoicing();
                if (g_display) {
                    g_display->showValue("Voicing Reset", "", false, now_us);
                }
                logInfo("Voicing reset");
                continue;
            }
            // While the Mass Storage drive is presented the host owns the
            // filesystem: suppress preset save/clear to avoid FAT corruption.
            if (g_msc && g_msc->driveEnabled() &&
                !(g_patternEditor && g_patternEditor->active()) &&
                (t == KeyCmd::PresetSave || t == KeyCmd::PresetClear)) {
                logWarn("Preset save/clear disabled while MSC drive is active");
                if (g_display) {
                    g_display->showValue("USB drive active", "Save/Clear off",
                                         false, now_us);
                }
                continue;
            }
        }

        // M17 pattern editor owns the keyboard while open. Chord-grid keys
        // fall through to the chord engine so the instrument stays playable.
        if (g_patternEditor && g_patternEditor->active()) {
            if (g_patternEditor->handleKeyEvent(ev, now_us)) {
                continue;
            }
            // Chord keys and direct parameter actions are forwarded while the
            // editor is open. EditEngine handles parameter actions; chord keys
            // fall through to the chord engine. Strum is intentionally skipped.
            if (g_editEngine->handleKeyEvent(ev, now_us)) {
                continue;
            }
            g_chordEngine->handleKeyEvent(ev, now_us);
            continue;
        }

        // M14 sequence controls are global performance shortcuts. They are
        // suppressed while a preset prompt/name edit owns the keyboard, but a
        // Ctrl+number key-up must always release a strum that was started
        // before Ctrl was pressed.
        KeyAction sa = g_keymap.resolve(ev.hid_usage, ev.modifiers,
                                        ev.usage_page);
        if (!ev.pressed && sa.cmd == KeyCmd::SequenceSelect) {
            g_strumEngine->releaseUsage(ev.hid_usage, now_us);
        }
        if (ev.pressed && g_msc && g_msc->driveEnabled() &&
            (sa.cmd == KeyCmd::SequenceRecord ||
             sa.cmd == KeyCmd::SequenceClear ||
             (sa.cmd == KeyCmd::OpenMenu &&
              sa.menu == EditMenu::Sequence))) {
            logWarn("Sequencer write disabled while MSC drive is active");
            if (g_display) {
                g_display->showValue("USB drive active", "Seq write off",
                                     false, now_us);
            }
            continue;
        }
        if (g_sequencer && !g_presetEngine->nameEditing() &&
            !g_presetEngine->promptActive()) {
            if (g_sequencer->handleKeyEvent(ev, now_us)) {
                continue;
            }
        }

        bool consumed = g_presetEngine->handleKeyEvent(ev, now_us);
        if (!consumed) {
            consumed = g_editEngine->handleKeyEvent(ev, now_us);
        }
        if (!consumed) {
            g_chordEngine->handleKeyEvent(ev, now_us);
            g_strumEngine->handleKeyEvent(ev, now_us);
        }

        // NFR-1: per-event latency from HID report receipt to dispatch (events
        // from the null adapter or tests carry received_us == 0 and are skipped).
        if (ev.received_us != 0) {
            uint64_t dispatch_us = nowUs();
            g_keyLatencyStats.record(
                static_cast<uint32_t>(dispatch_us - ev.received_us));
        }
    }

    now_us = nowUs();

    // Beat LED (FR-R8): Core 1 posts a flash request; Core 0 owns the on/off
    // state — deterministic off after led_flash_ms, retried until the report
    // is queued so a dropped SET_REPORT can't leave the LED stuck on.
    if (g_state.ledIndicator.flash) {
        g_state.ledIndicator.flash = false;
        g_ledOn = true;
        g_ledOffAtUs = now_us + static_cast<uint64_t>(g_state.config.led_flash_ms) * 1000ULL;
        g_ledDirty = true;
    }
    if (g_ledOn && now_us >= g_ledOffAtUs) {
        g_ledOn = false;
        g_ledDirty = true;
    }
    if (g_ledDirty && inputConnected) {
        if (applyLedState(g_ledOn)) {
            g_ledDirty = false;   // retry on the next loop if not queued
        }
    }
    serviceRealtimeMidi();

    // UI-only engines and display are lower priority than playback.
    g_presetEngine->update(now_us);
    g_editEngine->update(now_us);

    // Drum audition note-off (one-shot).
    if (g_auditionNote != 0xFF && nowUs() >= g_auditionOffAtUs) {
        g_router->noteOff(g_auditionChannel, g_auditionNote);
        g_auditionNote = 0xFF;
    }

    serviceRealtimeMidi();

    // Render the LCD only when it will not sit in front of due playback data.
    uint64_t display_now = nowUs();
    if (g_display && displayUpdateAllowed(display_now)) {
        g_display->update(display_now);
        g_lastDisplayUpdateUs = display_now;
    }
    serviceRealtimeMidi();

    // NFR-1/NFR-2 instrumentation: summarize Core 0 loop time, per-event
    // key-to-MIDI latency, rhythm dispatch latency, and Core 1 clock jitter.
    uint64_t end_us = nowUs();
    g_latencyStats.record(static_cast<uint32_t>(end_us - loop_start_us));
    if (end_us - g_lastPerfLogUs >= kPerfLogIntervalUs) {
        g_lastPerfLogUs = end_us;
        logPerf("core0-loop-us", g_latencyStats.count(), g_latencyStats.minUs(),
                g_latencyStats.maxUs(), g_latencyStats.avgUs());
        g_latencyStats.reset();

        logPerf("key-to-midi-us", g_keyLatencyStats.count(),
                g_keyLatencyStats.minUs(), g_keyLatencyStats.maxUs(),
                g_keyLatencyStats.avgUs());
        g_keyLatencyStats.reset();

        logPerf("rhythm-dispatch-us", g_rhythmDispatchStats.count(),
                g_rhythmDispatchStats.minUs(), g_rhythmDispatchStats.maxUs(),
                g_rhythmDispatchStats.avgUs());
        g_rhythmDispatchStats.reset();

        logPerf("realtime-gap-us", g_realtimeGapStats.count(),
                g_realtimeGapStats.minUs(), g_realtimeGapStats.maxUs(),
                g_realtimeGapStats.avgUs());
        g_realtimeGapStats.reset();

        size_t depth = g_rhythmQueue.size();
        logPerf("rhythm-queue", g_rhythmQueueOverflow, 0,
                static_cast<uint32_t>(g_rhythmQueueMaxDepth),
                static_cast<uint32_t>(depth));
        g_rhythmQueueOverflow = 0;
        g_rhythmQueueMaxDepth = 0;

        PerfStats jitter;
        if (g_rhythmEngine) g_rhythmEngine->jitterStats(jitter, true);
        logPerf("clock-jitter-us", jitter.count(), jitter.minUs(),
                jitter.maxUs(), jitter.avgUs());
    }

    delay(1);
#if defined(ARDUINO_ARCH_RP2040)
    rp2040.wdt_reset();
#endif
}

#if defined(ARDUINO_ARCH_RP2040)
void setup1() {
}

void loop1() {
    // Core 1: rhythm scheduler/clock (deadline-driven; injectable time).
    if (g_rhythmEngine) {
        g_rhythmEngine->update(nowUs());
    }
    delay(1);
    rp2040.wdt_reset();
}
#endif
