t-bowzer/KCPico/firmware/ch559/config.h

//add your personal defines here 

// UART bridge to the RP2040. The protocol is emitted on UART1 (RXD1/TXD1 =
// P2.6/P2.7) and must match the RP2040's Serial1 baud exactly.
#define CH559_UART_BAUD 115200
