t-bowzer/KCPico/keybchord/test/test_bass_engine.cpp

#include <gtest/gtest.h>

#include <vector>

#include "bass.h"
#include "bass_engine.h"
#include "chord_engine.h"
#include "midi_router.h"
#include "recording_midi_out.h"
#include "rhythm.h"
#include "state.h"
#include "storage_stub.h"


class BassEngineTest : public ::testing::Test {
protected:
    void SetUp() override {
        midi_.begin();
        state_.loadDefaults();
        router_ = new MidiRouter(midi_, state_);
        bass_   = new BassEngine(state_, *router_);

        // Load the built-in bass patterns (self-provisioned from templates).
        BassLibrary lib = loadBassPatterns(storage_);
        installBassNames(lib.names);
        bass_->setPatterns(std::move(lib.patterns));

        // Select C major and enable the walking bass on channel 3, octave -1.
        ResolvedChord c{0, ChordType::Major};
        state_.selectedChord = c;
        state_.selectedChordValid = true;
        state_.pendingBass.enabled = true;
        state_.pendingBass.channel = 3;
        state_.pendingBass.octave  = -1;
        state_.pendingBass.note_duration_ms = 150;
        state_.pendingBass.velocity = 90;
        state_.pendingChord.play_mode = PlayMode::Held;
    }

    void TearDown() override {
        clearBassNames();
        delete bass_;
        delete router_;
    }

    int lastNoteOn(uint8_t channel) const {
        int note = -1;
        for (const auto& m : midi_.messages()) {
            if ((m.status & 0xF0) == midi::STATUS_NOTE_ON && m.data2 > 0
                && (m.status & 0x0F) == (channel - 1)) {
                note = m.data1;
            }
        }
        return note;
    }

    int noteOffCount(uint8_t channel) const {
        int n = 0;
        for (const auto& m : midi_.messages()) {
            if ((m.status & 0xF0) == midi::STATUS_NOTE_OFF
                && (m.status & 0x0F) == (channel - 1)) n++;
        }
        return n;
    }

    RecordingMidiOutAdapter midi_;
    StateManager state_;
    StorageStub storage_;
    MidiRouter* router_ = nullptr;
    BassEngine* bass_ = nullptr;
};


// Walking bass cycles root-3rd-5th-6th on the four beats of a 4/4 bar. The
// engine fires on each 16th-note step edge.
TEST_F(BassEngineTest, WalksFourBeatCycle) {
    state_.rhythmClock.running = true;
    state_.rhythmClock.stepsPerBar = 16;
    state_.rhythmClock.stepAbs = 1;   // step 0 just fired -> root C3 = 48
    bass_->update(0);
    EXPECT_EQ(lastNoteOn(3), 48);

    state_.rhythmClock.stepAbs = 5;   // step 4 -> 3rd = 52
    bass_->update(0);
    EXPECT_EQ(lastNoteOn(3), 52);

    state_.rhythmClock.stepAbs = 9;   // step 8 -> 5th = 55
    bass_->update(0);
    EXPECT_EQ(lastNoteOn(3), 55);

    state_.rhythmClock.stepAbs = 13;  // step 12 -> 6th = 57
    bass_->update(0);
    EXPECT_EQ(lastNoteOn(3), 57);
}

// A 3/4 waltz rhythm chops the bass bar to 12 steps: root-3rd-5th, then wrap.
TEST_F(BassEngineTest, WaltzChopsToThreeBeats) {
    state_.rhythmClock.running = true;
    state_.rhythmClock.stepsPerBar = 12;
    state_.rhythmClock.stepAbs = 1;   // step 0 -> root
    bass_->update(0);
    EXPECT_EQ(lastNoteOn(3), 48);

    state_.rhythmClock.stepAbs = 5;   // step 4 -> 3rd
    bass_->update(0);
    EXPECT_EQ(lastNoteOn(3), 52);

    state_.rhythmClock.stepAbs = 9;   // step 8 -> 5th
    bass_->update(0);
    EXPECT_EQ(lastNoteOn(3), 55);

    state_.rhythmClock.stepAbs = 13;  // step 12 wraps to step 0 -> root again
    bass_->update(0);
    EXPECT_EQ(lastNoteOn(3), 48);
}

// Bass free-runs at the preset tempo when the rhythm is stopped, so the bass is
// audible without drums. The first step starts one 16th after entering the
// stopped state to avoid an extra note right at a running->stopped transition.
TEST_F(BassEngineTest, FreeRunsWhenRhythmStopped) {
    state_.rhythmClock.running = false;
    const uint64_t step = stepUs(state_.pendingRhythm.tempo);

    bass_->update(0);
    EXPECT_EQ(lastNoteOn(3), -1);

    bass_->update(step);                 // step 0 -> root
    EXPECT_EQ(lastNoteOn(3), 48);

    uint64_t now = step;
    for (int i = 0; i < 4; i++) {        // steps 1..4 -> beat 2 third
        now += step;
        bass_->update(now);
    }
    EXPECT_EQ(lastNoteOn(3), 52);
}

// Starting the rhythm resyncs to the shared step counter without replaying the
// free-run position or double-triggering.
TEST_F(BassEngineTest, RhythmStartResyncsFreeRun) {
    state_.rhythmClock.running = false;
    const uint64_t step = stepUs(state_.pendingRhythm.tempo);
    bass_->update(step);                 // free-run root

    midi_.clear();
    state_.rhythmClock.running = true;
    state_.rhythmClock.stepsPerBar = 16;
    state_.rhythmClock.stepAbs = 5;      // already mid-bar; resync only
    bass_->update(step + 1);
    EXPECT_EQ(lastNoteOn(3), -1);

    state_.rhythmClock.stepAbs = 9;      // step 8 -> fifth
    bass_->update(step + 2);
    EXPECT_EQ(lastNoteOn(3), 55);
}

TEST_F(BassEngineTest, FreeRunStopsWhenDisabled) {
    state_.rhythmClock.running = false;
    state_.pendingBass.enabled = false;
    const uint64_t step = stepUs(state_.pendingRhythm.tempo);

    bass_->update(step);
    EXPECT_EQ(lastNoteOn(3), -1);
}

// Bass is silent when disabled (FR-B1).
TEST_F(BassEngineTest, SilentWhenDisabled) {
    state_.pendingBass.enabled = false;
    state_.rhythmClock.running = true;
    bass_->update(0);
    EXPECT_EQ(lastNoteOn(3), -1);
}

// Bass is silent in Silent chord mode (FR-B1).
TEST_F(BassEngineTest, SilentInSilentChordMode) {
    state_.pendingChord.play_mode = PlayMode::Silent;
    state_.rhythmClock.running = true;
    state_.rhythmClock.stepAbs = 1;
    bass_->update(0);
    EXPECT_EQ(lastNoteOn(3), -1);
}

// Percussive note-off after note_duration_ms.
TEST_F(BassEngineTest, NoteOffAfterDuration) {
    state_.rhythmClock.running = true;
    state_.rhythmClock.stepAbs = 1;
    bass_->update(0);
    EXPECT_EQ(noteOffCount(3), 0);

    bass_->update(150000);   // 150 ms later
    EXPECT_EQ(noteOffCount(3), 1);
}

// A new step releases the previous note (monophonic walking line).
TEST_F(BassEngineTest, NewBeatReleasesPrevious) {
    state_.rhythmClock.running = true;
    state_.rhythmClock.stepAbs = 1;
    bass_->update(0);

    // Fire step 4 before the previous note's duration elapses.
    state_.rhythmClock.stepAbs = 5;
    bass_->update(1000);
    EXPECT_EQ(noteOffCount(3), 1);   // previous released
    EXPECT_EQ(lastNoteOn(3), 52);
}

// Configurable pattern: Quarter plays the root on every beat.
TEST_F(BassEngineTest, QuarterPatternPlaysRootOnEachBeat) {
    state_.pendingBass.pattern = bassIndex("Quarter");
    state_.rhythmClock.running = true;
    state_.rhythmClock.stepsPerBar = 16;

    state_.rhythmClock.stepAbs = 1;
    bass_->update(0);
    EXPECT_EQ(lastNoteOn(3), 48);   // C3 root

    state_.rhythmClock.stepAbs = 5;
    bass_->update(0);
    EXPECT_EQ(lastNoteOn(3), 48);   // root again (not the 3rd)
}

// Whole pattern sustains the root across the bar (past note_duration_ms).
TEST_F(BassEngineTest, WholePatternSustainsBar) {
    state_.pendingBass.pattern = bassIndex("Whole");
    state_.rhythmClock.running = true;
    state_.rhythmClock.stepsPerBar = 16;

    state_.rhythmClock.stepAbs = 1;
    bass_->update(0);
    EXPECT_EQ(lastNoteOn(3), 48);
    EXPECT_EQ(noteOffCount(3), 0);

    bass_->update(300000);          // past note_duration_ms (150 ms)
    EXPECT_EQ(noteOffCount(3), 0);  // still sustained (whole note)
}

// Hold pattern sustains the root only while the chord is sounding.
TEST_F(BassEngineTest, HoldPatternTracksChord) {
    state_.pendingBass.pattern = bassIndex("Hold");
    ChordEngine chord(state_, *router_);
    bass_->setChordEngine(&chord);

    chord.handleKeyEvent(KeyEvent{0x17, true, 0}, 0);  // T = C major (Held)
    chord.update(ChordEngine::PRESS_GROUP_US);
    EXPECT_TRUE(chord.isSounding());

    bass_->update(0);
    EXPECT_EQ(lastNoteOn(3), 48);   // C3 root

    chord.allNotesOff();
    bass_->update(0);
    EXPECT_EQ(noteOffCount(3), 1);  // released with the chord
}

// A new chord re-articulates a sustained whole note immediately (mid-measure).
TEST_F(BassEngineTest, WholeNoteFollowsChordChange) {
    state_.pendingBass.pattern = bassIndex("Whole");
    state_.rhythmClock.running = true;
    state_.rhythmClock.stepsPerBar = 16;

    state_.rhythmClock.stepAbs = 1;   // beat 0 -> C3 = 48
    bass_->update(0);
    EXPECT_EQ(lastNoteOn(3), 48);

    state_.selectedChord = ResolvedChord{7, ChordType::Major};  // G major
    bass_->update(1000);              // no step edge
    EXPECT_EQ(lastNoteOn(3), 55);     // G3 follows immediately
    EXPECT_EQ(noteOffCount(3), 1);    // old root released
}

// Whole notes release slightly before the bar ends so the next note attacks
// cleanly.
TEST_F(BassEngineTest, WholeNoteReleasesEarly) {
    state_.pendingBass.pattern = bassIndex("Whole");
    state_.rhythmClock.running = true;
    state_.rhythmClock.stepsPerBar = 16;

    state_.rhythmClock.stepAbs = 1;
    bass_->update(0);
    EXPECT_EQ(lastNoteOn(3), 48);

    // stepUs(120)=125000us; whole=16 steps=2000000us; release 30ms early.
    bass_->update(1970000 - 1);
    EXPECT_EQ(noteOffCount(3), 0);

    bass_->update(1970000);
    EXPECT_EQ(noteOffCount(3), 1);
}

// Hold mode follows a new chord even when the old chord key is still held while
// the new chord key is pressed (overlapped chord switch).
TEST_F(BassEngineTest, HoldFollowsNewChordWithoutReleasing) {
    state_.pendingBass.pattern = bassIndex("Hold");
    ChordEngine chord(state_, *router_);
    bass_->setChordEngine(&chord);

    chord.handleKeyEvent(KeyEvent{0x17, true, 0}, 0);  // C major
    chord.update(ChordEngine::PRESS_GROUP_US);
    bass_->update(0);
    EXPECT_EQ(lastNoteOn(3), 48);

    chord.handleKeyEvent(KeyEvent{0x1C, true, 0}, 0);   // Y = G major (overlap)
    chord.handleKeyEvent(KeyEvent{0x17, false, 0}, 0);  // release C
    chord.update(ChordEngine::PRESS_GROUP_US);
    bass_->update(0);
    EXPECT_EQ(lastNoteOn(3), 55);     // follows the new root
    EXPECT_EQ(noteOffCount(3), 1);    // old root released
}
