t-bowzer/KCPico/keybchord/test/test_preset_engine.cpp

#include <gtest/gtest.h>

#include <string>
#include <vector>

#include "adapters_null.h"
#include "display_manager.h"
#include "edit_engine.h"
#include "preset_engine.h"
#include "presets.h"
#include "state.h"
#include "storage_stub.h"


namespace {

constexpr uint8_t HOME      = 0x4A;
constexpr uint8_t END       = 0x4D;
constexpr uint8_t INSERT    = 0x49;
constexpr uint8_t DELETE    = 0x4C;
constexpr uint8_t ENTER     = 0x28;
constexpr uint8_t ESC       = 0x29;
constexpr uint8_t BACKSPACE = 0x2A;
constexpr uint8_t SUPER     = 0x08;  // LGui

} // namespace


class PresetEngineTest : public ::testing::Test {
protected:
    void SetUp() override {
        state_.loadDefaults();
        display_ = new DisplayManager(state_, lcd_);
        engine_  = new PresetEngine(state_, storage_, *display_);
        edit_    = new EditEngine(state_, *display_);

        modeChanged_ = 0;
        engine_->setModeChangedCallback([this]() { modeChanged_++; });
        edit_->setAnyEditCallback([this]() { engine_->recomputeDirty(); });
    }

    void TearDown() override {
        delete edit_;
        delete engine_;
        delete display_;
    }

    KeyEvent key(uint16_t usage, bool pressed, uint8_t mods = 0,
                 uint8_t page = hid_usage::PAGE_KEYBOARD) {
        return {usage, pressed, mods, 0, page};
    }

    // Full Core 0 routing: preset -> edit. (Chord/strum engines are not wired
    // here; forwarded chord/strum keys simply report unconsumed.)
    bool route(const KeyEvent& ev, uint64_t now = 0) {
        bool consumed = engine_->handleKeyEvent(ev, now);
        if (!consumed) consumed = edit_->handleKeyEvent(ev, now);
        return consumed;
    }

    void setDistinctive() {
        state_.pendingChord.velocity  = 111;
        state_.pendingStrum.velocity  = 77;
        state_.pendingRhythm.tempo    = 234;
    }

    StateManager state_;
    StorageStub   storage_;
    NullLcdAdapter lcd_;
    DisplayManager* display_ = nullptr;
    PresetEngine*  engine_   = nullptr;
    EditEngine*    edit_     = nullptr;
    int            modeChanged_ = 0;
};


TEST_F(PresetEngineTest, HomeEntersCursorAndWraps) {
    EXPECT_FALSE(state_.cursorActive);

    route(key(HOME, true));
    EXPECT_TRUE(state_.cursorActive);
    EXPECT_EQ(state_.cursorBank, 4);   // wraps to last slot of previous bank
    EXPECT_EQ(state_.cursorSlot, 7);
    // Active slot is unchanged.
    EXPECT_EQ(state_.currentBank, 0);
    EXPECT_EQ(state_.currentSlot, 0);
}

TEST_F(PresetEngineTest, EndMovesCursorForward) {
    route(key(END, true));
    EXPECT_TRUE(state_.cursorActive);
    EXPECT_EQ(state_.cursorBank, 0);
    EXPECT_EQ(state_.cursorSlot, 1);
}

TEST_F(PresetEngineTest, SuperHomeEndMoveBank) {
    route(key(HOME, true, SUPER));
    EXPECT_TRUE(state_.cursorActive);
    EXPECT_EQ(state_.cursorBank, 4);
    EXPECT_EQ(state_.cursorSlot, 0);

    route(key(END, true, SUPER));
    EXPECT_EQ(state_.cursorBank, 0);
    EXPECT_EQ(state_.cursorSlot, 0);
}

TEST_F(PresetEngineTest, HomeLeavesEditMenu) {
    route(key(0x43, true));   // F10 -> Rhythm Edit
    EXPECT_EQ(state_.editMenu, EditMenu::Rhythm);

    route(key(HOME, true));   // Home -> cursor mode, leaves edit menu
    EXPECT_EQ(state_.editMenu, EditMenu::None);
    EXPECT_TRUE(state_.cursorActive);
}

TEST_F(PresetEngineTest, MenuToggleLeavesCursorMode) {
    route(key(HOME, true));
    EXPECT_TRUE(state_.cursorActive);

    route(key(0x43, true));   // F10 -> Rhythm Edit
    EXPECT_FALSE(state_.cursorActive);
    EXPECT_EQ(state_.editMenu, EditMenu::Rhythm);
}

TEST_F(PresetEngineTest, EscExitsCursorMode) {
    route(key(HOME, true));
    EXPECT_TRUE(state_.cursorActive);

    route(key(ESC, true));
    EXPECT_FALSE(state_.cursorActive);
    EXPECT_EQ(state_.currentBank, 0);
    EXPECT_EQ(state_.currentSlot, 0);
}

TEST_F(PresetEngineTest, CursorAutoResetsAfterTimeout) {
    route(key(HOME, true), 1000);
    EXPECT_TRUE(state_.cursorActive);

    engine_->update(1000 + 5000ULL * 1000 - 1);
    EXPECT_TRUE(state_.cursorActive);

    engine_->update(1000 + 5000ULL * 1000);
    EXPECT_FALSE(state_.cursorActive);
}

TEST_F(PresetEngineTest, ChordKeyStaysLiveInCursorMode) {
    route(key(HOME, true));
    EXPECT_TRUE(state_.cursorActive);

    // A chord key is forwarded (not consumed) and does not leave cursor mode.
    EXPECT_FALSE(route(key(0x17, true)));   // T
    EXPECT_TRUE(state_.cursorActive);
}

TEST_F(PresetEngineTest, HotkeyCancelsCursorAndForwards) {
    route(key(HOME, true));
    EXPECT_TRUE(state_.cursorActive);

    // F1 is a hotkey, not a preset/play key: browsing is cancelled and the
    // hotkey is handled normally (play-mode cycle).
    bool consumed = route(key(0x3A, true));   // F1
    EXPECT_FALSE(state_.cursorActive);
    EXPECT_TRUE(consumed);
    EXPECT_EQ(state_.pendingChord.play_mode, PlayMode::PressToPlay);
}

TEST_F(PresetEngineTest, RhythmHotkeyCancelsCursor) {
    route(key(HOME, true));
    EXPECT_TRUE(state_.cursorActive);

    route(key(0x3E, true));   // F5 -> enable rhythm
    EXPECT_FALSE(state_.cursorActive);
    EXPECT_TRUE(state_.pendingRhythm.enabled);
}

TEST_F(PresetEngineTest, EnterLoadsCursor) {
    PresetSlot p = PresetSlot::defaults();
    p.name = "Target";
    p.chord.velocity = 99;
    savePreset(storage_, 1, 2, p);   // B2:P3

    state_.cursorActive = true;
    state_.cursorBank   = 1;
    state_.cursorSlot   = 2;

    route(key(ENTER, true));
    EXPECT_FALSE(state_.cursorActive);
    EXPECT_EQ(state_.currentBank, 1);
    EXPECT_EQ(state_.currentSlot, 2);
    EXPECT_EQ(state_.pendingChord.velocity, 99);
    EXPECT_FALSE(state_.dirty);
}

TEST_F(PresetEngineTest, EnterInMainModeDoesNothing) {
    setDistinctive();
    route(key(ENTER, true));
    // Enter with no cursor and no prompt is inert.
    EXPECT_EQ(state_.pendingChord.velocity, 111);
    EXPECT_FALSE(storage_.exists("/presets/bank1.json"));
}

TEST_F(PresetEngineTest, SuperNumberLoadsSlotDirectly) {
    PresetSlot p = PresetSlot::defaults();
    p.chord.velocity = 42;
    savePreset(storage_, 0, 3, p);   // B1:P4

    route(key(0x1E + 3, true, SUPER));   // Super+4 -> load slot 3
    EXPECT_EQ(state_.currentSlot, 3);
    EXPECT_EQ(state_.pendingChord.velocity, 42);
    EXPECT_FALSE(state_.cursorActive);
}

TEST_F(PresetEngineTest, LoadFiresModeChangedWhenModeChanges) {
    PresetSlot p = PresetSlot::defaults();
    p.chord.play_mode = PlayMode::Arpeggio;
    savePreset(storage_, 0, 1, p);   // B1:P2

    state_.cursorActive = true;
    state_.cursorBank   = 0;
    state_.cursorSlot   = 1;

    route(key(ENTER, true));
    EXPECT_EQ(modeChanged_, 1);
    EXPECT_EQ(state_.pendingChord.play_mode, PlayMode::Arpeggio);
}

TEST_F(PresetEngineTest, SavePromptConfirmWritesPending) {
    setDistinctive();
    route(key(INSERT, true));   // Insert -> save prompt
    route(key(ENTER, true));           // confirm

    PresetSlot saved = loadPreset(storage_, 0, 0);
    EXPECT_EQ(saved.chord.velocity, 111);
    EXPECT_EQ(saved.strum.velocity, 77);
    EXPECT_EQ(saved.rhythm.tempo, 234);
    EXPECT_FALSE(state_.dirty);
}

TEST_F(PresetEngineTest, SavePromptBackspaceCancels) {
    setDistinctive();
    route(key(INSERT, true));
    route(key(BACKSPACE, true));   // cancel
    route(key(ENTER, true));       // no prompt active -> inert

    EXPECT_FALSE(storage_.exists("/presets/bank1.json"));
}

TEST_F(PresetEngineTest, SavePromptEscCancels) {
    setDistinctive();
    route(key(INSERT, true));
    route(key(ESC, true));   // cancel
    route(key(ENTER, true));

    EXPECT_FALSE(storage_.exists("/presets/bank1.json"));
}

TEST_F(PresetEngineTest, SavePromptAutoCancels) {
    setDistinctive();
    route(key(INSERT, true), 0);

    engine_->update(5000ULL * 1000 + 1);   // prompt auto-cancel after 5s

    route(key(ENTER, true));   // no prompt -> no save
    EXPECT_FALSE(storage_.exists("/presets/bank1.json"));
}

TEST_F(PresetEngineTest, PlayKeyCancelsPrompt) {
    setDistinctive();
    route(key(INSERT, true));   // save prompt

    EXPECT_FALSE(route(key(0x17, true)));   // chord key cancels + forwards

    route(key(ENTER, true));   // no prompt -> no save
    EXPECT_FALSE(storage_.exists("/presets/bank1.json"));
}

TEST_F(PresetEngineTest, ClearResetsLiveParamsAndWritesDefaults) {
    state_.pendingChord.velocity  = 111;
    state_.pendingStrum.velocity  = 77;
    state_.pendingRhythm.tempo    = 234;

    route(key(DELETE, true));   // Delete -> clear prompt
    route(key(ENTER, true));           // confirm

    EXPECT_EQ(state_.pendingChord.velocity, ChordParams::defaults().velocity);
    EXPECT_EQ(state_.pendingStrum.velocity, StrumParams::defaults().velocity);
    EXPECT_EQ(state_.pendingRhythm.tempo, RhythmParams::defaults().tempo);
    EXPECT_FALSE(state_.dirty);

    PresetSlot stored = loadPreset(storage_, 0, 0);
    EXPECT_TRUE(stored.sameParams(PresetSlot::defaults()));
}

TEST_F(PresetEngineTest, SeqSettingsAffectsDirtyAndPersists) {
    EXPECT_FALSE(state_.dirty);

    state_.sequencer.useRecorded = false;
    engine_->recomputeDirty();
    EXPECT_TRUE(state_.dirty);

    route(key(INSERT, true));   // save
    route(key(ENTER, true));
    EXPECT_FALSE(state_.dirty);

    PresetSlot saved = loadPreset(storage_, 0, 0);
    EXPECT_FALSE(saved.seq_use_recorded);

    route(key(ESC, true));      // leave the post-save name edit
    state_.sequencer.useRecorded = true;
    route(key(0x1E, true, SUPER));   // Super+1 -> reload slot 0
    EXPECT_FALSE(state_.sequencer.useRecorded);
}

TEST_F(PresetEngineTest, DirtyAppearsOnEditAndClearsOnSave) {
    EXPECT_FALSE(state_.dirty);

    route(key(0x3A, true));   // F1 -> chord mode PressToPlay (differs from default)
    EXPECT_EQ(state_.pendingChord.play_mode, PlayMode::PressToPlay);
    EXPECT_TRUE(state_.dirty);

    route(key(INSERT, true));   // save
    route(key(ENTER, true));
    EXPECT_FALSE(state_.dirty);
}

TEST_F(PresetEngineTest, DirtyClearsOnLoad) {
    route(key(0x3A, true));   // chord mode -> dirty
    EXPECT_TRUE(state_.dirty);

    route(key(0x1E, true, SUPER));   // Super+1 -> reload slot 0 (default)
    EXPECT_FALSE(state_.dirty);
    EXPECT_EQ(state_.pendingChord.play_mode, PlayMode::Held);
}

TEST_F(PresetEngineTest, DirtyUnaffectedByCursorMovement) {
    route(key(0x3A, true));   // dirty
    EXPECT_TRUE(state_.dirty);

    route(key(END, true));    // browse cursor
    EXPECT_TRUE(state_.dirty);

    route(key(ESC, true));    // exit cursor
    EXPECT_TRUE(state_.dirty);
}

TEST_F(PresetEngineTest, StartupPresetLoads) {
    PresetSlot p = PresetSlot::defaults();
    p.rhythm.tempo = 180;
    savePreset(storage_, 2, 5, p);   // B3:P6

    state_.config.startup_preset = "B3:P6";
    engine_->loadStartupPreset();

    EXPECT_EQ(state_.currentBank, 2);
    EXPECT_EQ(state_.currentSlot, 5);
    EXPECT_EQ(state_.pendingRhythm.tempo, 180);
    EXPECT_FALSE(state_.dirty);
}

TEST_F(PresetEngineTest, StartupPresetFallsBackToB1P1) {
    state_.config.startup_preset = "garbage";
    engine_->loadStartupPreset();

    EXPECT_EQ(state_.currentBank, 0);
    EXPECT_EQ(state_.currentSlot, 0);
}

TEST_F(PresetEngineTest, SaveThenNameEditCommitsName) {
    route(key(INSERT, true));
    route(key(ENTER, true));   // save -> enters name-edit
    EXPECT_TRUE(engine_->nameEditing());

    route(key(0x04, true));   // A -> 'a'
    route(key(0x05, true));   // B -> 'b'
    route(key(0x06, true));   // C -> 'c'
    route(key(ENTER, true));  // commit

    EXPECT_FALSE(engine_->nameEditing());
    PresetSlot saved = loadPreset(storage_, 0, 0);
    EXPECT_EQ(saved.name, "abc");
}

TEST_F(PresetEngineTest, SaveNameEditEscKeepsDefaultName) {
    route(key(INSERT, true));
    route(key(ENTER, true));   // save -> name-edit
    route(key(0x04, true));    // type 'a'
    route(key(ESC, true));     // cancel

    EXPECT_FALSE(engine_->nameEditing());
    PresetSlot saved = loadPreset(storage_, 0, 0);
    EXPECT_EQ(saved.name, "Default");
}

TEST_F(PresetEngineTest, SaveNameEditBackspaceDeletes) {
    route(key(INSERT, true));
    route(key(ENTER, true));   // save -> name-edit
    route(key(0x04, true));    // 'a'
    route(key(0x05, true));    // 'b'
    route(key(BACKSPACE, true));  // delete 'b'
    route(key(ENTER, true));   // commit

    PresetSlot saved = loadPreset(storage_, 0, 0);
    EXPECT_EQ(saved.name, "a");
}

TEST_F(PresetEngineTest, SaveNameEditTypesNumbersShiftAndSymbols) {
    route(key(INSERT, true));
    route(key(ENTER, true));   // save -> name-edit

    constexpr uint8_t SHIFT = 0x02;
    route(key(0x04, true, SHIFT));   // A -> 'A'
    route(key(0x1E, true));          // 1 -> '1'
    route(key(0x2D, true, SHIFT));   // Shift+- -> '_'
    route(key(0x2D, true));          // - -> '-'
    route(key(0x2C, true));          // Space -> ' '
    route(key(ENTER, true));         // commit

    PresetSlot saved = loadPreset(storage_, 0, 0);
    EXPECT_EQ(saved.name, "A1_- ");
}


TEST_F(PresetEngineTest, LoadCopiesMacroConfigIntoState) {
    PresetSlot stored = PresetSlot::defaults();
    stored.macros.numberKeys = NumberKeyMode::Macro;
    MacroCommand cmd;
    cmd.op = MacroOp::Set;
    cmd.param = ParamId::RhythmTempo;
    cmd.valueA = 88;
    stored.macros.keys[0].push_back(cmd);
    ASSERT_TRUE(savePreset(storage_, 0, 0, stored));

    route(key(0x1E, true, SUPER));  // Super+1 -> load slot 0

    EXPECT_EQ(state_.currentBank, 0);
    EXPECT_EQ(state_.currentSlot, 0);
    EXPECT_EQ(state_.pendingMacros.numberKeys, NumberKeyMode::Macro);
    ASSERT_EQ(state_.pendingMacros.keys[0].size(), 1u);
    EXPECT_EQ(state_.pendingMacros.keys[0][0].param, ParamId::RhythmTempo);
}

TEST_F(PresetEngineTest, OnDeviceSavePreservesMacrosAndMode) {
    PresetSlot stored = PresetSlot::defaults();
    stored.macros.numberKeys = NumberKeyMode::Macro;
    MacroCommand cmd;
    cmd.op = MacroOp::Set;
    cmd.param = ParamId::RhythmMute;
    cmd.valueA = 0;
    stored.macros.keys[3].push_back(cmd);
    ASSERT_TRUE(savePreset(storage_, 0, 0, stored));

    route(key(0x1E, true, SUPER));  // load slot 0
    state_.pendingRhythm.tempo = 140;

    route(key(INSERT, true));
    route(key(ENTER, true));
    route(key(ENTER, true));  // confirm name edit (keep default name)

    PresetSlot reloaded = loadPreset(storage_, 0, 0);
    EXPECT_EQ(reloaded.rhythm.tempo, 140);
    EXPECT_EQ(reloaded.macros.numberKeys, NumberKeyMode::Macro);
    ASSERT_EQ(reloaded.macros.keys[3].size(), 1u);
    EXPECT_EQ(reloaded.macros.keys[3][0].param, ParamId::RhythmMute);
}


TEST_F(PresetEngineTest, MuteLoadsCursorLikeEnter) {
    PresetSlot p = PresetSlot::defaults();
    p.name = "Target";
    p.chord.velocity = 88;
    savePreset(storage_, 1, 2, p);   // B2:P3

    state_.cursorActive = true;
    state_.cursorBank   = 1;
    state_.cursorSlot   = 2;

    route(key(hid_usage::CONSUMER_MUTE, true, 0,
              hid_usage::PAGE_CONSUMER));
    EXPECT_FALSE(state_.cursorActive);
    EXPECT_EQ(state_.currentBank, 1);
    EXPECT_EQ(state_.currentSlot, 2);
    EXPECT_EQ(state_.pendingChord.velocity, 88);
}

TEST_F(PresetEngineTest, MuteConfirmsSavePromptLikeEnter) {
    setDistinctive();
    route(key(INSERT, true));   // save prompt
    route(key(hid_usage::CONSUMER_MUTE, true, 0,
              hid_usage::PAGE_CONSUMER));

    PresetSlot saved = loadPreset(storage_, 0, 0);
    EXPECT_EQ(saved.chord.velocity, 111);
    EXPECT_FALSE(state_.dirty);
}

TEST_F(PresetEngineTest, MuteCommitsNameEditLikeEnter) {
    route(key(INSERT, true));
    route(key(ENTER, true));   // save -> name edit
    route(key(0x04, true));    // 'a'
    route(key(hid_usage::CONSUMER_MUTE, true, 0,
              hid_usage::PAGE_CONSUMER));

    EXPECT_FALSE(engine_->nameEditing());
    EXPECT_EQ(loadPreset(storage_, 0, 0).name, "a");
}

TEST_F(PresetEngineTest, ConsumerVolumeAndMuteRouteThroughMainAndMenu) {
    // Main screen: volume changes tempo.
    route(key(hid_usage::CONSUMER_VOLUME_UP, true, 0,
              hid_usage::PAGE_CONSUMER));
    EXPECT_EQ(state_.pendingRhythm.tempo, 121);
    route(key(hid_usage::CONSUMER_VOLUME_DOWN, true, 0,
              hid_usage::PAGE_CONSUMER));
    EXPECT_EQ(state_.pendingRhythm.tempo, 120);

    // Menu browsing: volume scrolls; Mute selects.
    route(key(0x43, true));   // F10 -> Rhythm (Tempo)
    route(key(hid_usage::CONSUMER_VOLUME_DOWN, true, 0,
              hid_usage::PAGE_CONSUMER));
    EXPECT_EQ(state_.editParam, 7);   // wrapped to Edit Pattern
    route(key(hid_usage::CONSUMER_VOLUME_UP, true, 0,
              hid_usage::PAGE_CONSUMER));
    EXPECT_EQ(state_.editParam, 0);   // back to Tempo
    route(key(hid_usage::CONSUMER_MUTE, true, 0,
              hid_usage::PAGE_CONSUMER));
    route(key(hid_usage::CONSUMER_VOLUME_UP, true, 0,
              hid_usage::PAGE_CONSUMER));
    EXPECT_EQ(state_.pendingRhythm.tempo, 121);
}
