t-bowzer/KCPico/keybchord/test/test_voicing.cpp

#include <gtest/gtest.h>

#include "voicing.h"


TEST(Voicing, RootPositionCMajor) {
    ResolvedChord c{0, ChordType::Major};
    auto v = voiceRootPosition(c, 60, 0, 48, 84);
    EXPECT_EQ(v, (std::vector<uint8_t>{60, 64, 67}));
}

TEST(Voicing, RootPositionFullRangeHigh) {
    ResolvedChord c{0, ChordType::Major};
    auto v = voiceRootPosition(c, 60, 3, 48, 84);  // +3 octaves -> C7
    EXPECT_EQ(v, (std::vector<uint8_t>{96, 100, 103}));
}

TEST(Voicing, RootPositionFullRangeLow) {
    ResolvedChord c{0, ChordType::Major};
    auto v = voiceRootPosition(c, 60, -3, 48, 84);  // -3 octaves -> C1
    EXPECT_EQ(v, (std::vector<uint8_t>{24, 28, 31}));
}

TEST(Voicing, RootPositionClampsToMidi) {
    ResolvedChord c{11, ChordType::Major};  // B major
    auto v = voiceRootPosition(c, 60, 3, 0, 127);
    for (uint8_t n : v) {
        EXPECT_GE(n, 0);
        EXPECT_LE(n, 127);
    }
}

TEST(Voicing, RootPositionOctaveClampsAtEdges) {
    ResolvedChord c{0, ChordType::Major};
    // Beyond the param range the root stays within [C1, C7], preserving pitch.
    auto high = voiceRootPosition(c, 60, 10, 0, 127);
    auto low  = voiceRootPosition(c, 60, -10, 0, 127);
    EXPECT_EQ(high, (std::vector<uint8_t>{96, 100, 103}));  // C7, not C14
    EXPECT_EQ(low,  (std::vector<uint8_t>{24, 28, 31}));    // C1, not C-6
}

TEST(Voicing, SmartFallsBackToRootPosition) {
    ResolvedChord c{0, ChordType::Major};
    auto v = voiceSmart(c, 60, 0, 48, 84, {});
    EXPECT_EQ(v, (std::vector<uint8_t>{60, 64, 67}));
}

TEST(Voicing, SmartVoiceLeadingMinimizesMovement) {
    ResolvedChord cmajor{0, ChordType::Major};  // C
    ResolvedChord fmajor{5, ChordType::Major};  // F

    std::vector<uint8_t> prev = {60, 64, 67};   // C4, E4, G4
    auto v = voiceSmart(fmajor, 60, 0, 48, 84, prev);

    // Nearest inversion of F major to C major root position is {60, 65, 69}.
    EXPECT_EQ(v, (std::vector<uint8_t>{60, 65, 69}));
}

TEST(Voicing, SmartDoesNotWalkDown) {
    ResolvedChord c{0, ChordType::Major};
    std::vector<uint8_t> prev = {60, 64, 67};
    // Many transitions must not cumulatively drift the voicing downward.
    int lowest = 60;
    for (int i = 0; i < 24; i++) {
        ResolvedChord next{static_cast<int>(i % 12), ChordType::Major};
        auto v = voiceSmart(next, 60, 0, 48, 84, prev);
        EXPECT_GE(v.front(), 48);  // stays within range
        EXPECT_LE(v.back(), 84);
        lowest = std::min(lowest, static_cast<int>(v.front()));
        prev = v;
    }
    EXPECT_GE(lowest, 48);  // never walked out the bottom of the range
}

TEST(Voicing, SmartProducesValidInversion) {
    ResolvedChord c{5, ChordType::Major};  // F major (F A C)
    std::vector<uint8_t> prev = {60, 64, 67};
    auto v = voiceSmart(c, 60, 0, 48, 84, prev);

    // All notes must be F, A, or C pitch classes.
    for (uint8_t n : v) {
        int pc = n % 12;
        EXPECT_TRUE(pc == 5 || pc == 9 || pc == 0);
    }
    for (size_t i = 1; i < v.size(); i++) {
        EXPECT_GT(v[i], v[i - 1]);  // ascending
    }
}

// VR-6: minimum note count pads with ascending octave notes.
TEST(Voicing, MinNotesPadsWithOctaveNotes) {
    ResolvedChord c{0, ChordType::Major};  // C major
    VoicingConfig cfg;
    cfg.min_notes = 4;
    auto v = voiceChord(c, 60, 0, 48, 84, cfg, {});
    EXPECT_EQ(v, (std::vector<uint8_t>{60, 64, 67, 72}));  // C E G C

    cfg.min_notes = 5;
    v = voiceChord(c, 60, 0, 48, 84, cfg, {});
    EXPECT_EQ(v, (std::vector<uint8_t>{60, 64, 67, 72, 76}));  // C E G C E
}

TEST(Voicing, MinNotesOnMaj7) {
    ResolvedChord c{0, ChordType::Maj7};  // C E G B
    VoicingConfig cfg;
    cfg.min_notes = 5;
    auto v = voiceChord(c, 60, 0, 48, 84, cfg, {});
    EXPECT_EQ(v, (std::vector<uint8_t>{60, 64, 67, 71, 72}));  // C E G B C
}

// VR-7: minimum interval spread — tightest ascending configuration.
TEST(Voicing, MinIntervalSpread) {
    ResolvedChord c{0, ChordType::Major};  // C major
    VoicingConfig cfg;
    cfg.min_interval = 5;
    auto v = voiceChord(c, 60, 0, 48, 84, cfg, {});
    EXPECT_EQ(v, (std::vector<uint8_t>{60, 67, 76}));  // C G E (tightest)

    cfg.min_interval = 4;
    v = voiceChord(c, 60, 0, 48, 84, cfg, {});
    EXPECT_EQ(v, (std::vector<uint8_t>{60, 67, 76}));  // C G E (not C E G)
}

// VR-8: manual inversions rotate the bass.
TEST(Voicing, ManualInversions) {
    ResolvedChord c{0, ChordType::Major};  // C major root {60,64,67}
    VoicingConfig cfg;

    cfg.inversion = InversionMode::First;
    EXPECT_EQ(voiceChord(c, 60, 0, 48, 84, cfg, {}),
              (std::vector<uint8_t>{64, 67, 72}));  // E G C

    cfg.inversion = InversionMode::Second;
    EXPECT_EQ(voiceChord(c, 60, 0, 48, 84, cfg, {}),
              (std::vector<uint8_t>{67, 72, 76}));  // G C E
}

// Regression: inversion bass must come from the interval order (root/3rd/5th),
// not the sorted pitch-class list. F major's 1st inversion is A in the bass —
// the old sorted-index code dropped to the root instead.
TEST(Voicing, InversionUsesIntervalOrderNotSortedPcs) {
    ResolvedChord f{5, ChordType::Major};  // F major (F A C)
    VoicingConfig cfg;
    cfg.inversion = InversionMode::First;
    EXPECT_EQ(voiceChord(f, 60, -1, 48, 84, cfg, {}),
              (std::vector<uint8_t>{57, 60, 65}));  // A3 C4 F4
}

// Inversion bass selection also fixes the min-interval spread for non-C roots:
// F major 1st inversion + min_interval 4 must put A (pc 9) in the bass.
TEST(Voicing, MinIntervalInversionUsesIntervalOrder) {
    ResolvedChord f{5, ChordType::Major};  // F major
    VoicingConfig cfg;
    cfg.inversion = InversionMode::First;
    cfg.min_interval = 4;
    EXPECT_EQ(voiceChord(f, 60, -1, 48, 84, cfg, {}),
              (std::vector<uint8_t>{57, 65, 72}));  // A3 F4 C5
}

// VR-7 composes with the voicing mode: smart picks the spread inversion nearest
// the previous voicing instead of always rebuilding from the root.
TEST(Voicing, MinIntervalFollowsSmart) {
    ResolvedChord f{5, ChordType::Major};  // F major (F A C)
    VoicingConfig cfg;
    cfg.voicing_mode = VoicingMode::Smart;
    cfg.min_interval = 4;

    std::vector<uint8_t> prev = {60, 64, 67};  // C major
    EXPECT_EQ(voiceChord(f, 60, 0, 48, 84, cfg, prev),
              (std::vector<uint8_t>{60, 65, 69}));  // C F A

    // Root position would place F in the bass instead.
    cfg.voicing_mode = VoicingMode::RootPosition;
    EXPECT_EQ(voiceChord(f, 60, 0, 48, 84, cfg, prev),
              (std::vector<uint8_t>{65, 72, 81}));  // F C A
}

// VR-7 composes with the directional modes: the spread must still descend/ascend
// relative to the previous voicing.
TEST(Voicing, MinIntervalFollowsDirection) {
    ResolvedChord f{5, ChordType::Major};  // F major
    VoicingConfig cfg;
    cfg.min_interval = 4;
    std::vector<uint8_t> prev = {60, 64, 67};  // C major

    cfg.voicing_mode = VoicingMode::Down;
    EXPECT_EQ(voiceChord(f, 60, 0, 48, 84, cfg, prev),
              (std::vector<uint8_t>{48, 53, 57}));  // C F A, below previous

    cfg.voicing_mode = VoicingMode::Up;
    EXPECT_EQ(voiceChord(f, 60, 0, 48, 84, cfg, prev),
              (std::vector<uint8_t>{60, 65, 69}));  // C F A, above previous
}

// Without a previous voicing the directional modes fall back to the root spread.
TEST(Voicing, MinIntervalDirectionalFallsBackToRootWhenEmpty) {
    ResolvedChord f{5, ChordType::Major};
    VoicingConfig cfg;
    cfg.min_interval = 4;

    cfg.voicing_mode = VoicingMode::Down;
    EXPECT_EQ(voiceChord(f, 60, 0, 48, 84, cfg, {}),
              (std::vector<uint8_t>{65, 72, 81}));
    cfg.voicing_mode = VoicingMode::Up;
    EXPECT_EQ(voiceChord(f, 60, 0, 48, 84, cfg, {}),
              (std::vector<uint8_t>{65, 72, 81}));
}

// A manual inversion still pins the bass pitch class while smart voice-leading
// chooses the nearest spread octave.
TEST(Voicing, MinIntervalInversionComposesWithSmart) {
    ResolvedChord f{5, ChordType::Major};  // F major
    VoicingConfig cfg;
    cfg.voicing_mode = VoicingMode::Smart;
    cfg.inversion = InversionMode::First;  // A in the bass
    cfg.min_interval = 4;

    std::vector<uint8_t> prev = {57, 60, 65};  // A3 C4 F4
    EXPECT_EQ(voiceChord(f, 60, -1, 48, 84, cfg, prev),
              (std::vector<uint8_t>{57, 65, 72}));  // A3 F4 C5
}

// The 3rd inversion of a triad (no 7th) wraps to the next octave instead of
// collapsing onto the 2nd inversion (which also uses the 5th as the bass).
TEST(Voicing, ThirdInversionOfTriadDistinct) {
    ResolvedChord c{0, ChordType::Major};  // C major
    VoicingConfig cfg;
    cfg.inversion = InversionMode::Second;
    auto second = voiceChord(c, 60, 0, 48, 84, cfg, {});
    EXPECT_EQ(second, (std::vector<uint8_t>{67, 72, 76}));  // G C E

    cfg.inversion = InversionMode::Third;
    auto third = voiceChord(c, 60, 0, 48, 84, cfg, {});
    EXPECT_EQ(third, (std::vector<uint8_t>{72, 76, 79}));   // C E G (up an octave)
    EXPECT_NE(second, third);
}

// Third inversion of a 7th chord puts the 7th in the bass (no wrap).
TEST(Voicing, ThirdInversionOfSeventhUsesSeventh) {
    ResolvedChord c{0, ChordType::Dom7};  // C7 (C E G Bb)
    VoicingConfig cfg;
    cfg.inversion = InversionMode::Third;
    EXPECT_EQ(voiceChord(c, 60, 0, 48, 84, cfg, {}),
              (std::vector<uint8_t>{70, 72, 76, 79}));  // Bb C E G
}

// Down: nearest voicing strictly below the previous (note-wise).
TEST(Voicing, DownWalksBelow) {
    ResolvedChord g{7, ChordType::Major};       // G major
    std::vector<uint8_t> prev = {60, 64, 67};   // C major
    auto v = voiceDown(g, 60, 0, 48, 84, prev);
    EXPECT_EQ(v, (std::vector<uint8_t>{59, 62, 67}));  // B3 D4 G4
}

// Up: nearest voicing strictly above the previous (note-wise).
TEST(Voicing, UpWalksAbove) {
    ResolvedChord g{7, ChordType::Major};
    std::vector<uint8_t> prev = {60, 64, 67};
    auto v = voiceUp(g, 60, 0, 48, 84, prev);
    EXPECT_EQ(v, (std::vector<uint8_t>{62, 67, 71}));  // D4 G4 B4
}

// With no previous voicing, both directions fall back to root position.
TEST(Voicing, DirectionalFallsBackToRootWhenEmpty) {
    ResolvedChord c{0, ChordType::Major};
    EXPECT_EQ(voiceDown(c, 60, 0, 48, 84, {}), (std::vector<uint8_t>{60, 64, 67}));
    EXPECT_EQ(voiceUp(c, 60, 0, 48, 84, {}), (std::vector<uint8_t>{60, 64, 67}));
}

// Directional voicing also applies between same-cardinality 7th chords.
TEST(Voicing, DirectionalSeventhToSeventh) {
    ResolvedChord g7{7, ChordType::Dom7};
    std::vector<uint8_t> prev = {60, 64, 67, 71};  // Cmaj7

    VoicingConfig cfg;
    cfg.voicing_mode = VoicingMode::Down;
    EXPECT_EQ(voiceChord(g7, 60, 0, 48, 84, cfg, prev),
              (std::vector<uint8_t>{59, 62, 65, 67}));

    cfg.voicing_mode = VoicingMode::Up;
    EXPECT_EQ(voiceChord(g7, 60, 0, 48, 84, cfg, prev),
              (std::vector<uint8_t>{62, 65, 67, 71}));
}

// When the chord cardinality changes, direction follows the bass note instead
// of silently snapping to root position.
TEST(Voicing, DirectionalHandlesCardinalityChange) {
    ResolvedChord g{7, ChordType::Major};
    std::vector<uint8_t> prev = {60, 64, 67, 71};  // Cmaj7

    VoicingConfig cfg;
    cfg.voicing_mode = VoicingMode::Down;
    EXPECT_EQ(voiceChord(g, 60, 0, 48, 84, cfg, prev),
              (std::vector<uint8_t>{59, 62, 67}));

    cfg.voicing_mode = VoicingMode::Up;
    EXPECT_EQ(voiceChord(g, 60, 0, 48, 84, cfg, prev),
              (std::vector<uint8_t>{62, 67, 71}));
}

// voiceChord dispatches to the directional modes.
TEST(Voicing, VoiceChordDownUpModes) {
    ResolvedChord g{7, ChordType::Major};
    VoicingConfig cfg;
    std::vector<uint8_t> prev = {60, 64, 67};

    cfg.voicing_mode = VoicingMode::Down;
    EXPECT_EQ(voiceChord(g, 60, 0, 48, 84, cfg, prev),
              (std::vector<uint8_t>{59, 62, 67}));

    cfg.voicing_mode = VoicingMode::Up;
    EXPECT_EQ(voiceChord(g, 60, 0, 48, 84, cfg, prev),
              (std::vector<uint8_t>{62, 67, 71}));
}
