t-bowzer/KCPico/keybchord/test/test_config.cpp

#include <gtest/gtest.h>
#include "config.h"
#include "storage_stub.h"
#include "params.h"


class ConfigTest : public ::testing::Test {
protected:
    void SetUp() override {
        storage_.clear();
    }
    StorageStub storage_;
};

TEST_F(ConfigTest, Defaults) {
    AppConfig cfg = AppConfig::defaults();
    EXPECT_TRUE(cfg.din_enabled);
    EXPECT_TRUE(cfg.usb_midi_enabled);
    EXPECT_FALSE(cfg.midi_clock_enabled);
    EXPECT_EQ(cfg.base_root_midi, 60);
    EXPECT_EQ(cfg.note_range_low, 48);
    EXPECT_EQ(cfg.note_range_high, 84);
    EXPECT_EQ(cfg.startup_preset, "B1:P1");
}

TEST_F(ConfigTest, LoadWhenMissingReturnsDefaults) {
    AppConfig cfg = AppConfig::load(storage_);
    EXPECT_TRUE(cfg.din_enabled);
    EXPECT_EQ(cfg.base_root_midi, 60);
}

TEST_F(ConfigTest, LoadEmptyConfigReturnsDefaults) {
    storage_.writeFile("/config.json", "");
    AppConfig cfg = AppConfig::load(storage_);
    EXPECT_TRUE(cfg.din_enabled);
}

TEST_F(ConfigTest, LoadInvalidJsonReturnsDefaults) {
    storage_.writeFile("/config.json", "{not valid json}");
    AppConfig cfg = AppConfig::load(storage_);
    EXPECT_TRUE(cfg.din_enabled);  // falls back to default
}

TEST_F(ConfigTest, LoadMinimalValidConfig) {
    const char* json = R"({"midi":{"din_enabled":false,"clock_enabled":true}})";
    storage_.writeFile("/config.json", json);
    AppConfig cfg = AppConfig::load(storage_);
    EXPECT_FALSE(cfg.din_enabled);
    EXPECT_TRUE(cfg.midi_clock_enabled);
    // Other fields use defaults
    EXPECT_EQ(cfg.base_root_midi, 60);
}

TEST_F(ConfigTest, UsbMidiEnabledDefaultsTrue) {
    AppConfig cfg = AppConfig::load(storage_);  // missing -> defaults
    EXPECT_TRUE(cfg.usb_midi_enabled);
}

TEST_F(ConfigTest, LoadUsbMidiEnabled) {
    const char* json = R"({"midi":{"usb_enabled":false}})";
    storage_.writeFile("/config.json", json);
    AppConfig cfg = AppConfig::load(storage_);
    EXPECT_FALSE(cfg.usb_midi_enabled);

    storage_.writeFile("/config.json", R"({"midi":{"usb_enabled":true}})");
    cfg = AppConfig::load(storage_);
    EXPECT_TRUE(cfg.usb_midi_enabled);
}

TEST_F(ConfigTest, UsbMidiEnabledRoundTrip) {
    AppConfig cfg = AppConfig::defaults();
    cfg.usb_midi_enabled = false;
    EXPECT_TRUE(cfg.save(storage_));

    AppConfig loaded = AppConfig::load(storage_);
    EXPECT_FALSE(loaded.usb_midi_enabled);
}

TEST_F(ConfigTest, LoadClampsOutOfRange) {
    const char* json = R"({"chord":{"base_root_midi":999,"note_range":[-10,999]}})";
    storage_.writeFile("/config.json", json);
    AppConfig cfg = AppConfig::load(storage_);
    EXPECT_EQ(cfg.base_root_midi, 60);     // clamped to default (64 is within range 0-127? No, 999 -> clamped to 127? Wait, the clamp uses fallback. Let me check the code...)
    // Actually clamping function uses the fallback value when out of range. So 999 > 127 falls back to default (60).
    // This is correct behavior per NFR-9: out-of-range values fall back to defaults.
}

TEST_F(ConfigTest, SaveAndLoadRoundTrip) {
    AppConfig cfg = AppConfig::defaults();
    cfg.din_enabled = false;
    cfg.base_root_midi = 72;
    cfg.note_range_low = 36;
    cfg.note_range_high = 96;
    cfg.midi_clock_enabled = true;

    EXPECT_TRUE(cfg.save(storage_));
    EXPECT_TRUE(storage_.exists("/config.json"));

    AppConfig loaded = AppConfig::load(storage_);
    EXPECT_EQ(loaded.din_enabled, cfg.din_enabled);
    EXPECT_EQ(loaded.base_root_midi, cfg.base_root_midi);
    EXPECT_EQ(loaded.note_range_low, cfg.note_range_low);
    EXPECT_EQ(loaded.note_range_high, cfg.note_range_high);
    EXPECT_EQ(loaded.midi_clock_enabled, cfg.midi_clock_enabled);
}

TEST_F(ConfigTest, LoadWithLedSettings) {
    const char* json = R"({"led":{"bpm_indicator":false,"flash_ms":50}})";
    storage_.writeFile("/config.json", json);
    AppConfig cfg = AppConfig::load(storage_);
    EXPECT_FALSE(cfg.bpm_indicator);
    EXPECT_EQ(cfg.led_flash_ms, 50);
}

TEST_F(ConfigTest, DefaultsForNewFields) {
    AppConfig cfg = AppConfig::defaults();
    EXPECT_EQ(cfg.cursor_timeout_ms, 5000);
    EXPECT_EQ(cfg.menu_timeout_ms, 10000);
    EXPECT_EQ(cfg.led_indicator, LedTarget::NumLock);
}

TEST_F(ConfigTest, LoadLedTargetChoice) {
    const char* json = R"({"led":{"led":"num_lock"}})";
    storage_.writeFile("/config.json", json);
    AppConfig cfg = AppConfig::load(storage_);
    EXPECT_EQ(cfg.led_indicator, LedTarget::NumLock);

    storage_.writeFile("/config.json", R"({"led":{"led":"caps_lock"}})");
    cfg = AppConfig::load(storage_);
    EXPECT_EQ(cfg.led_indicator, LedTarget::CapsLock);

    storage_.writeFile("/config.json", R"({"led":{"led":"scroll_lock"}})");
    cfg = AppConfig::load(storage_);
    EXPECT_EQ(cfg.led_indicator, LedTarget::ScrollLock);

    storage_.writeFile("/config.json", R"({"led":{"led":"all"}})");
    cfg = AppConfig::load(storage_);
    EXPECT_EQ(cfg.led_indicator, LedTarget::All);

    // Unknown value falls back to num lock.
    storage_.writeFile("/config.json", R"({"led":{"led":"bogus"}})");
    cfg = AppConfig::load(storage_);
    EXPECT_EQ(cfg.led_indicator, LedTarget::NumLock);
}

TEST_F(ConfigTest, LoadMenuTimeout) {
    const char* json = R"({"display":{"menu_timeout_ms":7000}})";
    storage_.writeFile("/config.json", json);
    AppConfig cfg = AppConfig::load(storage_);
    EXPECT_EQ(cfg.menu_timeout_ms, 7000);
}

TEST_F(ConfigTest, LedTargetRoundTrip) {
    AppConfig cfg = AppConfig::defaults();
    cfg.led_indicator = LedTarget::NumLock;
    EXPECT_TRUE(cfg.save(storage_));

    AppConfig loaded = AppConfig::load(storage_);
    EXPECT_EQ(loaded.led_indicator, LedTarget::NumLock);

    cfg.led_indicator = LedTarget::All;
    EXPECT_TRUE(cfg.save(storage_));
    loaded = AppConfig::load(storage_);
    EXPECT_EQ(loaded.led_indicator, LedTarget::All);
}

// --- NFR-9 hardening ---

TEST_F(ConfigTest, LoadTopLevelNonObjectReturnsDefaults) {
    storage_.writeFile("/config.json", "[1,2,3]");
    AppConfig cfg = AppConfig::load(storage_);
    EXPECT_TRUE(cfg.din_enabled);
    EXPECT_EQ(cfg.base_root_midi, 60);
}

TEST_F(ConfigTest, LoadTopLevelStringReturnsDefaults) {
    storage_.writeFile("/config.json", "\"hello\"");
    AppConfig cfg = AppConfig::load(storage_);
    EXPECT_TRUE(cfg.din_enabled);
}

TEST_F(ConfigTest, LoadWrongTypesFallBackPerField) {
    const char* json = R"({
        "midi":{"din_enabled":"yes","clock_enabled":42},
        "chord":{"base_root_midi":"high","note_range":[50,"x"]},
        "display":{"revert_timeout_ms":[]}
    })";
    storage_.writeFile("/config.json", json);
    AppConfig cfg = AppConfig::load(storage_);
    EXPECT_TRUE(cfg.din_enabled);       // string ignored -> default true
    EXPECT_FALSE(cfg.midi_clock_enabled);  // 42 is not bool -> default false
    EXPECT_EQ(cfg.base_root_midi, 60);  // string ignored -> default
    EXPECT_EQ(cfg.note_range_low, 48);  // "x" not int -> default
    EXPECT_EQ(cfg.display_revert_ms, 1500);
}

TEST_F(ConfigTest, LoadInvertedNoteRangeIsSwapped) {
    const char* json = R"({"chord":{"note_range":[100,20]}})";
    storage_.writeFile("/config.json", json);
    AppConfig cfg = AppConfig::load(storage_);
    EXPECT_LE(cfg.note_range_low, cfg.note_range_high);
    EXPECT_EQ(cfg.note_range_low, 20);
    EXPECT_EQ(cfg.note_range_high, 100);
}

TEST_F(ConfigTest, LoggingFieldsDefaults) {
    AppConfig cfg = AppConfig::defaults();
    EXPECT_TRUE(cfg.debug_log_enabled);
    EXPECT_TRUE(cfg.midi_monitor_enabled);
}

TEST_F(ConfigTest, LoadLoggingFields) {
    const char* json = R"({"logging":{"debug_log":false,"midi_monitor":false}})";
    storage_.writeFile("/config.json", json);
    AppConfig cfg = AppConfig::load(storage_);
    EXPECT_FALSE(cfg.debug_log_enabled);
    EXPECT_FALSE(cfg.midi_monitor_enabled);
}

TEST_F(ConfigTest, LoggingRoundTrip) {
    AppConfig cfg = AppConfig::defaults();
    cfg.debug_log_enabled = false;
    cfg.midi_monitor_enabled = false;
    EXPECT_TRUE(cfg.save(storage_));

    AppConfig loaded = AppConfig::load(storage_);
    EXPECT_FALSE(loaded.debug_log_enabled);
    EXPECT_FALSE(loaded.midi_monitor_enabled);
}
