t-bowzer/KCPico/keybchord/test/test_defaults.cpp

#include <gtest/gtest.h>

#include "defaults.h"
#include "storage_stub.h"
#include "config.h"
#include "presets.h"
#include "bass.h"
#include "rhythm.h"


TEST(Defaults, ProvisionsConfigPresetsAndRhythms) {
    StorageStub storage;
    provisionDefaults(storage);

    // Config written and loadable.
    EXPECT_TRUE(storage.exists("/config.json"));

    // 5 banks x 8 slots of presets written (each bank is one JSON file).
    for (int bank = 0; bank < NUM_BANKS; bank++) {
        char path[32];
        snprintf(path, sizeof(path), "/presets/bank%d.json", bank + 1);
        EXPECT_TRUE(storage.exists(path));
        for (int slot = 0; slot < NUM_SLOTS; slot++) {
            PresetSlot p = loadPreset(storage, bank, slot);
            EXPECT_EQ(p.chord.channel, DEFAULT_CHORD_CHANNEL);
            EXPECT_EQ(p.strum.channel, DEFAULT_STRUM_CHANNEL);
            EXPECT_EQ(p.rhythm.channel, DEFAULT_RHYTHM_CHANNEL);
        }
    }

    EXPECT_TRUE(storage.exists("/sequences"));

    // All 12 rhythms written and parseable.
    for (int i = 0; i < RHYTHM_COUNT; i++) {
        std::string path = "/rhythms/" + std::string(rhythmFileName(i));
        EXPECT_TRUE(storage.exists(path)) << path;
        RhythmPattern p;
        EXPECT_TRUE(parseRhythmPattern(storage.readFile(path), p)) << path;
        EXPECT_FALSE(p.tracks.empty()) << path;
        EXPECT_EQ(p.name, rhythmName(i)) << path;
    }

    // All 9 bass patterns written and parseable.
    for (int i = 0; i < BASS_COUNT; i++) {
        std::string path = "/bass/" + std::string(bassFileName(i));
        EXPECT_TRUE(storage.exists(path)) << path;
        BassPattern p;
        EXPECT_TRUE(parseBassPattern(storage.readFile(path), p)) << path;
        EXPECT_FALSE(p.steps.empty()) << path;
        EXPECT_EQ(p.name, bassName(i)) << path;
    }
}

TEST(Defaults, MigratesLegacyBanksAndSequences) {
    StorageStub storage;
    storage.writeFile("/presets/bank6.json", "[]");
    storage.writeFile("/presets/bank10.json", "[]");
    storage.writeFile("/sequences/b6p1.json", "{}");
    storage.writeFile("/presets/bank5.json", "[]");   // supported, stays
    storage.writeFile("/sequences/b5p1.json", "{}");

    EXPECT_EQ(migrateLegacyPresetBanks(storage), 3);
    EXPECT_FALSE(storage.exists("/presets/bank6.json"));
    EXPECT_FALSE(storage.exists("/presets/bank10.json"));
    EXPECT_FALSE(storage.exists("/sequences/b6p1.json"));
    EXPECT_TRUE(storage.exists("/presets/bank5.json"));
    EXPECT_TRUE(storage.exists("/sequences/b5p1.json"));
}
