t-bowzer/KCPico/(commit log)

2026-08-14 M2 complete: core framework, adapters, USB-CDC debug log, hardware verification
2026-08-14 M4 complete: strum plate (note pool, layouts, params, immediate pickup)
2026-08-15 M5 complete: rhythm engine (scheduler, clock, swing, drum map, LED)
2026-08-15 M6 complete: display manager + menu-driven parameter editing
    - LCD1602 adapter (hd44780/PCF8574, auto-probe 0x27/0x3F, null fallback)
    - DisplayManager: idle / menu / transient value / prompt screens
    - Menu-driven parameter editing (no modifier-key combos):
    - Menu key (or F10) = Chord Edit, Alt = Strum Edit, Ctrl = Rhythm Edit
    - F-keys select a parameter, +/- (or PageUp/Down) change its value, Esc exits
    - chord/strum keys stay live inside menus for immediate audible feedback
    - main-menu single-key shortcuts (keypad +/- = strum octave, number +/- = chord octave)
    - central param registry (param_edit) + EditEngine; chord/strum/rhythm engines trimmed to playback
    - presets moved to Super c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
    [main.cpp, test_chord_engine.cpp, test_display_manager.cpp, test_edit_engine.cpp, test_keymap.cpp, test_latching.cpp, test_naming.cpp]
2026-08-16 M7 complete: presets & banks, cursor navigation, clock-as-master redesign
    - PresetEngine: 80-slot cursor nav (Home/End, Super+Home/End, Enter load,
    Super+1..8), Insert=Save/Delete=Clear prompts, dirty tracking, startup preset
    - Cursor/menu idle timeouts, arrow-key param navigation, key-hold auto-repeat
    - Hotkey remap: F6 Clock Out, F10 beat LED, F12 Chord-Edit fallback
    - Configurable beat LED (default num_lock) with consistent short pulse and
    hardened non-sticking state machine
    - Master MIDI clock runs continuously from boot; LED and rhythm slave to it
    - Spec + roadmap sync'd; 243 native tests green
    [main.cpp, test_config.cpp, test_display_manager.cpp, test_edit_engine.cpp, test_keymap.cpp, test_param_edit.cpp, test_preset_engine.cpp]
2026-08-17 M8 complete: panic, hot-plug, watchdog, perf instrumentation, logging finalization
    - Panic: Super+Esc -> CC120/CC123 on all 16 channels + clear chord/strum/rhythm;
    Esc (main menu) cancels chord+strum only; hot-plug releases notes
    - NFR-1/NFR-2 instrumentation: PerfStats; per-event key-to-midi latency,
    Core-0 loop load, master-clock jitter (clock-jitter-us)
    - Keyboard hot-plug edge detection + rp2040 hardware watchdog (both cores)
    - Config validation hardening (non-object guard, note_range type/order checks)
    - Logging: KEYBCHORD_LOG compile gate + debug_log/midi_monitor runtime toggles,
    richer MIDI decode (note/CC/message names)
    - Cross-core state: std::atomic RhythmClock/LedIndicator
    -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
    [main.cpp, test_config.cpp, test_keymap.cpp, test_midi_router.cpp, test_naming.cpp, test_perf.cpp, test_rhythm_engine.cpp]
2026-08-17 M9 complete: USB Mass Storage + dev serial (FatFS, boot-key composite)
    - Storage migrated LittleFS -> FatFS (wear-leveled FTL); storage_fatfs replaces
    storage_littlefs; factory uses StorageFatFs
    - Self-provisioning: data/ image dropped; lib/core/defaults embeds config +
    10x8 presets + 12 rhythms (pretty-printed JSON), written on first boot
    - Mass Storage bridge (lib/hw/msc_fatfs): Adafruit_USBD_MSC over FatFS
    disk_read/disk_write; eject withdraws the drive and remounts FatFS
    - Boot-key composite: hold F11 at power-on to present the drive; CDC serial in
    both modes; preset save/clear suppressed + LCD notice while drive is active
    - Volume label "KeybChord" (f_setlabel); pretty JSON (ser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
    [main.cpp, test_defaults.cpp]
2026-08-22 M11 complete: hardware-test fixes (chord roll, extensions, bass, drum edit, tap tempo)
    - Chord roll: fix ms vs us unit bug in scheduleRoll
    - Extensions: append above base voicing (no min-interval re-spread), arp rebuild in place
    - Chord: overlapped switch resolves immediately in every play mode (no release-buffer delay/stutter)
    - Bass: follow chord changes, whole/half release early, hold follows new root, walk_no_6th pattern
    - Drum edit: velocity auto-repeat + Off option; tap tempo on Space
    - Native suite 317/317 green; pico build SUCCESS
    [config-menu-plan.txt]
2026-08-27 Add arp-hold mode, full-keyboard naming, user rhythms, and config guide
    - New arp-hold play mode (arpeggio that latches until next chord / Esc)
    - Preset naming supports numbers, shifted caps/symbols, and space/underscore
    - User rhythms: /rhythms/*.json files are discovered and appended after the
    12 built-ins (self-healing built-ins, name registry, dynamic count)
    - New docs/custom-configuration-guide.md covering config/preset/keymap/rhythm JSON
    - Fix stale spec section 8 (config.json example, play_mode arp_hold)
    - Add examples/test_rhythm.json for verifying user rhythms
    - Configurable keymap (/keymap.json), menu rework, voicing modes, preset naming
    - Native tests: 381 passing
    [config-menu-plan.txt]
2026-08-27 Prepare repo for release
    - Remove internal session summaries, planning notes, and test plans (23 files)
    - Move the product spec into docs/ and fix dangling references in wiring.md
    - Add README.md (overview, build/flash, customization, docs links)
    - Add .github/workflows/release.yml to build firmware.uf2 on v* tags
    [config-menu-plan.txt]
2026-08-28 Replace GPLv3 hd44780 with in-house LCD driver
    - Rewrite LcdHd44780 to drive the PCF8574 backpack directly over I2C (4-bit
    mode), removing the GPLv3 hd44780 dependency so the project stays MIT
    - Drop duinowitchery/hd44780 from platformio.ini lib_deps
    - Add THIRD_PARTY_LICENSES.md documenting all dependencies and their licenses
2026-08-28 Make bass patterns JSON-configurable; add pattern short names
    - Convert bass patterns to /bass/*.json (16th-note chord-degree grid,
    sustain_steps, hold flag) with 9 embedded built-ins, self-provisioning,
    and user-file loading after them
    - Replace the BassPattern enum with a list index; resolve bass pattern by
    name in presets and keymap (rhythm+bass patterns now nameable)
    - Fire bass on every 16th-note step; chop the bar to the rhythm's meter
    for shorter meters (e.g. 3/4 waltz)
    - Add optional rhythm short_name field (2-char LCD code) with fallback to
    built-in code / first two letters of name
    - Update docs, examples, and unit tests
    [main.cpp, test_bass.cpp, test_bass_engine.cpp, test_defaults.cpp, test_edit_engine.cpp, test_keymap_config.cpp, test_naming.cpp, test_presets.cpp]
2026-09-24 Add Esc-at-boot USB bootloader entry for enclosed reflashing
    Hold Esc at power-on to reboot into the ROM bootloader (BOOTSEL) so the
    Pico can be reflashed via USB without opening the enclosure. Ctrl-at-boot
    still presents the FatFS Mass Storage drive.
    Rework the boot-key scan to wait for the first HID report plus a settle
    grace (a held Esc can arrive after the modifier byte), and stop Core 1
    before reset_usb_boot() to avoid its TinyUSB/watchdog activity racing
    the bootrom reset.
    [main.cpp]
2026-10-01 Add USB MIDI out (M11) with test hook and hardware harness
    Native USB port enumerates as a composite CDC (debug) + MIDI device; the
    MIDI router fans every outgoing message to both USB MIDI and DIN, gated by
    midi.usb_enabled (default on). Adds a gated CDC test-command hook
    ([env:testhook]) and a host-side Python harness asserting USB == DIN, plus
    the hardware test plan and configurator/docs updates.
2026-10-07 M12: TRS MIDI out + power switch wiring/spec docs
2026-10-07 M13: chord patterns — engine, JSON format, configurator, docs
2026-10-12 Adopt CH559 USB-host coprocessor (M12): spec, wiring, BOM, flashing docs
2026-10-23 Implement CH559 firmware fork (M12): UART1 bridge, boot protocol, LED relay
    - Emit the host protocol on UART1 (P2.6/P2.7) at 115200 instead of UART0 @ 1 Mbps
    - Force HID boot protocol during enumeration for standard 8-byte reports
    - Relay keyboard LED SET_REPORT via the 0xED command from the RP2040
    - Fix UART1 pin mode: PIN_MOD1 (010 -> P2.6/P2.7), written after DLAB clears
    - Fix UART1 baud divisor: CH559 uses 8x oversampling, not 16x
2026-10-23 Add RP2040 CH559 UART-bridge input adapter (M12)
    - ch559_protocol.h: 0xFE-delimited streaming frame parser
    - hid_report.h: shared boot-report parser extracted from InputUsbHost
    - input_ch559: Serial1 @115200 adapter feeding KeyEvents + 0xED LED relay
    - factory/pins/platformio: KEYBCHORD_CH559 build (pico-ch559 env)
    - test_ch559.cpp: native parser/report unit tests
2026-10-23 M12: CH559 breakout integration guide, test plan, wiring, schematic
    - docs/ch559-breakout-integration-guide.md: step-by-step breakout bring-up
    - hardware-test-plan-ch559.md: M12 bring-up plan
    - docs/wiring.md/.png: bare-chip CH559 wiring + flashing
    - KCPico.kicad_sch: board schematic with the CH559 host coprocessor
2026-10-26 Hardware: add SW3 Omron B3FS tactile switch on RP2040 AIN3
2026-10-28 Add MIDI macro libraries and startup device detection
    Firmware: support arbitrary MIDI byte streams in macros (including SysEx), with cumulative delays and DIN/USB output. Add raw-byte sends to MIDI adapters and validation/round-trip tests.
    Configurator: add structured MIDI message editing, JSON command libraries, bundled Roland JD-Xi program/tone/control libraries with channel selection and 25 ms bank-select delays, and startup detection/prompt for a mounted KeybChord drive.
2026-10-28 Add eject auto-reboot and firmware info screen
    Firmware: detect the host MSC eject via the Start-Stop callback and reboot after a 1 s grace period so setup reloads the edited files. Stop Core 1 before resetting so its watchdog feed cannot block the reboot; keep the handler active even on the keymap-error screen.
    Firmware: add a hard-coded Ctrl+Esc debug screen showing the firmware version and first 8 chars of the build commit. Inject the commit hash through a PlatformIO pre-build script and keep the version in version.h.
    Configurator: power off Linux USB mass storage after unmount so the device sees a real eject, and report that the KeybChord will reboot.
    Tests/docs updated for both behav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
2026-10-28 Fix CH559 input/LED handling and retire PIO-USB build
    - Enumerate keyboards already attached at CH559 power-up/reset by polling root-hub attach levels.
    - Route keyboard LED SET_REPORT through hostCtrlTransfer's control-write path and copy OUT payloads into TxBuffer.
    - Make the CH559 UART bridge the sole input path: remove the PIO-USB adapter, build env, dependency, and stale docs/references.
2026-10-28 Add consumer media keys and two-phase edit menus
    - Forward and parse Consumer Control reports from the CH559, including QMK shared-endpoint media keys and a descriptor-independent fallback.
    - Make Volume +/- and Mute fixed controls: volume scrolls/edits menus or tempo on the main screen; Mute acts like Enter.
    - Rework edit menus to browse parameters with arrows/volume, select with Enter/Mute, commit with Enter/Mute, and cancel with Backspace/Esc.
    - Add selected-parameter display marker, remove in-menu F-key shortcuts, and update configurator/docs/tests.
2026-10-29 M14: add chord sequencer and timing fixes
    Implement per-preset chord sequences (10 slots, 1/2/4/8 bars, 64 events), count-in recording with muted pattern and one-bar hi-hat guide, looping playback with live-chord override, configurator sequence editor, and flash-budget/preset-count migration.
    Also tighten beat LED/clock timing: 1 ms main loop, MIDI clock-out beat-boundary start, tempo-change re-sync, persistent recording display, and clock/sequencer step alignment.
2026-11-02 Add arp rates and sequence settings persistence
    Also fix the arpeggiator firing one clock tick early by publishing the last emitted tick, and keep the configurator LED target from reverting to Num Lock.
2026-11-13 Release v0.2.0: pattern editors and hardware verification
    Add the on-device bass/rhythm/chord pattern editors, M16 configurator support, and the remaining M17 documentation and tests. Update the CH559 v0.2 hardware docs for the single P4.6 BOOT button and J5 3V3 NC, record M12/M14/M17 hardware verification, and bump the configurator to 0.2.0.
2026-11-14 M18: add hardware decisions, BOM, and 1 MB filesystem
